arjun7n9s/AgriBot/CREDITS.md

# Credits

The SCARA base design is adapted from HowToMechatronics (https://howtomechatronics.com).

AgriBOT authored everything else here, including:
- the Arm 2 redesign
- the tomato cutter
- the side mast
- the rover integration
- the simulation assets and robot description
- all tooling and documentation

The original CAD is in `media/scara-arm/`. The meshes generated from it are in `sim/agribot_description/meshes/scara/`.
