arjun7n9s/AgriBot/notes.md

---
format: 2
description: AgriBOT tomato rover — hardware, bill of materials, and simulation.
taskPrefix: AB
---
## Tasks
### In Progress
- [ ] **AB-8** Desktop AgriBOT context folder on this machine
### For Review
- [ ] **AB-2** Install Ubuntu 22.04 on the 5060 so Isaac Sim 5.0 can run
- [ ] **AB-3** Place the OnlyScrews, Robocraze, Robokits, and Robu orders — [Hardware order list](/cursor/stores/bc-d1b8e747-87e9-4a20-9cfe-d9339460fb08/docs/hardware-order-list.docx)
- [ ] **AB-4** Redesign and print arm 2 and the gripper — [Already procured](/cursor/stores/bc-d1b8e747-87e9-4a20-9cfe-d9339460fb08/docs/already-procured.md)
- [ ] **AB-5** Name the forward and reverse header pins on the bench — [Board note](/cursor/stores/bc-d1b8e747-87e9-4a20-9cfe-d9339460fb08/docs/rover-control-board.md)
### Queued
- [ ] **AB-1** Funding bill of materials — [Bill of materials](/cursor/stores/bc-d1b8e747-87e9-4a20-9cfe-d9339460fb08/docs/bill-of-materials.docx)
- [ ] **AB-6** Field simulation on the two laptops — [Work pathway](/cursor/stores/bc-d1b8e747-87e9-4a20-9cfe-d9339460fb08/docs/work-plan.md)
### Done
- [x] **AB-7** Amazon order placed: limit switches, 6806-ZZ, 6807-ZZ, 51107, 51108, and the ESP32-S3
