arjun7n9s/AgriBot/docs/already-procured.md

# Already procured

Source copy: [already-procured-list.docx](already-procured-list.docx) (WhatsApp export `DOC-20260910-WA0005`).

The sheet title is **SCARA ARM — PURCHASED ITEMS**. It has one group, **Purchased List**, and one table. Columns in the source are No., Item, Specification, and Quantity.

**11 line items.** Price is blank on every row because the sheet has no price column. Shop is blank on every row because the sheet has no shop column. The document has no total.

## Purchased List

| No. | Item | Specification | Quantity | Price | Shop |
| --- | --- | --- | --- | --- | --- |
| 1 | Smooth rod shaft | 10 mm dia × 400 mm length | 4 pcs | blank | blank |
| 2 | Lead screw | 8 mm × 400 mm | 1 pc | blank | blank |
| 3 | Linear ball bearing (LM10LUU) | 10 mm bore × 19 mm OD × 29 mm long | 5 pcs | blank | blank |
| 4 | Deep groove ball bearing (608RS) | 8 × 22 × 7 mm, rubber sealed | 5 pcs | blank | blank |
| 5 | Thrust ball bearing | 35 mm × 52 mm × 12 mm | 2 pcs | blank | blank |
| 6 | Thrust ball bearing | 40 mm × 60 mm × 13 mm | 1 pc | blank | blank |
| 7 | NEMA17 stepper motor (economy) | 4.2 kg·cm, D-shaft, without gearbox | 2 pcs | blank | blank |
| 8 | NEMA17 stepper + DM542 driver kit | 7 kg·cm motor with DM542 digital microstepping driver (4.2 A, 18–50 V DC) | 1 set | blank | blank |
| 9 | NEMA17 stepper motor (premium) | 7 kg·cm, without gearbox | 1 pc | blank | blank |
| 10 | A4988 stepper motor driver | Carrier / breakout module | 4 pcs | blank | blank |
| 11 | MG996R digital servo motor | High-torque metal-gear servo | 2 pcs | blank | blank |

## Overlap with the still-to-buy list

Compared with `docs/hardware-order-list.docx`. That order list was not edited.

Two overlaps. Both are thrust bearings. The procured sheet gives dimensions and does not name 51107 or 51108. Those designations on the order list are the same sizes (51107 is 35 × 52 × 12 mm; 51108 is 40 × 60 × 13 mm). Quantities differ.

- Thrust ball bearing, 35 mm × 52 mm × 12 mm, **2 pcs** already bought — same size as order line **1 × 51107 thrust ball bearing**, ₹197.00, Amazon.in.
- Thrust ball bearing, 40 mm × 60 mm × 13 mm, **1 pc** already bought — same size as order line **2 × 51108 thrust ball bearing, 1 piece**, ₹440.00, Amazon.in.

No other procured line matches an order-list line. The order-list deep-groove bearings are 6806-ZZ and 6807-ZZ. The procured deep-groove bearing is 608RS (8 × 22 × 7 mm). Those are different sizes.
