arjun7n9s/AgriBot/internal/board-crosscheck.md

---
cursor:
  subagentId: "bc-b77851f0-87f7-55c2-8c64-350e7d4dbb0f"
---

# Independent photo cross-check

This is limited to what is visible in the supplied photos. It does not establish circuit functions, pinouts, copper connectivity, or radio protocol.

## Visible facts — vehicle controller

- The blue, two-sided PCB is marked `HH-8130K-RXT2` on both faces.
- The component side has two large aluminium heatsinks, a green disc component marked `2A104J`, a white multi-contact board-edge connector, several metal blade terminals, and two visible large electrolytic capacitors at one end.
- A large black housing is visibly marked `YX306H-S-112G`, `16A 250VAC`, and `16A 30VDC`. The manufacturer word above the part number appears to read `YONGSENG`.
- A metal-can component is visibly marked `16.000 MHz`.
- Two adjacent 8-pin ICs have the same visible top marking, `CSC2111FL`; their second-line marking appears to be `AVFay`.
- The controller's larger low-pin-count IC near the `16.000 MHz` can has an indistinct top code; its identity is unknown.
- The white connector's nearby individual pin labels are only partly legible in the oblique photo. They cannot be transcribed reliably.
- The reverse side visibly has routed copper traces, plated through-holes, and the through-hole solder joints for the connector, heatsinks/terminals, and other parts. A full trace map cannot be determined from these photos.

## Visible facts — handheld controller

- The green PCB is marked `HH-6611YTX-B-YB` and `JY14155`.
- It has six visibly labelled tactile buttons: `F`, `S`, `B`, `P`, `R`, and `M`.
- It has battery contacts marked `+` and `−`.
- Three LED reference designators are visible: `LED1`, `LED2`, and `LED3`.
- A metal-can component is marked `16.000 MHz`; the nearby IC has a partially legible code that appears to begin `2537`, but the complete marking is unknown.
- The remote PCB is shown only on its component side. No protocol, operating frequency, antenna connection, or pairing method is visible or established by these photos.

## Questions for Tejesh

1. Please take a level, sharply focused macro photo of the controller component side with the heatsinks and terminals not obscuring the IC markings or silkscreen. In particular, the main IC's complete top marking is unknown.
2. Please take a straight-on macro of the white controller connector, including every pin label and the connector face with its plug fitted. Which vehicle-harness wire colour goes to each position is unknown.
3. Please photograph the controller installed in the vehicle with every blade terminal connected, showing wire colours and destination (battery, each motor, switches, etc.). The terminal functions cannot be inferred from the bare board photos.
4. Please provide a sharp photo of both sides of the handheld-controller PCB, especially any antenna, wire, or component not visible on the photographed side. Its radio/protocol details are unknown.
5. Please state the battery-pack voltage and the exact vehicle/controller product markings. They are not visible in the supplied photos.
