arjun7n9s/AgriBot/internal/board-routing-crosscheck.md

---
cursor:
  subagentId: "bc-b77851f0-87f7-55c2-8c64-350e7d4dbb0f"
---

# Independent routing-photo cross-check — full re-read

This report is based only on the twelve files listed below. It records visible copper, parts, and markings; it does not establish pinouts, complete nets, component functions, or protocol.

## Files opened

- `routing-01.png`
- `routing-02.png`
- `routing-03.png`
- `routing-04.png`
- `routing-05.png`
- `routing-06.png`
- `routing-07.png`
- `routing-08.png`
- `routing-09.png`
- `routing-10.png`
- `routing-11.png`
- `routing-12.png`

## Markings transcribed from the photos

- PCB: `HH-8130K-RXT2`.
- Large black rectangular part: `YONGSENG`, `YX306H-S-112G`, `16A 250VAC`, and `16A 30VDC`.
- Blade-terminal area in routing-10: `+/−` is legible beside the leftmost of the three visible blade-terminal groups along the lower edge (white multi-contact connector at the upper left).
- Small white two-contact connector in the lower-right of routing-10: `RA`.

The other two blade-terminal-group labels are **unknown**. The images do not resolve their complete characters, so `F1B` and `F1A` are not retained as transcriptions.

## Visible copper observations

- Both PCB faces are shown. The reverse face is clearest in `routing-11.png` and `routing-12.png`.
- On that reverse face, a set of narrow, parallel trace segments is visible from the vertical row of solder joints at the right side of the image, continuing around the lower portion toward nearby through-hole-pad groups. Their complete endpoints are unknown.
- A separate long trace segment is visible close to the lower board edge. It passes between/near several lower pad groups; its complete route and net are unknown.
- Broader copper features and many vias are visible around the large through-hole pad regions on the reverse face. Their full interconnections are unknown.
- Backlighting in `routing-02.png` through `routing-07.png` reveals some narrow component-side traces near the white multi-contact connector, but parts, heatsinks, shadow, and glare hide several junctions. Complete routes are unknown.

## Unknowns and questions for Tejesh

1. The exact silkscreen at the middle and right blade-terminal groups is unknown. Please take a square-on macro of those labels under diffuse light.
2. The individual labels and pin count for the large white multi-contact connector are unknown. Please photograph its face and adjacent silkscreen sharply, preferably with the mating plug fitted.
3. The visible trace segments do not establish complete nets or connector-to-terminal connections. Please provide continuity readings from each connector contact and blade-terminal pad to the first exposed trace/pad, or clear unobstructed photos of those transitions.
4. Copper and component markings hidden by the heatsinks are unknown. If safe, please provide additional angled photos that expose the obscured pads and markings.
