arjun7n9s/AgriBot/docs/already-procured-list.docx

SCARA ARM — PURCHASED ITEMS

Purchased List

No. | Item | Specification | Quantity
1 | Smooth rod shaft | 10 mm dia × 400 mm length | 4 pcs
2 | Lead screw | 8 mm × 400 mm | 1 pc
3 | Linear ball bearing (LM10LUU) | 10 mm bore × 19 mm OD × 29 mm long | 5 pcs
4 | Deep groove ball bearing (608RS) | 8 × 22 × 7 mm, rubber sealed | 5 pcs
5 | Thrust ball bearing | 35 mm × 52 mm × 12 mm | 2 pcs
6 | Thrust ball bearing | 40 mm × 60 mm × 13 mm | 1 pc
7 | NEMA17 stepper motor (economy) | 4.2 kg·cm, D-shaft, without gearbox | 2 pcs
8 | NEMA17 stepper + DM542 driver kit | 7 kg·cm motor with DM542 digital microstepping driver (4.2 A, 18–50 V DC) | 1 set
9 | NEMA17 stepper motor (premium) | 7 kg·cm, without gearbox | 1 pc
10 | A4988 stepper motor driver | Carrier / breakout module | 4 pcs
11 | MG996R digital servo motor | High-torque metal-gear servo | 2 pcs

SCARA Arm — Purchased Items
