arjun7n9s/AgriBot/docs/images/end_effector_front.png

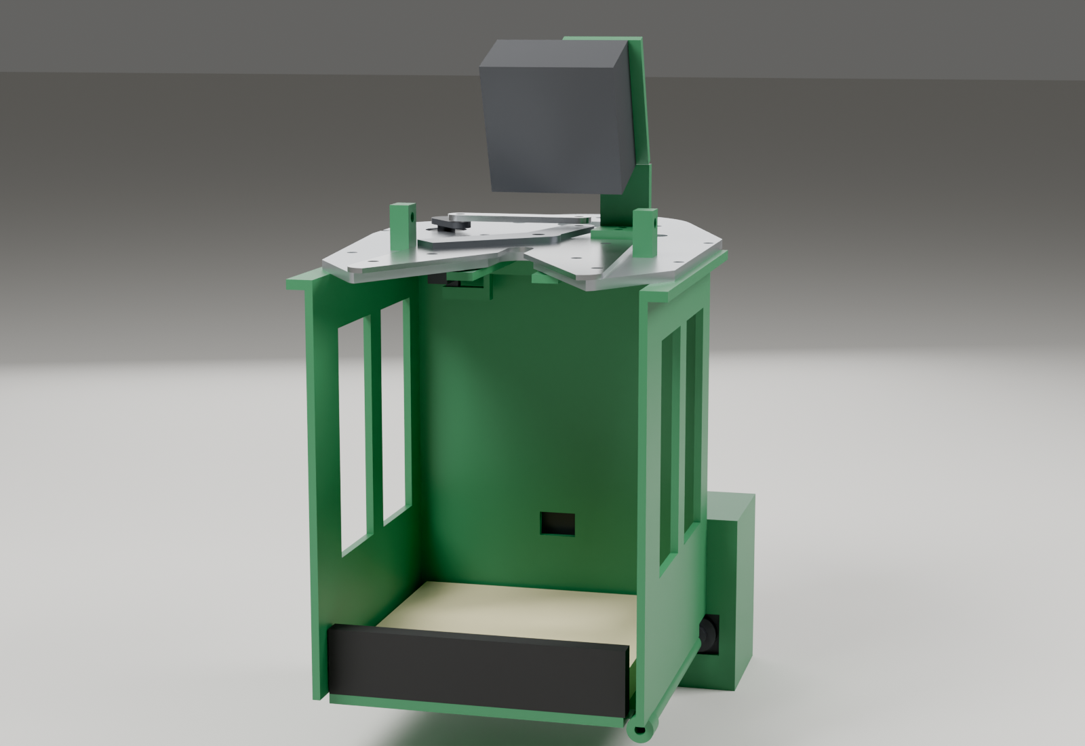
docs/images/end_effector_front.png
