arjun7n9s/AgriBot/docs/images/scara_preview.png

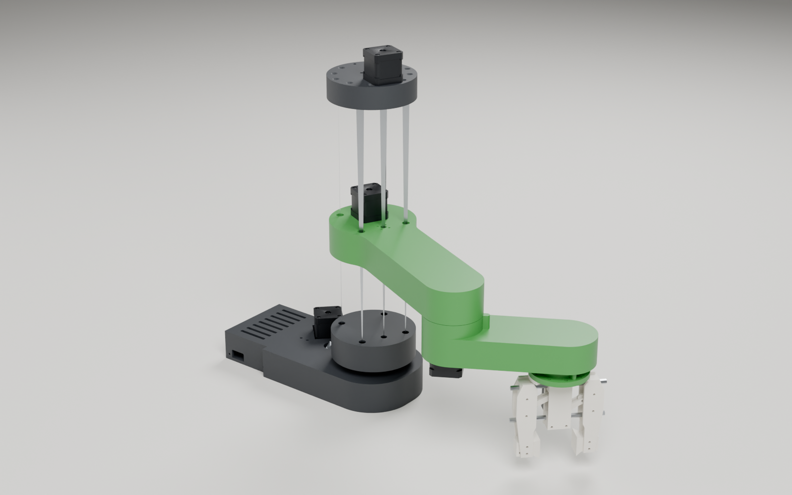
docs/images/scara_preview.png
