arjun7n9s/AgriBot/docs/images/tomato_plant.png

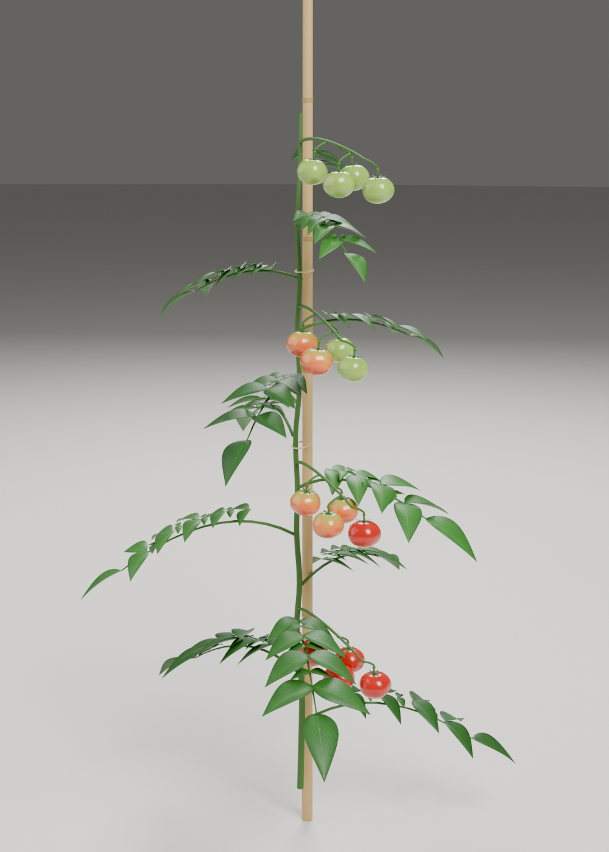
docs/images/tomato_plant.png
