arjun7n9s/AgriBot/media/motor-controller/image-1791056318386.jpg

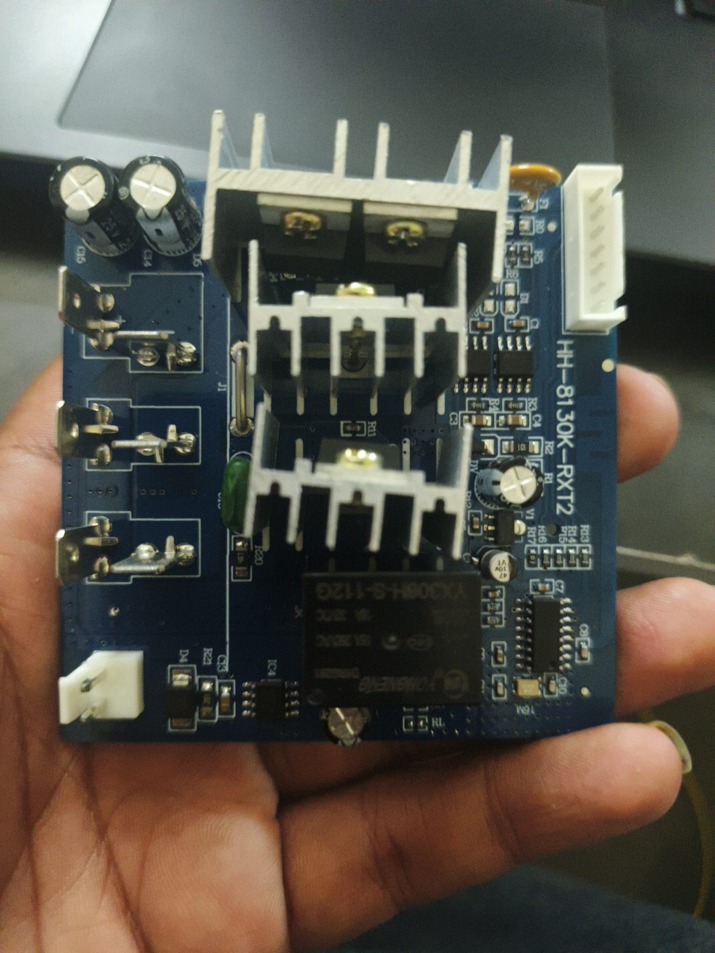
media/motor-controller/image-1791056318386.jpg
