arjun7n9s/AgriBot/media/motor-controller/IMG_20261004_010436_945.jpg

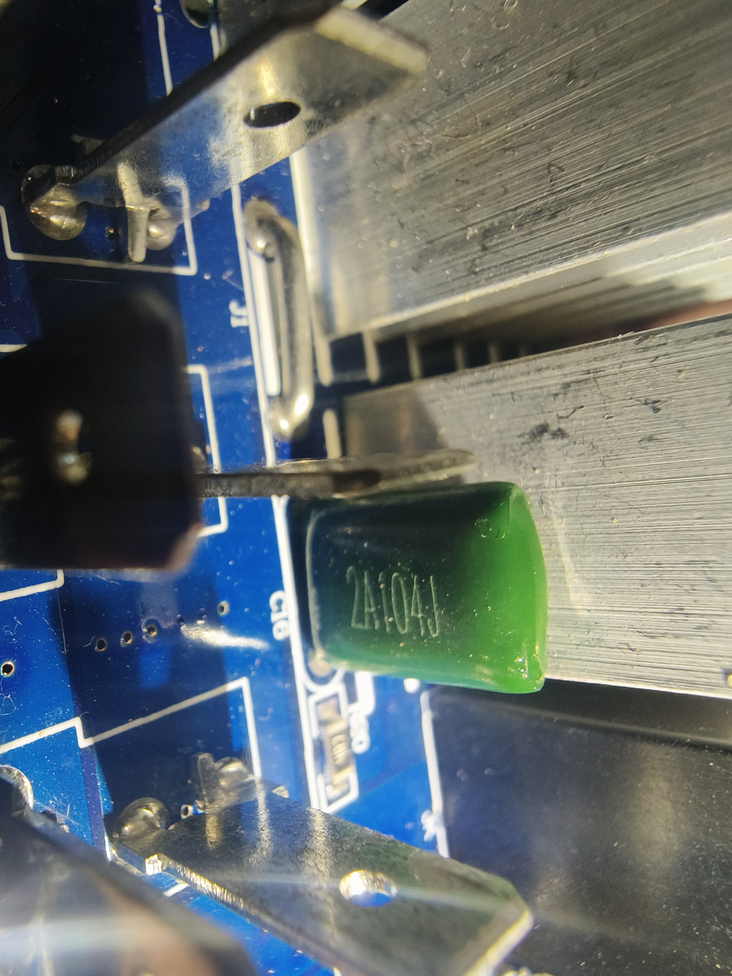
media/motor-controller/IMG_20261004_010436_945.jpg
