arjun7n9s/AgriBot/media/motor-controller/IMG_20261004_010446_893.jpg

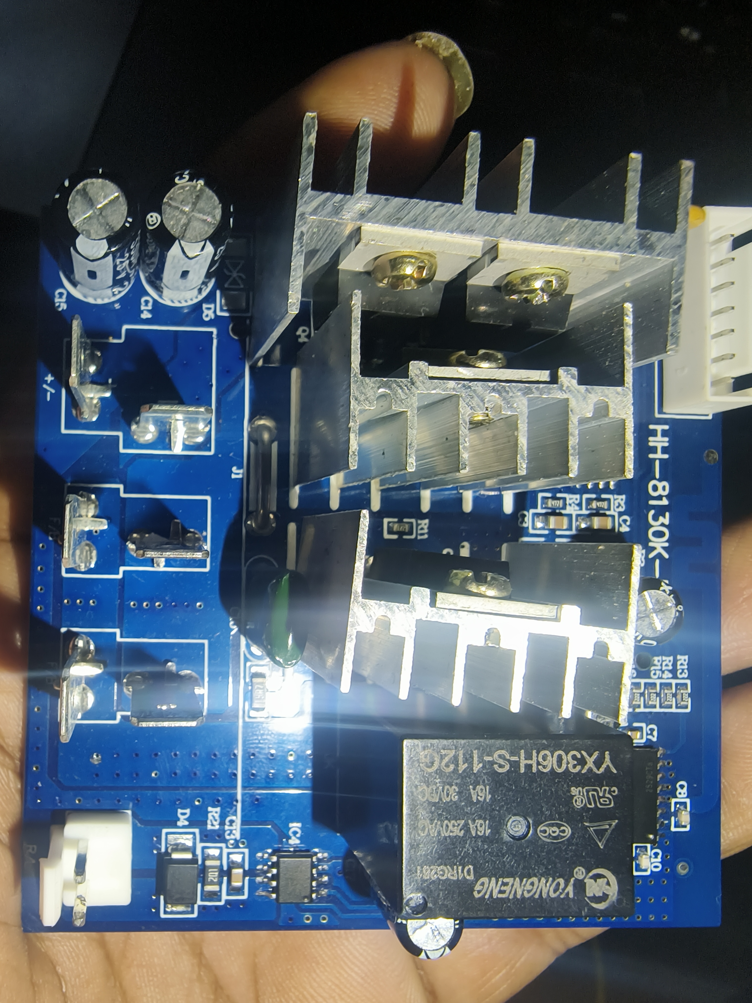
media/motor-controller/IMG_20261004_010446_893.jpg
