arjun7n9s/AgriBot/media/motor-controller/IMG_20261004_010451_744.jpg

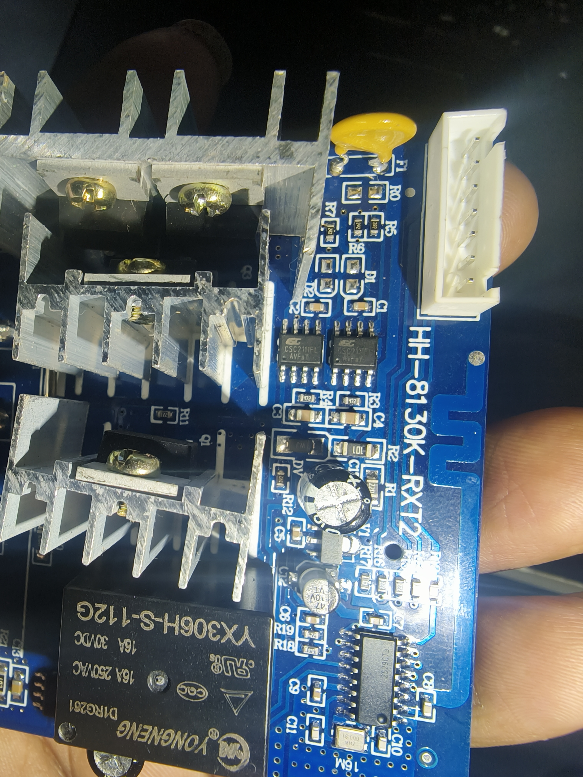
media/motor-controller/IMG_20261004_010451_744.jpg
