arjun7n9s/AgriBot/media/motor-controller/IMG_20261004_010502_342.jpg

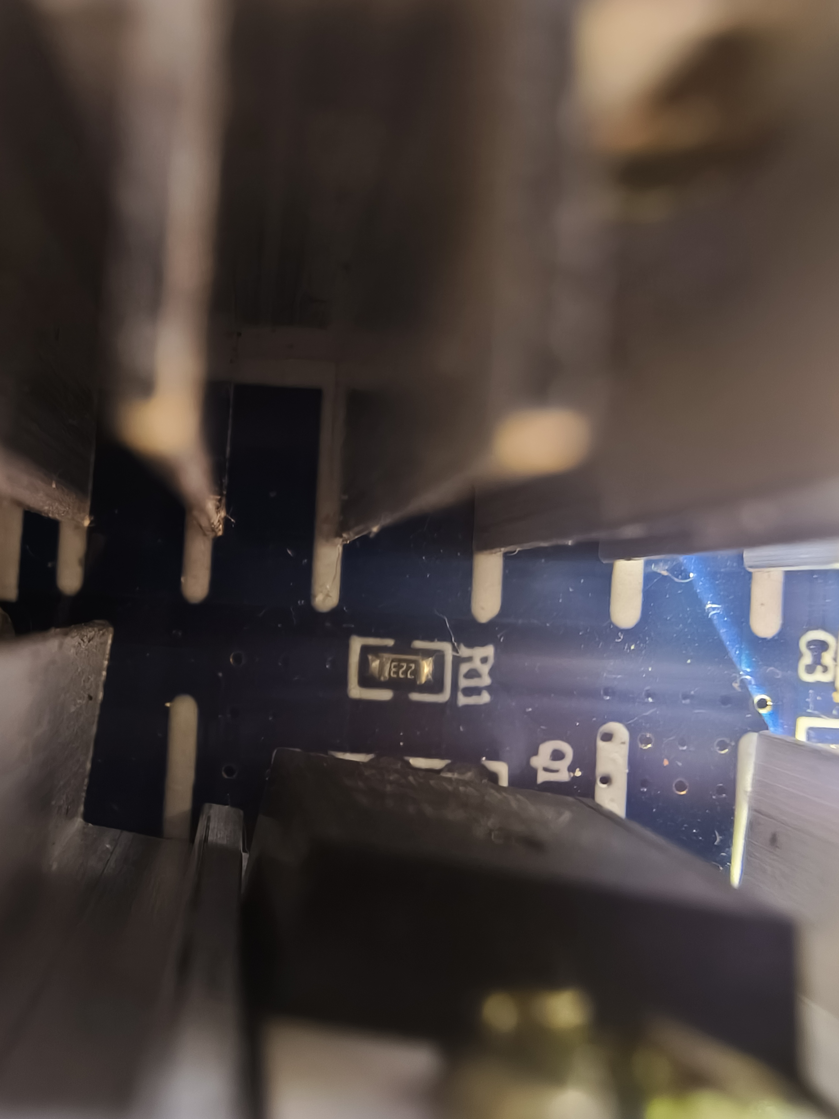
media/motor-controller/IMG_20261004_010502_342.jpg
