arjun7n9s/AgriBot/media/motor-controller/IMG_20261004_010509_731.jpg

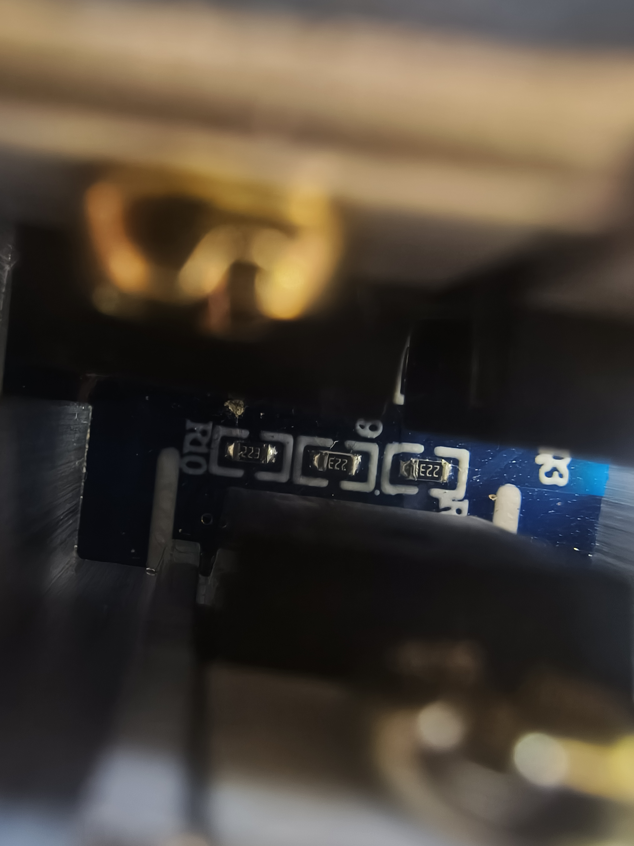
media/motor-controller/IMG_20261004_010509_731.jpg
