arjun7n9s/AgriBot/media/motor-controller/IMG_20261004_010517_841.jpg

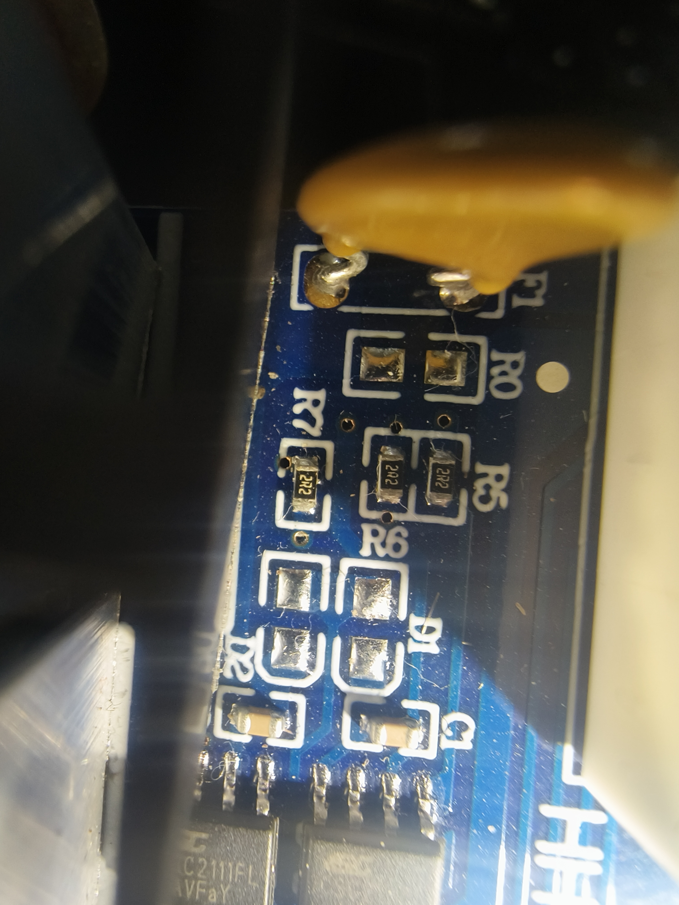
media/motor-controller/IMG_20261004_010517_841.jpg
