arjun7n9s/AgriBot/media/motor-controller/IMG_20261004_010523_438.jpg

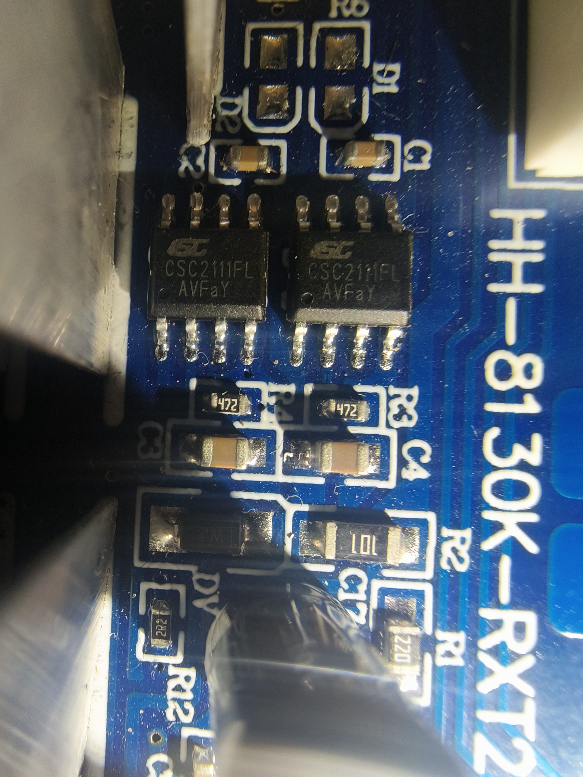
media/motor-controller/IMG_20261004_010523_438.jpg
