arjun7n9s/AgriBot/media/motor-controller/IMG_20261004_010541_978.jpg

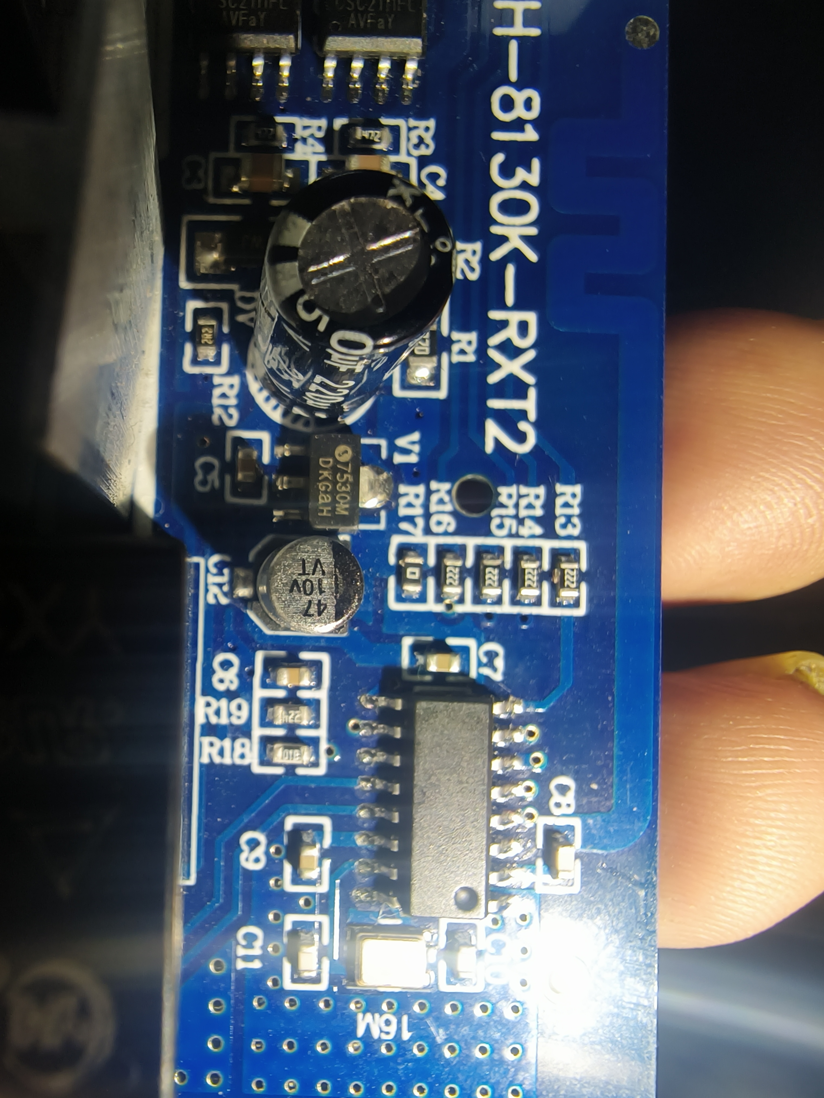
media/motor-controller/IMG_20261004_010541_978.jpg
