arjun7n9s/AgriBot/media/motor-controller/IMG_20261004_010549_902.jpg

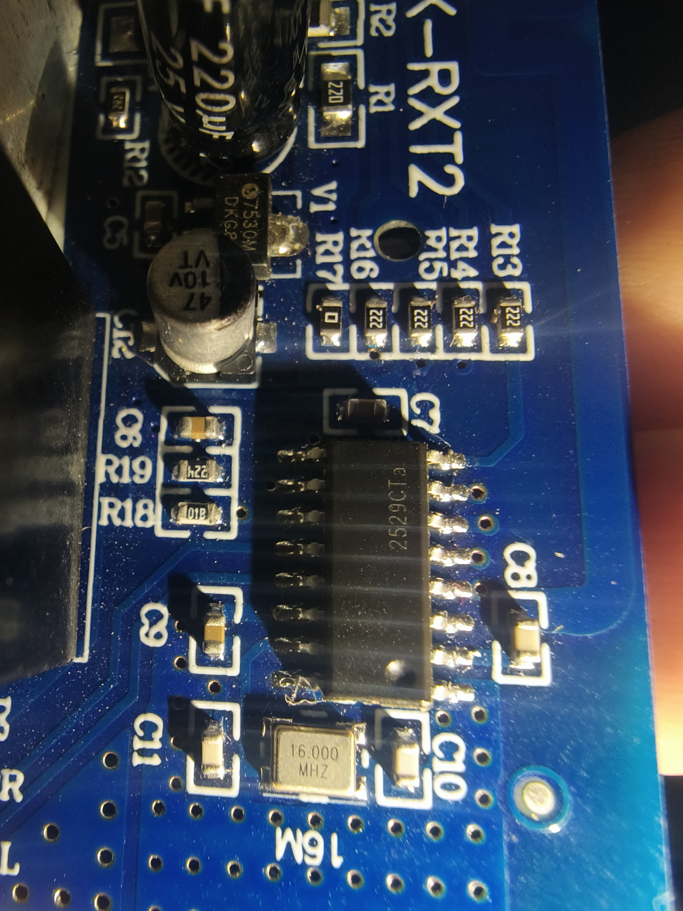
media/motor-controller/IMG_20261004_010549_902.jpg
