arjun7n9s/AgriBot/media/motor-controller/IMG_20261004_010600_459.jpg

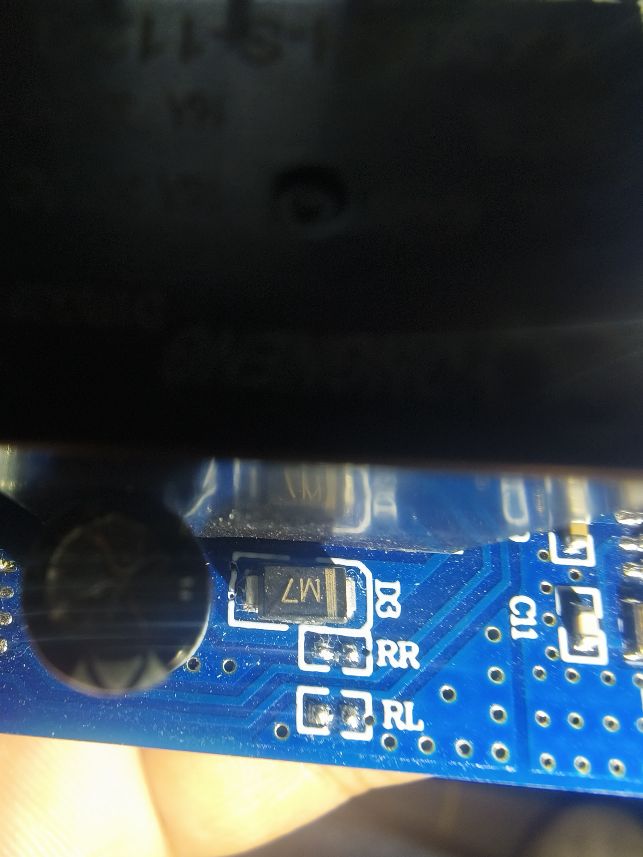
media/motor-controller/IMG_20261004_010600_459.jpg
