arjun7n9s/AgriBot/media/motor-controller/IMG_20261004_010603_548.jpg

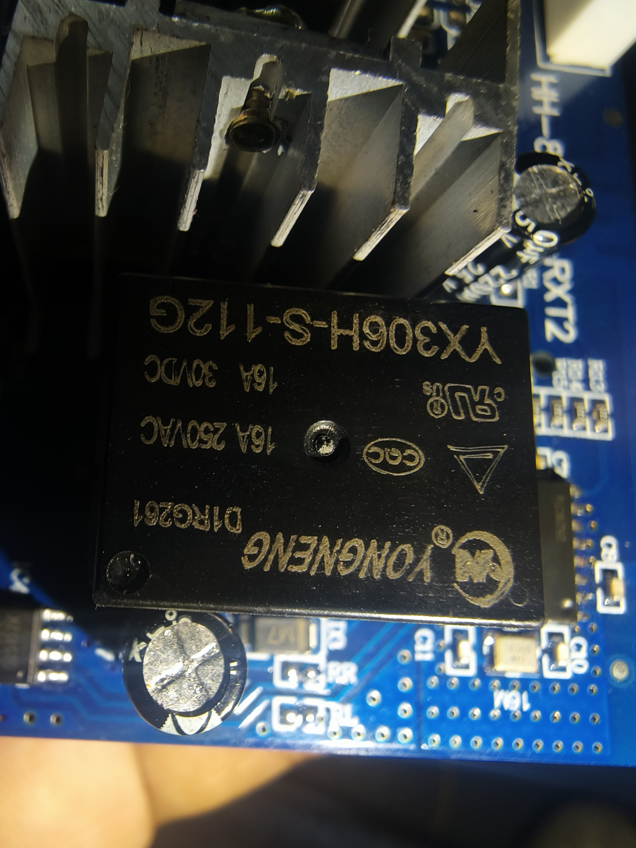
media/motor-controller/IMG_20261004_010603_548.jpg
