arjun7n9s/AgriBot/media/motor-controller/IMG_20261004_010609_928.jpg

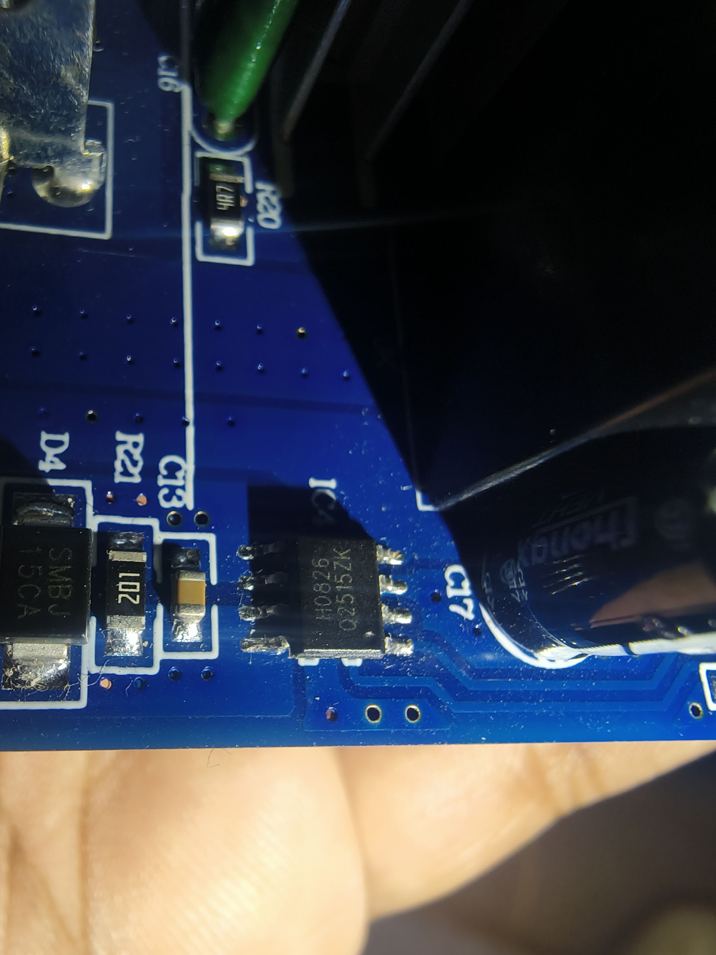
media/motor-controller/IMG_20261004_010609_928.jpg
