arjun7n9s/AgriBot/media/motor-controller/IMG_20261004_010615_297.jpg

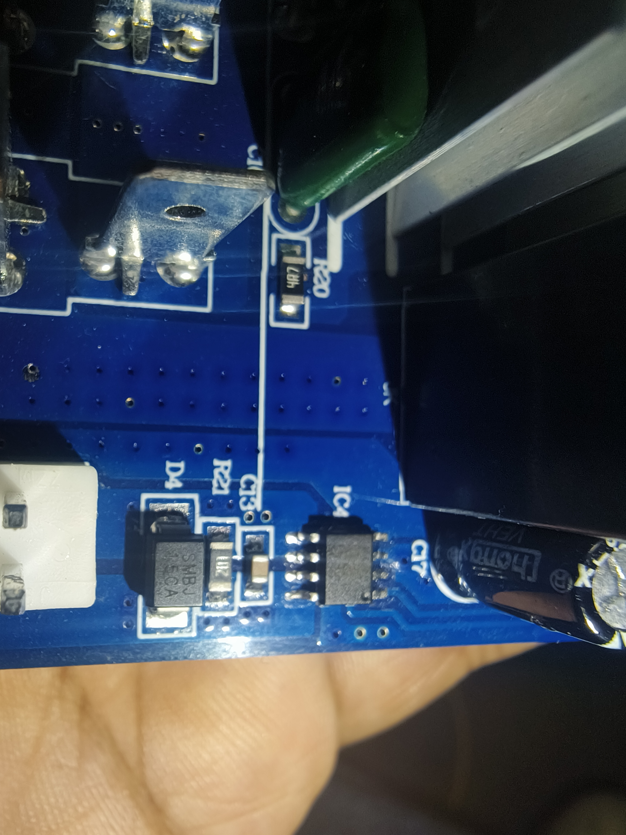
media/motor-controller/IMG_20261004_010615_297.jpg
