arjun7n9s/AgriBot/media/motor-controller/IMG_20261004_010623_569.jpg

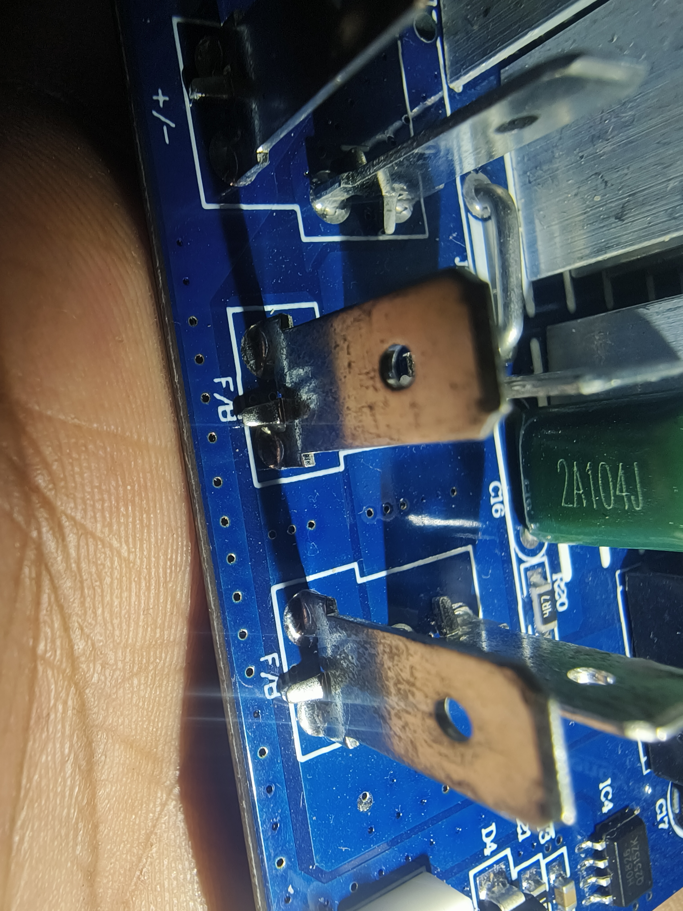
media/motor-controller/IMG_20261004_010623_569.jpg
