arjun7n9s/AgriBot/media/motor-controller/IMG_20261004_010630_412.jpg

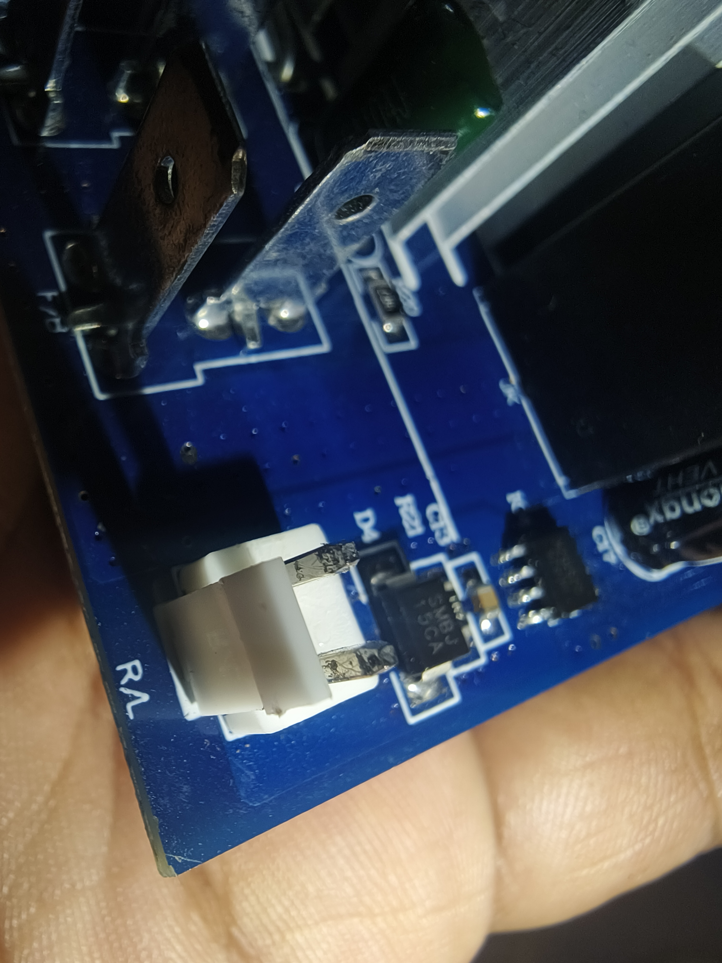
media/motor-controller/IMG_20261004_010630_412.jpg
