arjun7n9s/AgriBot/media/motor-controller/IMG_20261004_010646_813.jpg

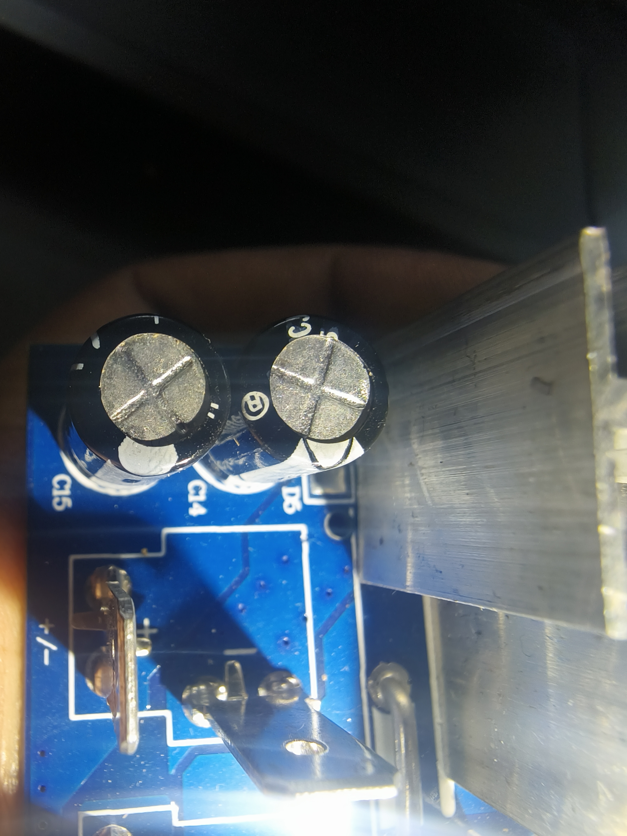
media/motor-controller/IMG_20261004_010646_813.jpg
