arjun7n9s/AgriBot/media/motor-controller/IMG_20261004_010655_627.jpg

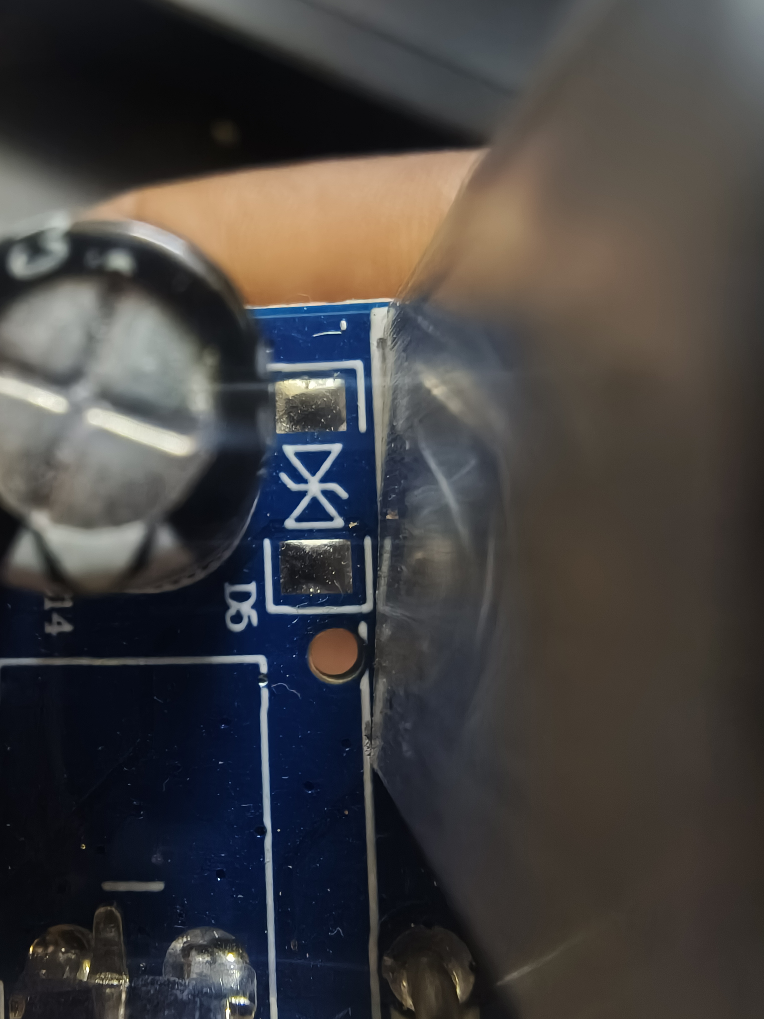
media/motor-controller/IMG_20261004_010655_627.jpg
