arjun7n9s/AgriBot/media/motor-controller/IMG_20261004_010718_033.jpg

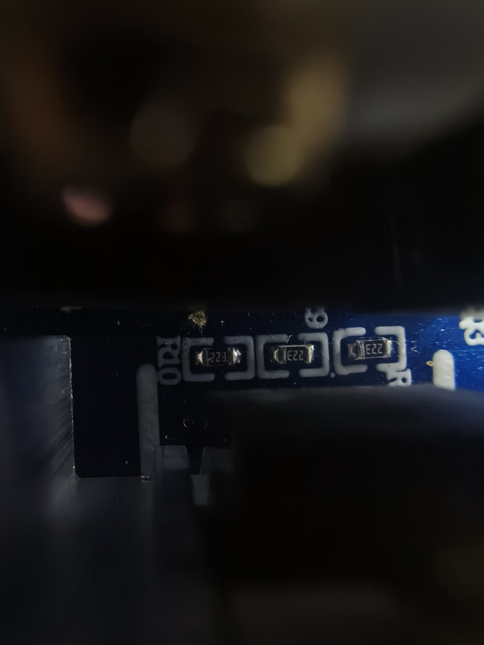
media/motor-controller/IMG_20261004_010718_033.jpg
