arjun7n9s/AgriBot/media/motor-controller/IMG_20261004_010724_122.jpg

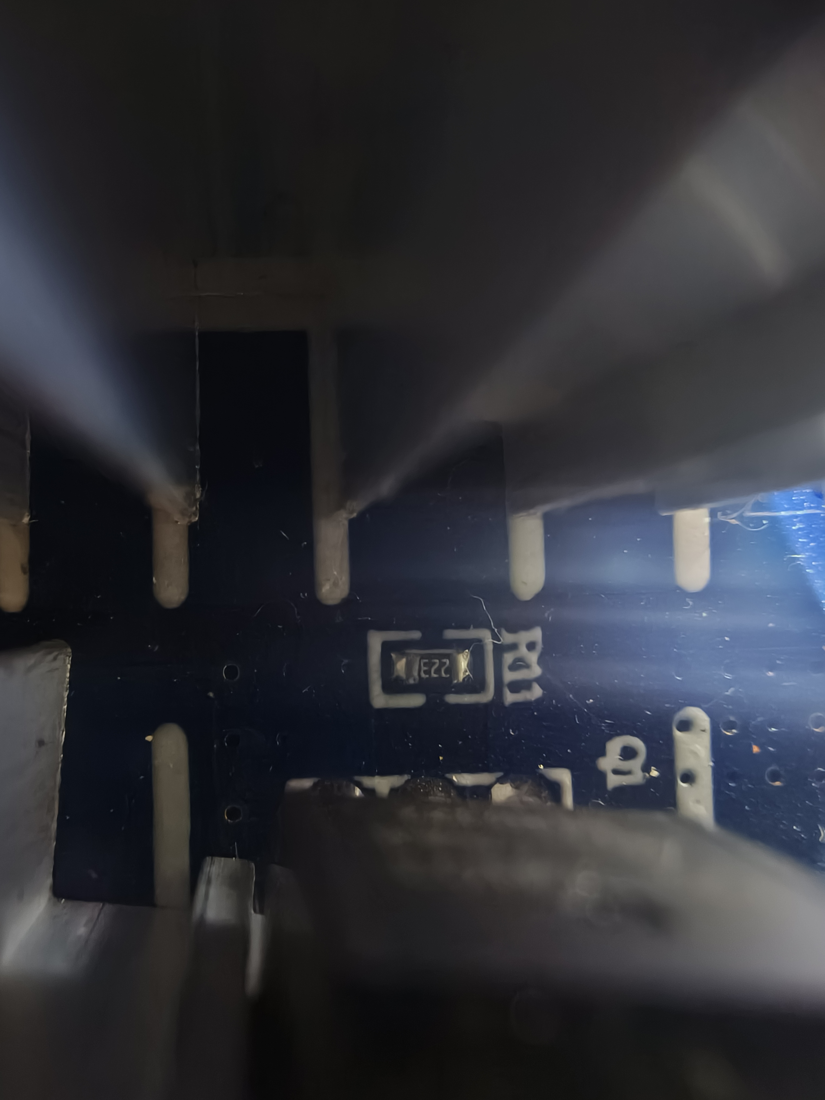
media/motor-controller/IMG_20261004_010724_122.jpg
