arjun7n9s/AgriBot/media/motor-controller/IMG_20261004_010734_288.jpg

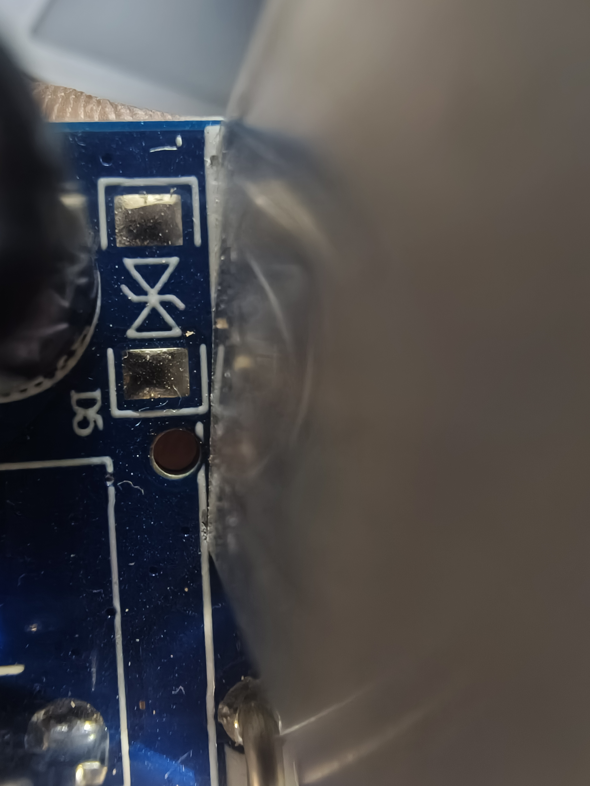
media/motor-controller/IMG_20261004_010734_288.jpg
