arjun7n9s/AgriBot/media/motor-controller/IMG_20261004_010740_824.jpg

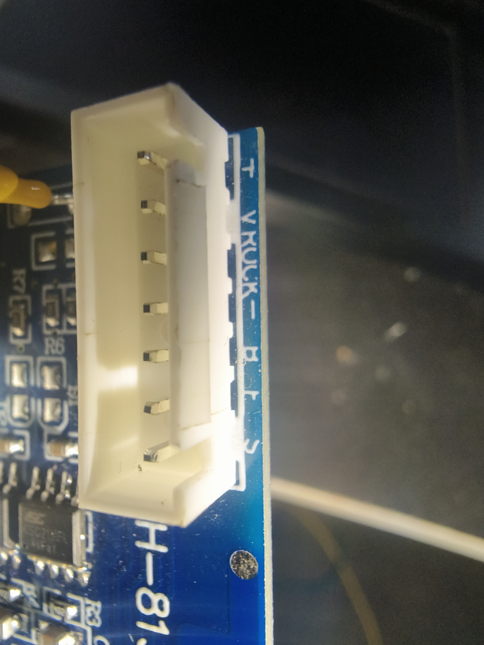
media/motor-controller/IMG_20261004_010740_824.jpg
