arjun7n9s/AgriBot/media/motor-controller/IMG_20261004_011541_157.jpg

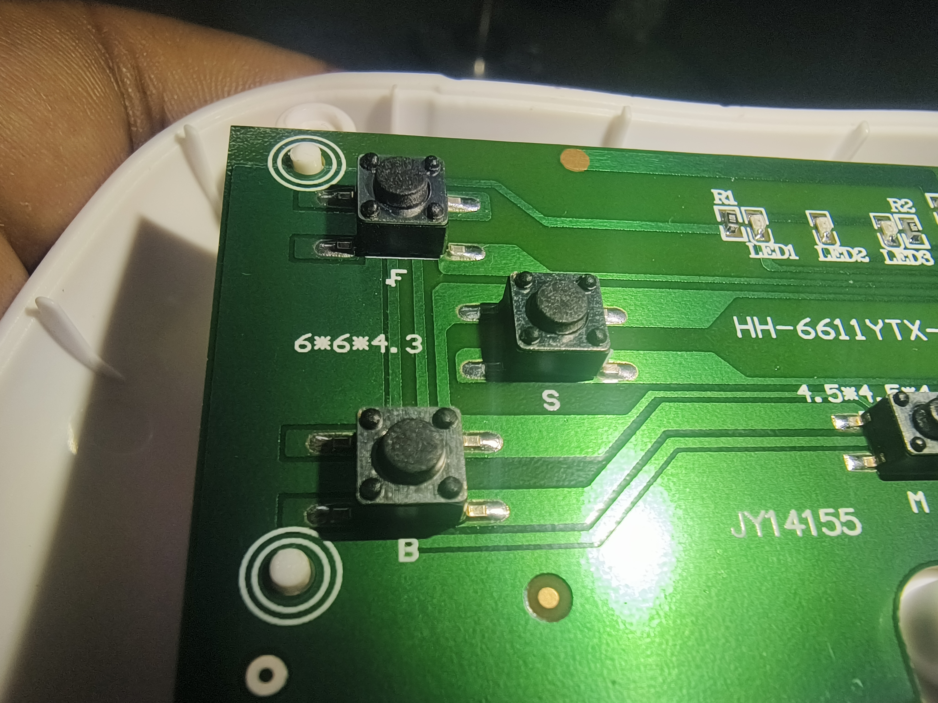
media/motor-controller/IMG_20261004_011541_157.jpg
