arjun7n9s/AgriBot/media/motor-controller/IMG_20261004_012317_026.jpg

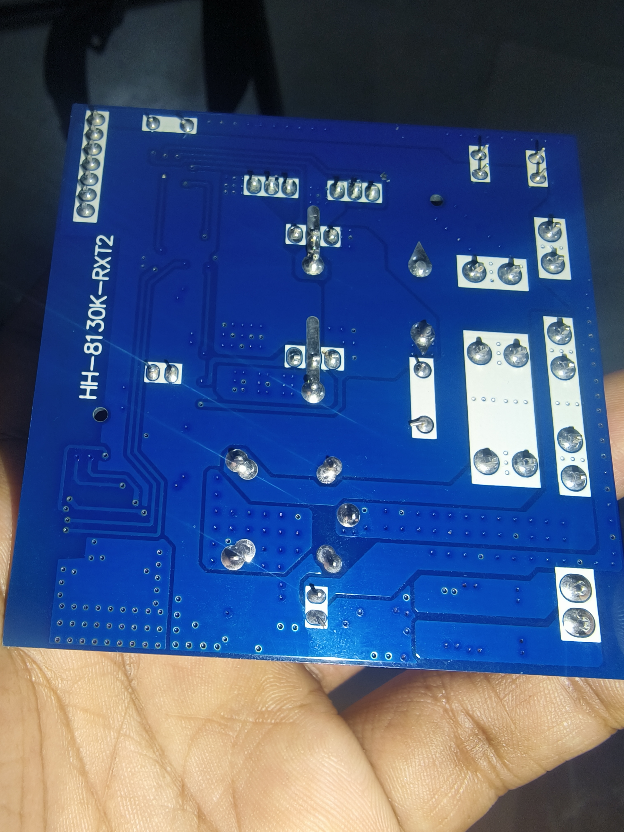
media/motor-controller/IMG_20261004_012317_026.jpg
