arjun7n9s/AgriBot/media/motor-controller/IMG_20261004_012351_393.jpg

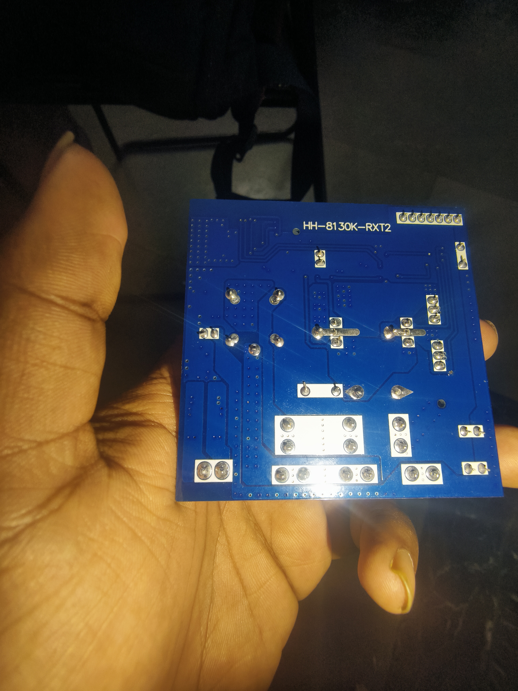
media/motor-controller/IMG_20261004_012351_393.jpg
