arjun7n9s/AgriBot/media/motor-controller/IMG_20261004_012412_682.jpg

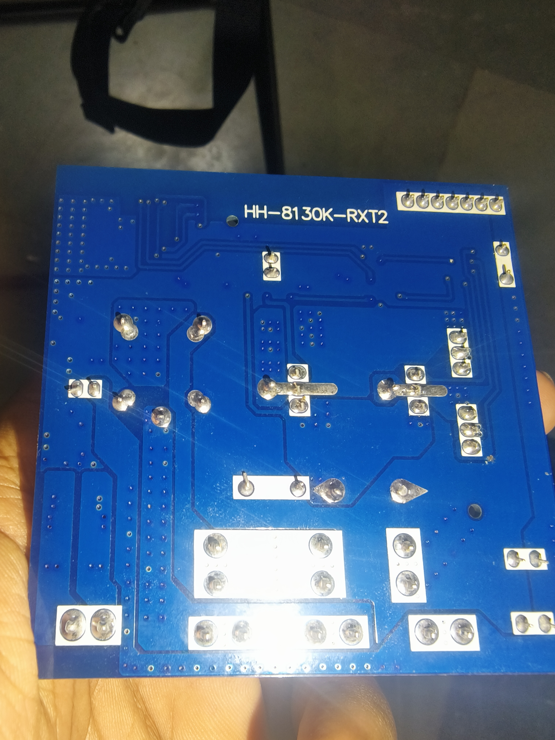
media/motor-controller/IMG_20261004_012412_682.jpg
