arjun7n9s/AgriBot/media/motor-controller/IMG_20261004_012418_883.jpg

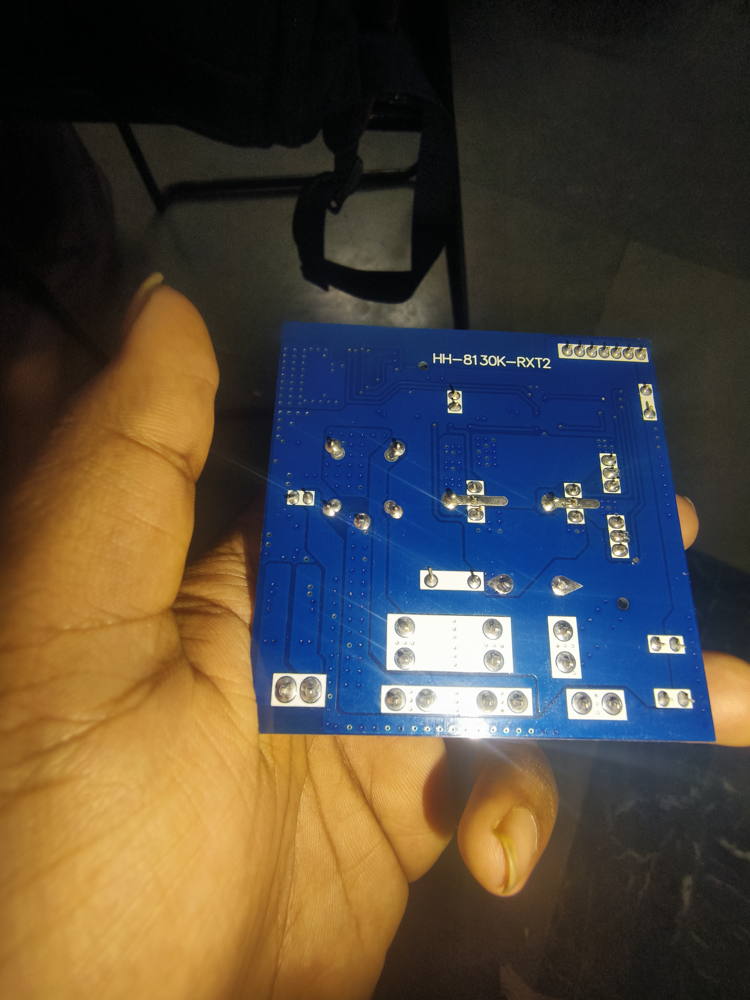
media/motor-controller/IMG_20261004_012418_883.jpg
