arjun7n9s/AgriBot/media/motor-controller/remote/IMG-20261004-WA0001.jpg

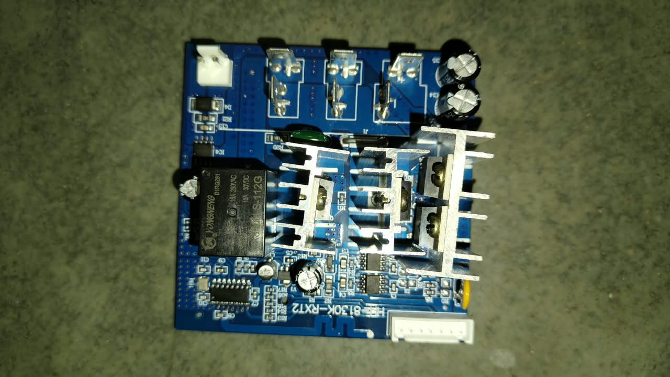
media/motor-controller/remote/IMG-20261004-WA0001.jpg
