arjun7n9s/AgriBot/media/motor-controller/remote/IMG_20261004_011520_020.jpg

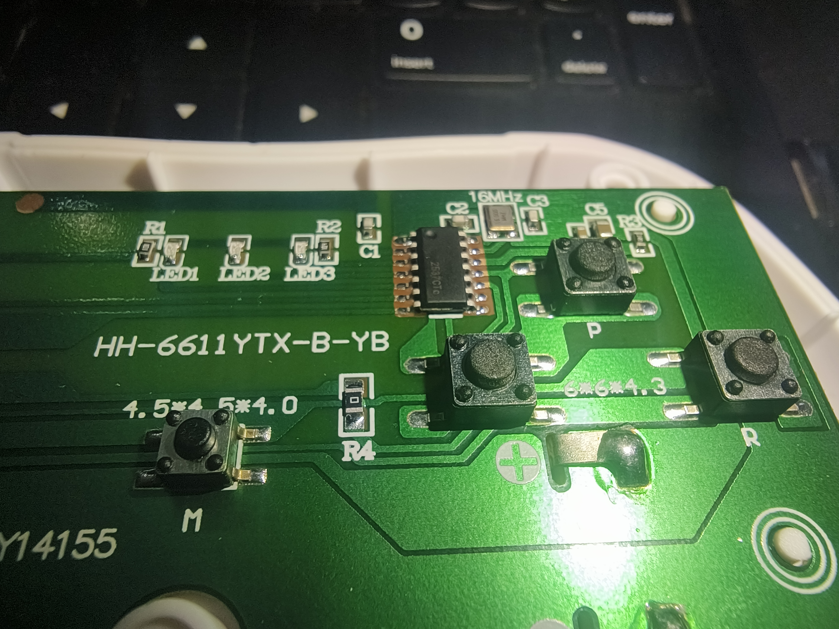
media/motor-controller/remote/IMG_20261004_011520_020.jpg
