arjun7n9s/AgriBot/media/motor-controller/remote/IMG_20261004_011618_792.jpg

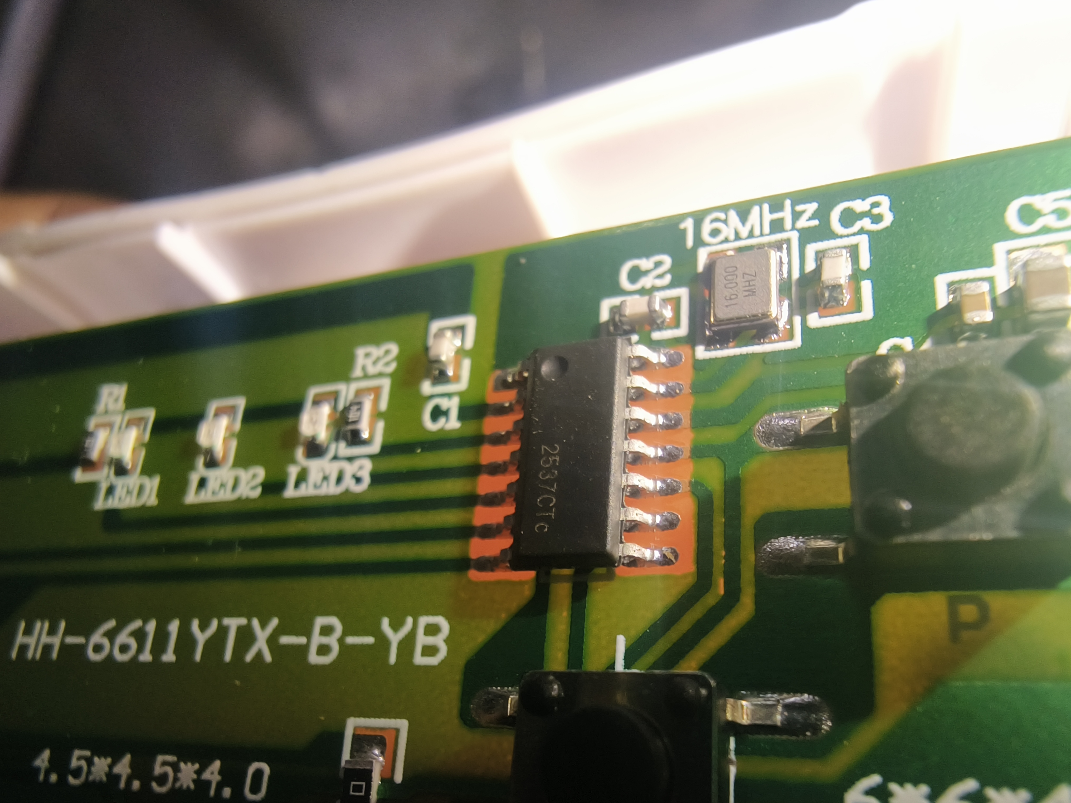
media/motor-controller/remote/IMG_20261004_011618_792.jpg
