arjun7n9s/AgriBot/media/motor-controller/routing/routing-01.png

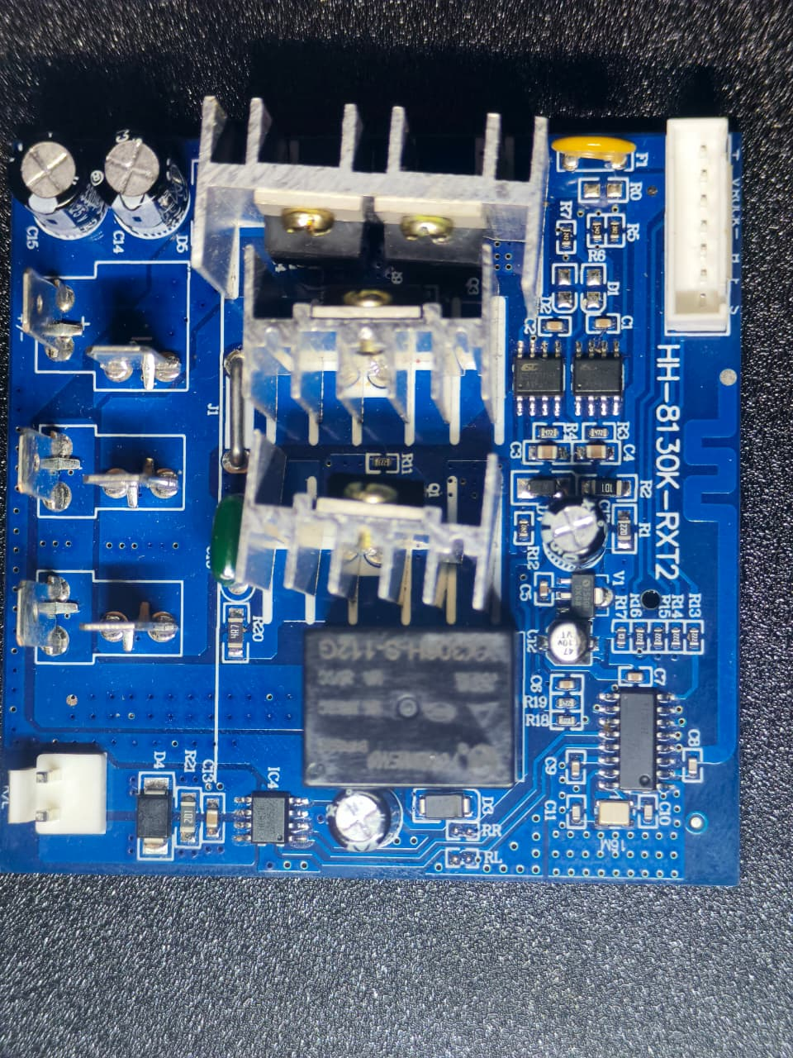
media/motor-controller/routing/routing-01.png
