arjun7n9s/AgriBot/media/motor-controller/routing/routing-02.png

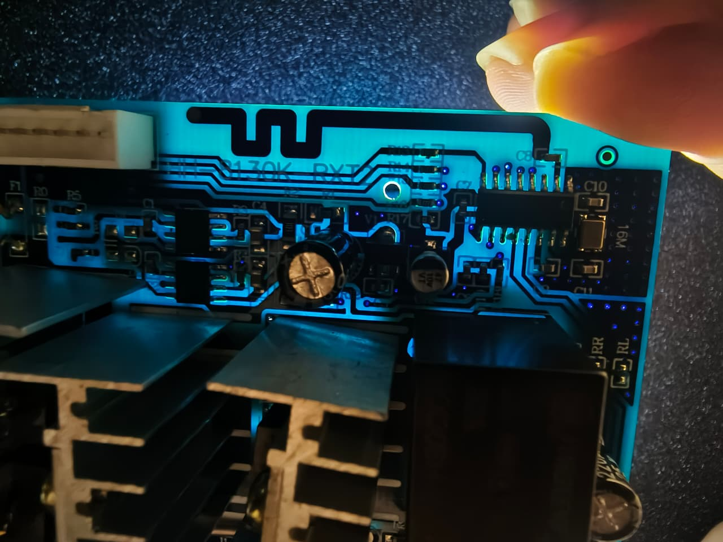
media/motor-controller/routing/routing-02.png
