arjun7n9s/AgriBot/media/motor-controller/routing/routing-03.png

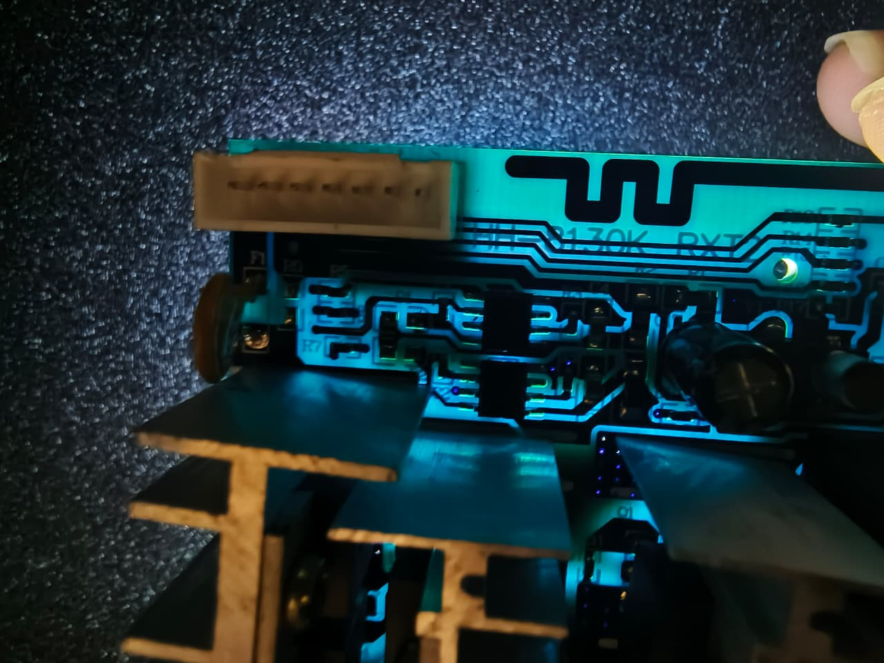
media/motor-controller/routing/routing-03.png
