arjun7n9s/AgriBot/media/motor-controller/routing/routing-04.png

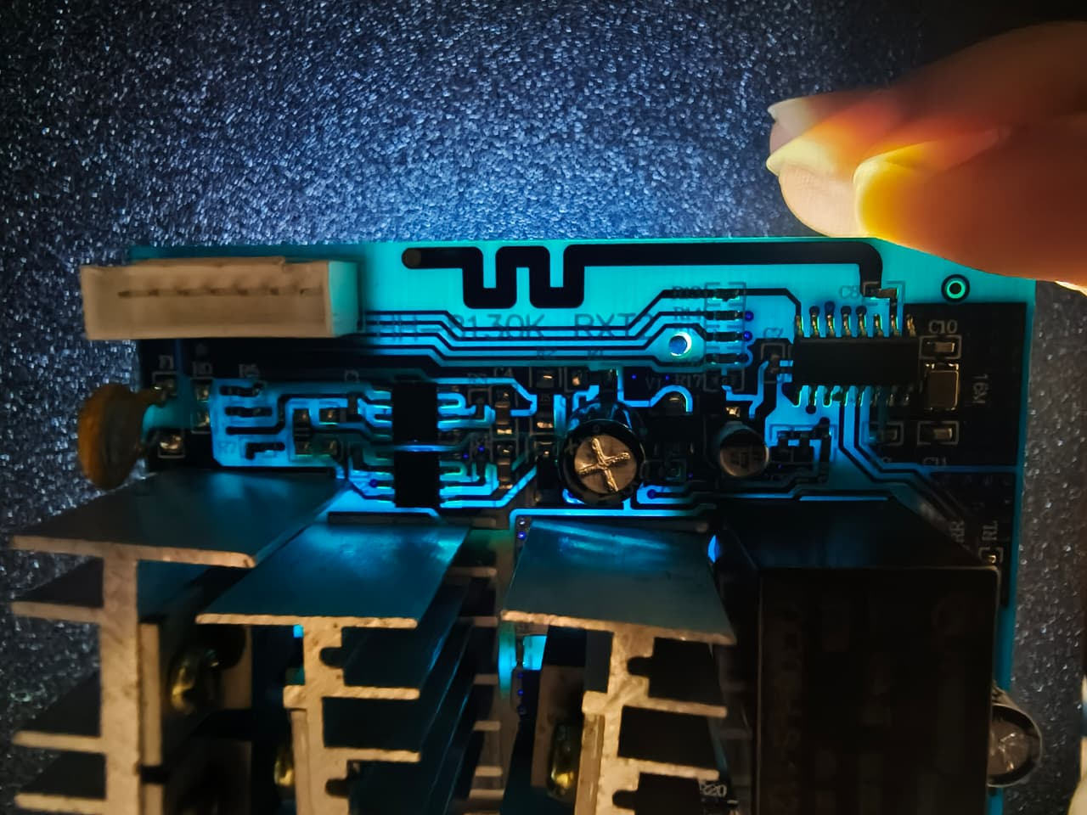
media/motor-controller/routing/routing-04.png
