arjun7n9s/AgriBot/media/motor-controller/routing/routing-05.png

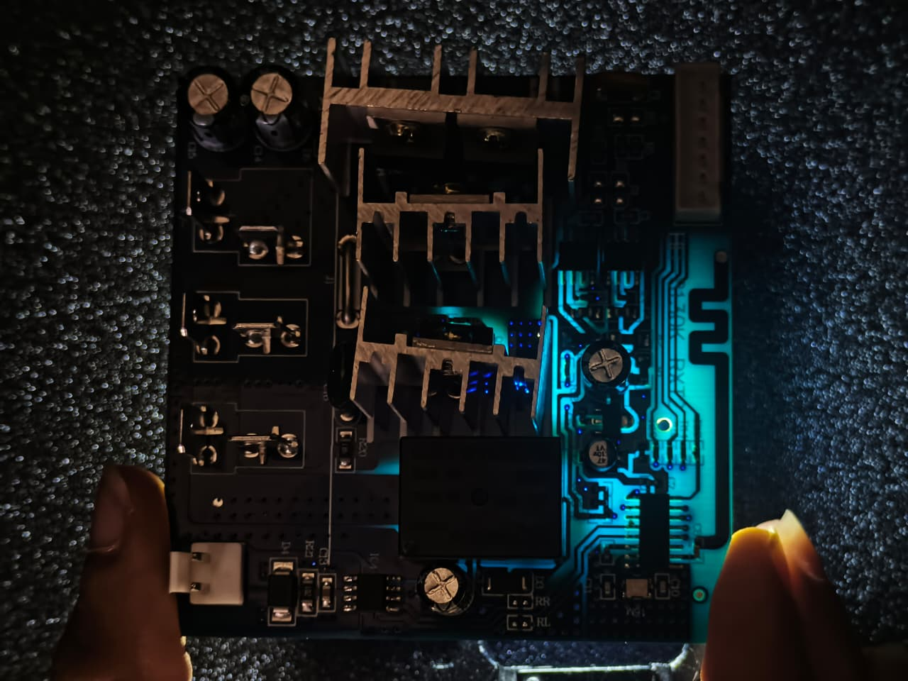
media/motor-controller/routing/routing-05.png
