arjun7n9s/AgriBot/media/motor-controller/routing/routing-06.png

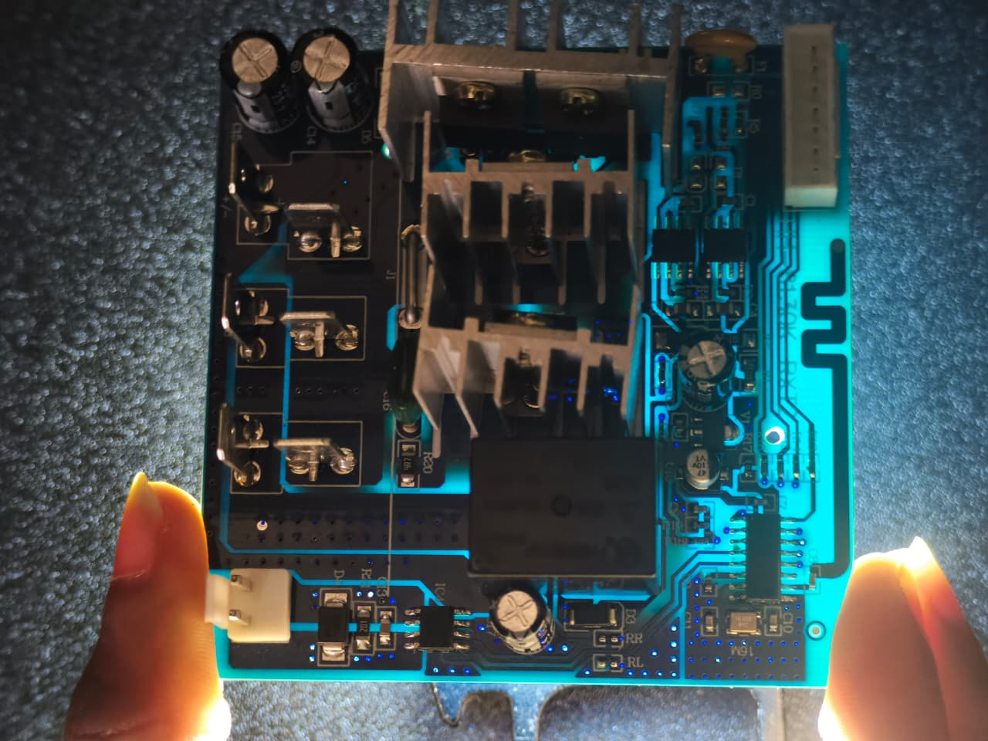
media/motor-controller/routing/routing-06.png
