arjun7n9s/AgriBot/media/motor-controller/routing/routing-07.png

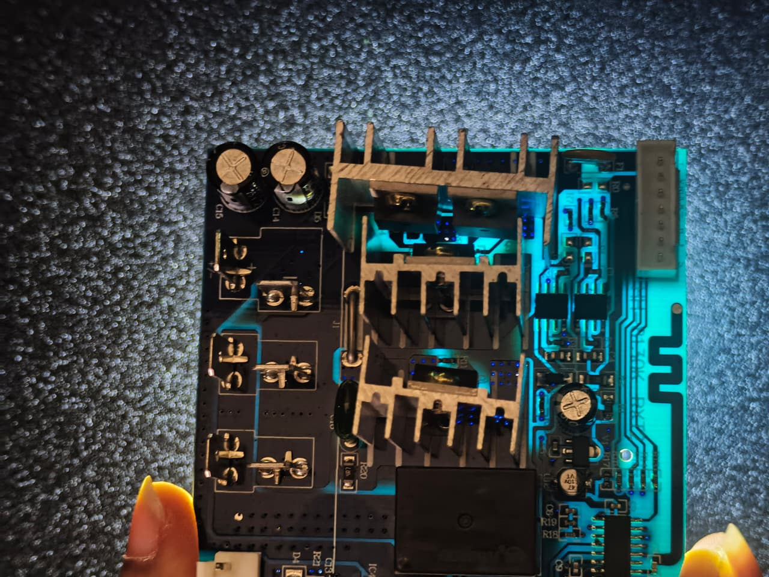
media/motor-controller/routing/routing-07.png
