arjun7n9s/AgriBot/media/motor-controller/routing/routing-08.png

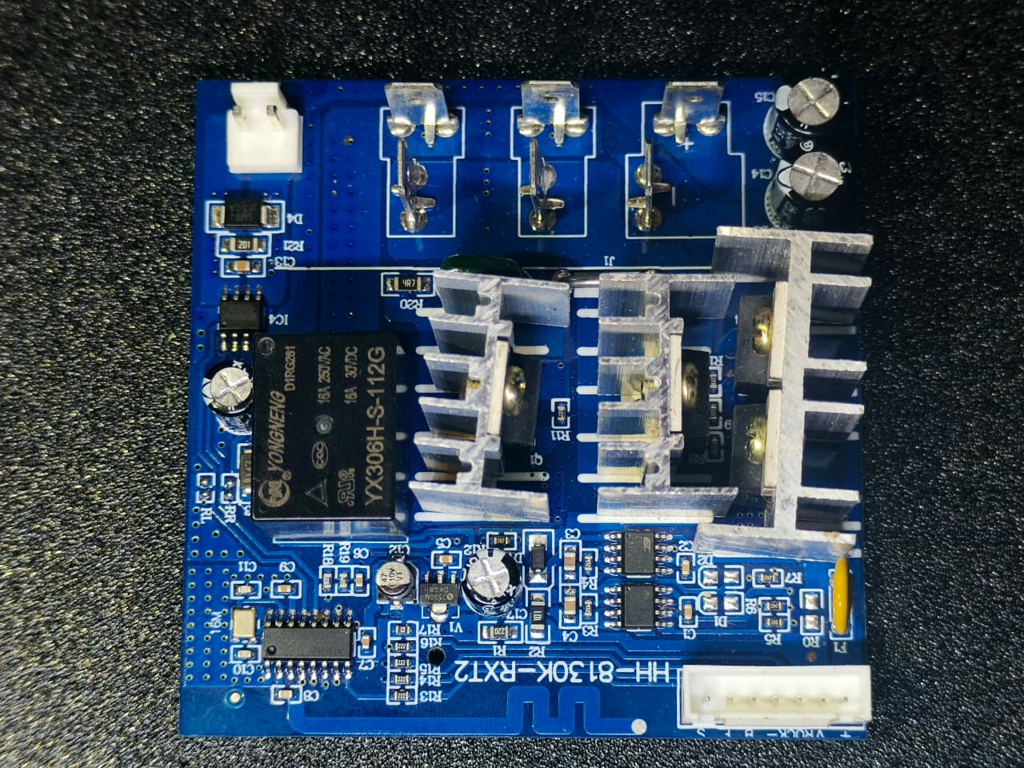
media/motor-controller/routing/routing-08.png
