arjun7n9s/AgriBot/media/motor-controller/routing/routing-10.png

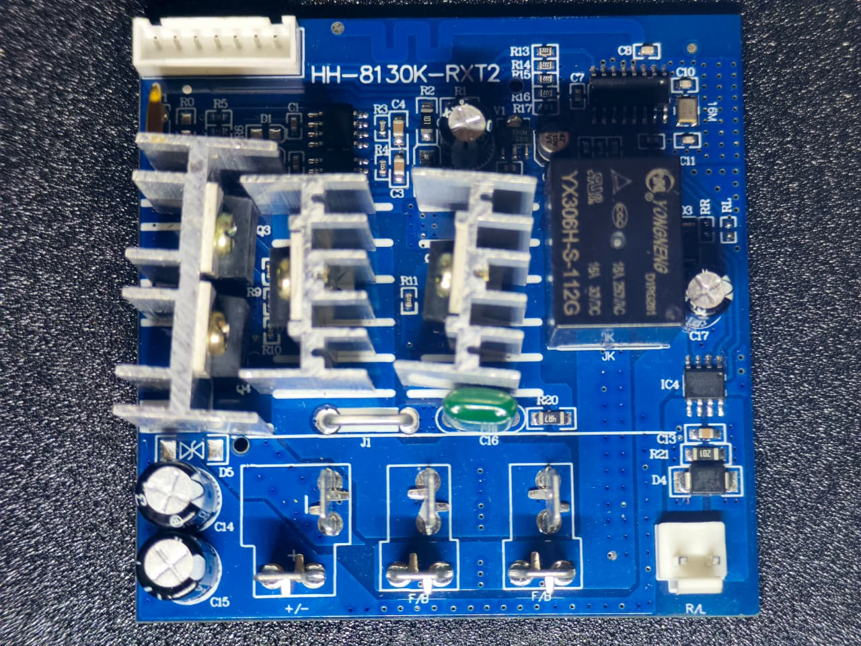
media/motor-controller/routing/routing-10.png
