arjun7n9s/AgriBot/media/motor-controller/routing/routing-11.png

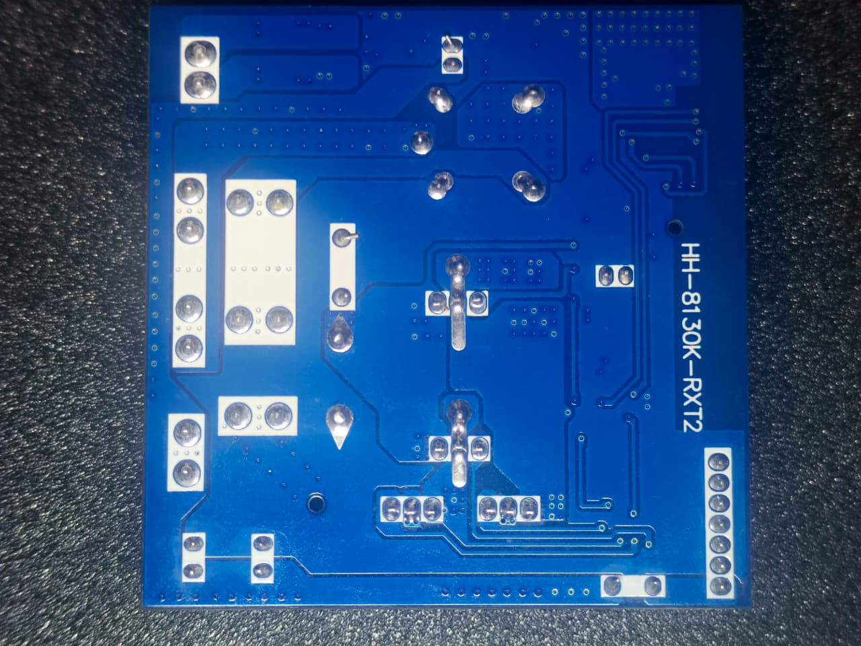
media/motor-controller/routing/routing-11.png
