arjun7n9s/AgriBot/media/motor-controller/routing/routing-12.png

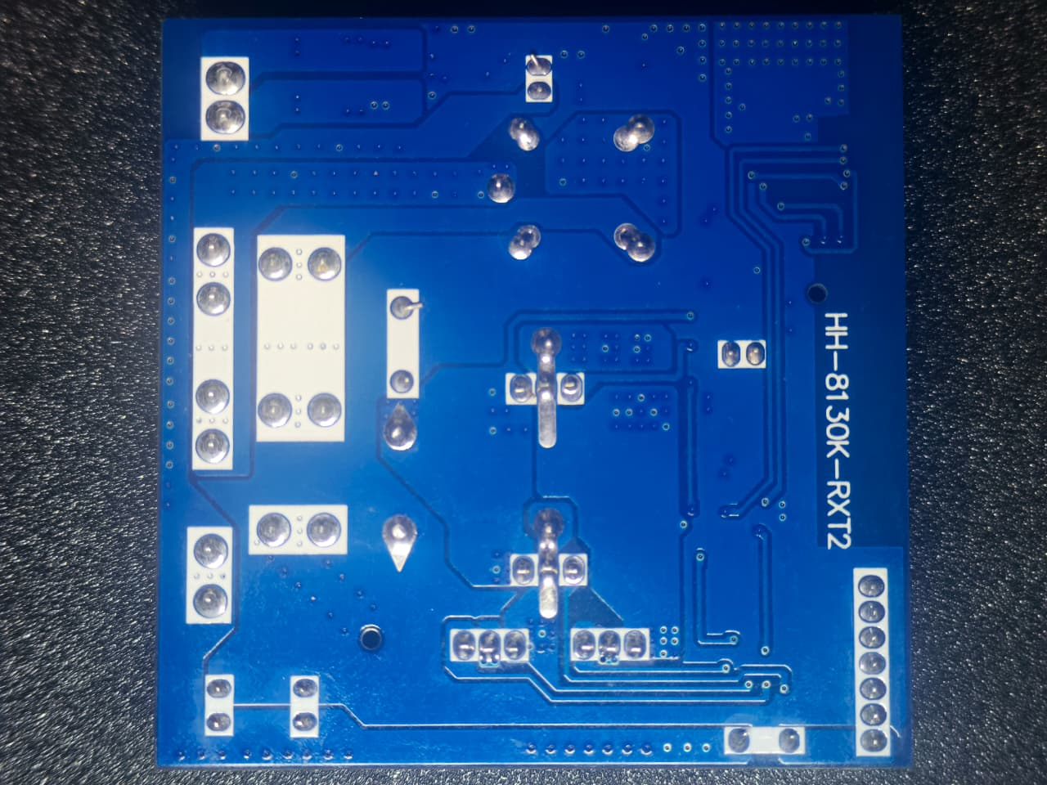
media/motor-controller/routing/routing-12.png
