arjun7n9s/AgriBot/media/rover-board-3d-preview.png

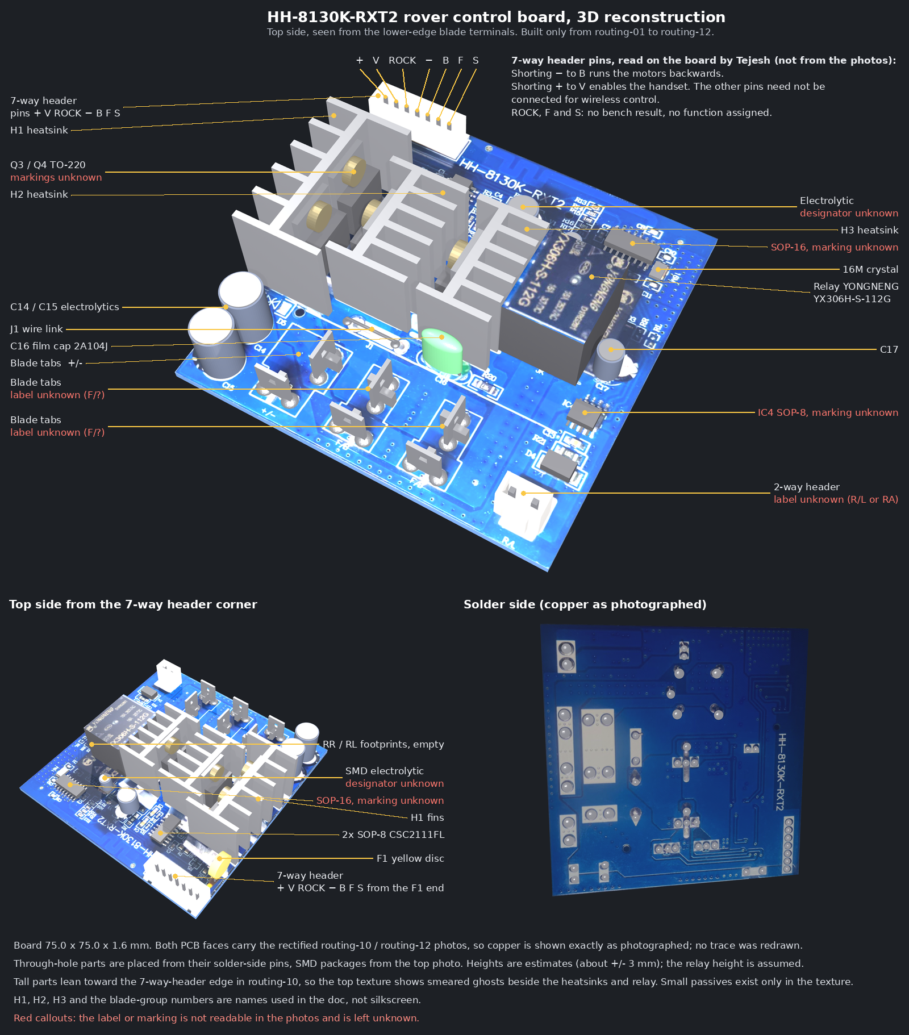
media/rover-board-3d-preview.png
