arjun7n9s/AgriBot/sim/agribot_field/models/raised_bed/meshes/soil.png

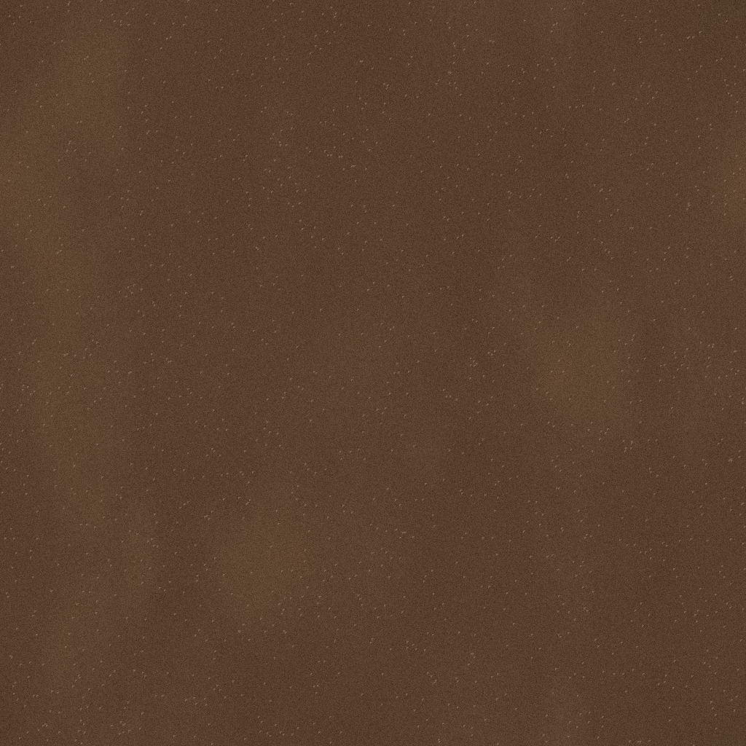
sim/agribot_field/models/raised_bed/meshes/soil.png
