arjun7n9s/AgriBot/sim/agribot_field/models/soil_tile/meshes/soil.png

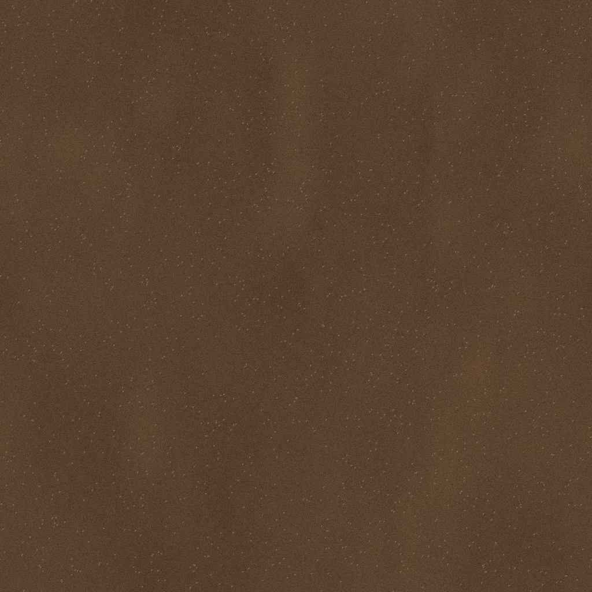
sim/agribot_field/models/soil_tile/meshes/soil.png
