arjun7n9s/AgriBot/sim/agribot_field/models/tomato_green/meshes/tomato_green.png

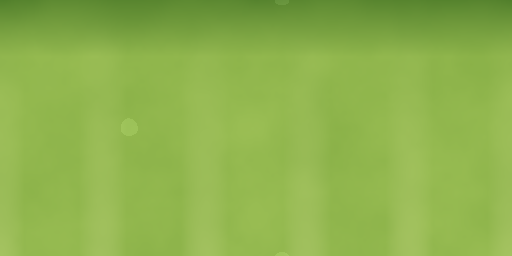
sim/agribot_field/models/tomato_green/meshes/tomato_green.png
