arjun7n9s/AgriBot/sim/agribot_field/models/tomato_half/meshes/tomato_half.png

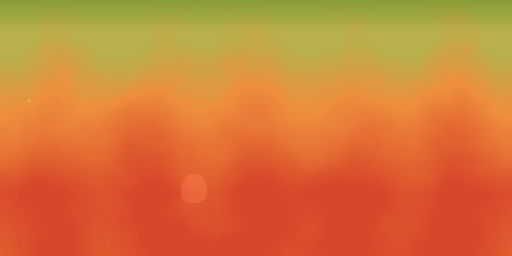
sim/agribot_field/models/tomato_half/meshes/tomato_half.png
