arjun7n9s/AgriBot/sim/agribot_field/models/tomato_plant_a/meshes/tomato_leaf_light.png

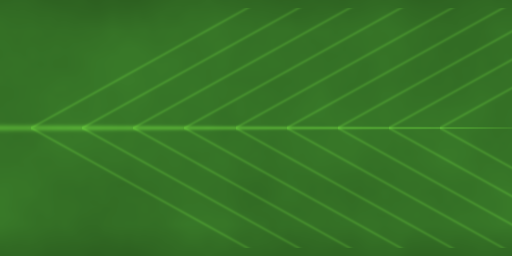
sim/agribot_field/models/tomato_plant_a/meshes/tomato_leaf_light.png
