arjun7n9s/AgriBot/sim/agribot_field/models/tomato_ripe/meshes/tomato_ripe.png

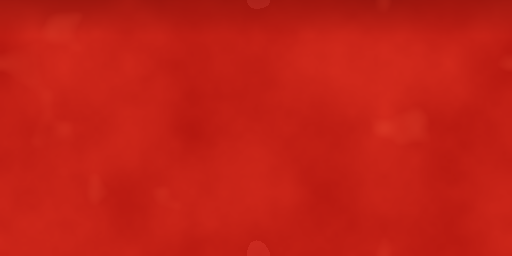
sim/agribot_field/models/tomato_ripe/meshes/tomato_ripe.png
