arjun7n9s/AgriBot/internal/scara-arm-file-inventory.md

---
cursor:
  subagentId: "bc-dfb435b3-d524-52d0-8cb7-bc1e0d8eefca"
---

# SCARA arm file inventory

Drive file `1Ix2lp_9UheI-O5mz6m4FaI6yEdq0rfvx`, title `scara-robot-arm20240812-1-wyhchy.zip`, 28,627,142 bytes. The first `uc?export=download` response was the Google virus-scan warning (HTML, 2,483 bytes), not the zip. The confirm link on that page (`drive.usercontent.google.com/download` with `confirm=t`) returned the zip. Unpacked size matches the Drive metadata.

Landed at `media/scara-arm/`. Outer zip kept as `media/scara-arm/scara-robot-arm20240812-1-wyhchy.zip`. Contents are a HowToMechatronics SCARA export. Three nested zips were unpacked beside themselves:

- `scara-robot-arm/solidworks/`
- `scara-robot-arm/stl/`
- `scara-robot-arm/laser/`

115 mesh/CAD files, plus one PDF and four zips. Sizes are unpacked file sizes.

## Unprinted parts

Both were identifiable from filenames.

- Second arm link that connects to the end effector: `Arm 2` (`Arm 2.SLDPRT` 301.4 KB, `Arm 2.STL` 307.7 KB). `Arm 2 Cover` is a separate cover. `Gripper link 2` is a small gripper linkage, not the arm.
- End effector: no file is named "end effector". The gripper filenames are the end effector. Printed meshes: Gripper Cover, Gripper End, Gripper Hand Left, Gripper Hand Right, Gripper link 1, Gripper link 2, Gripper Mechanism Slider, Gripper Servo Holder, Gripper to J3 connector, Gripper Wide end, Wide gripper end - Left side. SolidWorks also has `Gripper Mechanism.SLDASM`, `Gripper rail 6mm.SLDPRT`, `Wide gripper end.SLDPRT`, and `Servo Holder.SLDPRT`.

## Assembly and drawing

| File | Format | Size |
| --- | --- | --- |
| SCARA Robot 3D Model.STEP | STEP | 21.74 MB |
| solidworks/SCARA Robot.SLDASM | SLDASM | 6.34 MB |
| Base drawing - for base holes.pdf | PDF | 15.6 KB |

## SolidWorks parts

| File | Format | Size |
| --- | --- | --- |
| Arduino UNO case p1 | SLDPRT | 173.3 KB |
| Arduino UNO case p2 | SLDPRT | 142.4 KB |
| Arm 1 Cover | SLDPRT | 116.2 KB |
| Arm 1 | SLDPRT | 248.1 KB |
| Arm 2 Cover | SLDPRT | 185.1 KB |
| Arm 2 | SLDPRT | 301.4 KB |
| Ball Bearing 30x42x7mm | SLDPRT | 118.9 KB |
| Ball Bearing 35x47x7mm | SLDPRT | 115.2 KB |
| Ball Bearing 608 - 8x22x7mm | SLDPRT | 110.3 KB |
| Base cover | SLDPRT | 80.8 KB |
| Base | SLDPRT | 501.0 KB |
| Gripper Cover | SLDPRT | 109.8 KB |
| Gripper End | SLDPRT | 78.6 KB |
| Gripper Hand Left | SLDPRT | 69.4 KB |
| Gripper Hand Right | SLDPRT | 72.8 KB |
| Gripper link 1 | SLDPRT | 57.6 KB |
| Gripper link 2 | SLDPRT | 72.0 KB |
| Gripper Mechanism Slider | SLDPRT | 103.7 KB |
| Gripper rail 6mm | SLDPRT | 34.0 KB |
| Gripper to J3 connector | SLDPRT | 118.2 KB |
| GT2 Belt 200mm | SLDPRT | 63.6 KB |
| GT2 Belt 300mm 2 | SLDPRT | 61.1 KB |
| GT2 Belt 300mm | SLDPRT | 60.0 KB |
| GT2 Belt 400mm 2 | SLDPRT | 60.7 KB |
| GT2 Belt 400mm | SLDPRT | 57.3 KB |
| GT2 Pulley - 110 teeth - J1 | SLDPRT | 1.23 MB |
| GT2 Pulley - 22 - 80 teeth | SLDPRT | 1.14 MB |
| GT2 Pulley - 23 - 80 teeth | SLDPRT | 1.15 MB |
| GT2 Pulley - 90 teeth - J3 | SLDPRT | 1.04 MB |
| GT2 Pulley - 92 teeth - J2 | SLDPRT | 1.03 MB |
| GT2 Pulley - Parametric | SLDPRT | 305.3 KB |
| J1 coupler | SLDPRT | 192.4 KB |
| J2 Coupler | SLDPRT | 186.0 KB |
| J3 Coupler | SLDPRT | 168.0 KB |
| Lead Screw D8mm L380mm | SLDPRT | 41.3 KB |
| Lead Screw Nut 8mm | SLDPRT | 85.1 KB |
| Linear Bearing 10x19x29mm | SLDPRT | 144.3 KB |
| M4 50mm - Bolts | SLDPRT | 79.6 KB |
| M4 50mm - Bolts | STEP | 47.3 KB |
| M4 60mm - Bolts | SLDPRT | 75.8 KB |
| M4 60mm - Bolts | STEP | 47.3 KB |
| M4 Lock nut | SLDPRT | 147.2 KB |
| M4 Lock nut | STEP | 46.3 KB |
| M8 45mm - Bolts | SLDPRT | 67.9 KB |
| M8 45mm - Bolts | STEP | 25.9 KB |
| M8 Lock nut | SLDPRT | 146.2 KB |
| M8 Lock nut | STEP | 46.3 KB |
| M8 Washer | SLDPRT | 60.3 KB |
| Micro switch | SLDPRT | 114.8 KB |
| Micro switch | STEP | 78.3 KB |
| NEMA 17 Stepper L24mm - 20mm shaft | SLDPRT | 208.1 KB |
| NEMA 17 Stepper L24mm - 20mm shaft | STEP | 206.6 KB |
| Servo Holder | SLDPRT | 151.7 KB |
| Servo MG996R Horn | SLDPRT | 59.8 KB |
| Servo MG996R Horn | STEP | 20.3 KB |
| Servo Motor MG996R 3D Model | SLDPRT | 205.4 KB |
| Servo Motor MG996R 3D Model | STEP | 175.7 KB |
| Smooth Rod Clamp | SLDPRT | 93.6 KB |
| Smooth Rod D10mm L400mm | SLDPRT | 34.6 KB |
| Stepper NEMA 17 - 20mm shaft | SLDPRT | 233.7 KB |
| Stepper NEMA 17 - 20mm shaft | STEP | 266.0 KB |
| Thrust Bearing - 40x60x13 | SLDPRT | 1.25 MB |
| Thrust Bearing 35x52x12mm | SLDPRT | 1.08 MB |
| Top cover | SLDPRT | 148.8 KB |
| Wide gripper end - Left side | SLDPRT | 88.3 KB |
| Wide gripper end | SLDPRT | 97.4 KB |
| Z-axis Bottom Plate | SLDPRT | 116.1 KB |
| Z-axis Mount Platform | SLDPRT | 247.7 KB |
| Z-axis Top Plate | SLDPRT | 161.2 KB |
| Gripper Mechanism | SLDASM | 298.9 KB |

## STL meshes

| File | Format | Size |
| --- | --- | --- |
| Arduino Mega case p2 | STL | 111.6 KB |
| Arduino Mega case | STL | 121.2 KB |
| Arduino UNO case p1 | STL | 117.1 KB |
| Arduino UNO case p2 | STL | 85.6 KB |
| Arm 1 Cover | STL | 18.6 KB |
| Arm 1 | STL | 185.3 KB |
| Arm 2 Cover | STL | 290.5 KB |
| Arm 2 | STL | 307.7 KB |
| Base cover | STL | 61.4 KB |
| Base | STL | 512.3 KB |
| Endstop trigger for scara laser | STL | 6.1 KB |
| Gripper Cover | STL | 53.5 KB |
| Gripper End | STL | 31.1 KB |
| Gripper Hand Left | STL | 31.3 KB |
| Gripper Hand Right | STL | 31.3 KB |
| Gripper link 1 | STL | 22.9 KB |
| Gripper link 2 | STL | 23.6 KB |
| Gripper Mechanism Slider | STL | 40.5 KB |
| Gripper Servo Holder | STL | 93.1 KB |
| Gripper to J3 connector | STL | 87.8 KB |
| Gripper Wide end | STL | 34.6 KB |
| GT2 Pulley - 110 teeth - J1 | STL | 896.0 KB |
| GT2 Pulley - 22 - 80 teeth | STL | 840.8 KB |
| GT2 Pulley - 23 - 80 teeth | STL | 848.2 KB |
| GT2 Pulley - 90 teeth - J3 | STL | 787.3 KB |
| GT2 Pulley - 92 teeth - J2 | STL | 801.9 KB |
| GT2 Pulley - Parametric | STL | 193.6 KB |
| J1 coupler | STL | 252.7 KB |
| J2 Coupler | STL | 175.9 KB |
| J3 Coupler | STL | 207.0 KB |
| Laser module holder | STL | 124.7 KB |
| Smooth Rod Clamp | STL | 55.1 KB |
| Top cover | STL | 126.7 KB |
| Wide gripper end - Left side | STL | 34.9 KB |
| Wires holder | STL | 48.5 KB |
| Z-axis Bottom Plate | STL | 170.4 KB |
| Z-axis Mount Platform | STL | 254.3 KB |
| Z-axis Top Plate | STL | 225.1 KB |

## Laser add-on

| File | Format | Size |
| --- | --- | --- |
| Laser Module 5.5W | SLDPRT | 586.2 KB |
| Laser Module 5.5W | STEP | 764.7 KB |
| Laser module holder | SLDPRT | 164.3 KB |
| Laser module holder | STEP | 86.8 KB |
| Laser module holder | STL | 124.7 KB |

## Archives left in place

| File | Size |
| --- | --- |
| scara-robot-arm20240812-1-wyhchy.zip | 27.30 MB |
| SCARA Robot 3D Model - Solidworks Files.zip | 20.53 MB |
| SCARA Robot Arm - STL Files - updated.zip | 1.76 MB |
| Laser Engraving Mode - STL and editable files.zip | 902.8 KB |
