arjun7n9s/AgriBot/docs/bill-of-materials-priced.md

# Bill of materials — approximate cost

## 1. Mobile base

| S. No. | Component | Specification | Qty | Approx. unit (₹) | Approx. amount (₹) |
| --- | --- | --- | --- | --- | --- |
| 1.1 | Chassis frame | Metal rod frame, about 1.2 m long | 1 | 5,000 | 5,000 |
| 1.2 | Body and seat | Moulded plastic body, covers, and seat | 1 | 6,000 | 6,000 |
| 1.3 | Wheel and tyre | Tyre diameter 0.38 m, width 0.15 m | 4 | 800 | 3,200 |
| 1.4 | Steering linkage | Linkage from the steering motor to the front wheels | 1 | 1,000 | 1,000 |
| 1.5 | Arm mounting plate | Metal plate from the arm base to the rod frame | 1 | 1,500 | 1,500 |
| 1.6 | Chassis reinforcement | Reinforcement of the rod frame at the arm mount | 1 | 2,000 | 2,000 |
|  | Section total |  |  |  | 18,700 |

## 2. Arm structure

| S. No. | Component | Specification | Qty | Approx. unit (₹) | Approx. amount (₹) |
| --- | --- | --- | --- | --- | --- |
| 2.1 | 3 kg PLA | Filament for printing the SCARA links and the gripper | 1 | 2,800 | 2,800 |
| 2.2 | Guide rod | Smooth rod, 10 mm × 400 mm | 4 | 300 | 1,200 |
| 2.3 | Lead screw | 8 mm × 400 mm | 1 | 500 | 500 |
| 2.4 | Bearing set | Linear, radial, and thrust bearings for the slide and the base | 1 | 2,500 | 2,500 |
| 2.5 | Transmission set | Timing belts, toothed pulleys, idlers, and a shaft coupling | 1 | 1,800 | 1,800 |
| 2.6 | Stem-cutting blade assembly | Blade assembly for cutting the fruit stem | 1 | 800 | 800 |
| 2.7 | Cutter actuator and linkage | Actuator and linkage for the blade | 1 | 1,500 | 1,500 |
| 2.8 | Soft fruit-catching cradle | Soft cradle under the fruit | 1 | 600 | 600 |
| 2.9 | TPU/silicone protective lining | Soft lining for fruit-contact surfaces | 1 | 1,000 | 1,000 |
| 2.10 | Cutter guard and mounting bracket | Guard and bracket for the cutter | 1 | 700 | 700 |
| 2.11 | Cutter home/position sensor | Sensor for cutter home and position | 1 | 200 | 200 |
|  | Section total |  |  |  | 13,600 |

## 3. Electronics

| S. No. | Component | Specification | Qty | Approx. unit (₹) | Approx. amount (₹) |
| --- | --- | --- | --- | --- | --- |
| 3.1 | Wheel motor | Geared DC motor, about 25,000 rpm, reduced for low speed and high torque | 4 | 1,000 | 4,000 |
| 3.2 | Steering motor | Same class, higher gear ratio | 1 | 2,500 | 2,500 |
| 3.3 | Wheel motor driver | High-current driver for four motors, with a built-in wireless receiver | 1 | 2,000 | 2,000 |
| 3.4 | RF transmitter | Handheld transmitter matched to the wheel-motor driver | 1 | 1,000 | 1,000 |
| 3.5 | Steering motor driver | High-current DC motor driver | 1 | 350 | 350 |
| 3.6 | Stepper motor | NEMA 17, 4.2 kg·cm | 2 | 1,000 | 2,000 |
| 3.7 | Stepper motor | NEMA 17, 7 kg·cm | 2 | 1,600 | 3,200 |
| 3.8 | Stepper driver | 3 A class | 4 | 350 | 1,400 |
| 3.9 | Stepper driver | 1 A class | 4 | 150 | 600 |
| 3.10 | Stepper driver | Higher-current microstepping driver | 1 | 2,200 | 2,200 |
| 3.11 | Gripper servo | Hobby servo | 2 | 400 | 800 |
| 3.12 | Battery | 12 V, 7.6 Ah | 1 | 1,400 | 1,400 |
| 3.13 | Battery | 24 V, 10 Ah | 1 | 6,000 | 6,000 |
| 3.14 | Charger | Matched to the 24 V battery | 1 | 1,200 | 1,200 |
| 3.15 | DC-DC converter — logic | 24 V to 5 V | 1 | 300 | 300 |
| 3.16 | DC-DC converter — compute | 24 V to the onboard-computer input | 1 | 800 | 800 |
| 3.17 | DC-DC converter — servos | 24 V to 5–6 V | 1 | 350 | 350 |
| 3.18 | Fuses and fuse holders | Fuses and holders on each battery feed | 1 | 400 | 400 |
| 3.19 | Limit switches | Roller lever | 4 | 100 | 400 |
| 3.20 | Emergency stop | Latching switch on both battery feeds | 1 | 350 | 350 |
| 3.21 | Control switches | Power disconnect and other panel switches | 1 | 400 | 400 |
| 3.22 | Battery monitoring | Voltage and current sensing; battery-management interface where supported | 1 | 1,500 | 1,500 |
| 3.23 | Cooling hardware | Heatsinks, fans and ventilation | 1 | 1,000 | 1,000 |
|  | Section total |  |  |  | 34,150 |

## 4. Control and wiring

| S. No. | Component | Specification | Qty | Approx. unit (₹) | Approx. amount (₹) |
| --- | --- | --- | --- | --- | --- |
| 4.1 | Low-level microcontrollers | ESP32-S3 or equivalent | 2 | 1,000 | 2,000 |
| 4.2 | Relay modules | 4-channel, opto-isolated | 1 | 200 | 200 |
| 4.3 | Wiring harness | Signal and power harness for the rover and the arm | 1 | 3,000 | 3,000 |
| 4.4 | Connectors and terminals | Matched to the harness | 1 | 1,000 | 1,000 |
| 4.5 | Cable sleeves and drag-chain wiring | Sleeves and drag chain along the moving arm | 1 | 1,500 | 1,500 |
|  | Section total |  |  |  | 7,700 |

## 5. Sensing and onboard compute

| S. No. | Component | Specification | Qty | Approx. unit (₹) | Approx. amount (₹) |
| --- | --- | --- | --- | --- | --- |
| 5.1 | Front navigation camera | USB RGB, global shutter, for outdoor crop-row detection | 1 | 6,500 | 6,500 |
| 5.2 | Rear camera | USB RGB, for reversing and rear obstacles | 1 | 2,500 | 2,500 |
| 5.3 | Primary arm camera | Short-range RGB-D, for detection, depth, and pick alignment | 1 | 35,000 | 35,000 |
| 5.4 | Rotating scouting camera | RGB camera for scanning neighbouring plants | 1 | 3,000 | 3,000 |
| 5.5 | Onboard computer | NVIDIA Jetson development kit | 1 | 45,000 | 45,000 |
| 5.6 | Storage | NVMe SSD, or other supported storage | 1 | 4,000 | 4,000 |
| 5.7 | Powered USB hub | Ports, bandwidth, and power for the cameras | 1 | 2,000 | 2,000 |
| 5.8 | Camera mounting brackets | Rigid adjustable mounts for the front, rear, and arm cameras | 1 | 1,500 | 1,500 |
| 5.9 | Pan mechanism | Geared motor, driver, platform, and position feedback | 1 | 3,500 | 3,500 |
| 5.10 | IMU | Accelerometer and gyroscope | 1 | 1,500 | 1,500 |
| 5.11 | Wheel encoders | Wheel or axle speed, matched to the drivetrain | 1 | 1,200 | 1,200 |
| 5.12 | Steering-angle sensor | Measures actual steering position | 1 | 600 | 600 |
| 5.13 | Lighting | Diffuse LED illumination for close-range inspection | 1 | 800 | 800 |
| 5.14 | Protective camera housings | Dust and splash protection, optics left clear | 1 | 2,500 | 2,500 |
|  | Section total |  |  |  | 1,09,600 |

## 6. Miscellaneous

| S. No. | Component | Specification | Qty | Approx. unit (₹) | Approx. amount (₹) |
| --- | --- | --- | --- | --- | --- |
| 6.1 | Mechanical fastener kit | Spare metric bolts, nuts, washers, locking nuts, and screws | 1 | 1,600 | 1,600 |
| 6.2 | Threadlocker | Medium-strength, for vibration-prone joints | 1 | 300 | 300 |
| 6.3 | Cable ties and mounting bases | UV-resistant ties and cable mounts | 1 | 250 | 250 |
| 6.4 | Heat-shrink tubing | Assorted diameters | 1 | 200 | 200 |
| 6.5 | Electrical insulation materials | Sleeves, tape, and terminal covers | 1 | 300 | 300 |
| 6.6 | Lubricants and grease | For bearings, lead screws, and moving joints | 1 | 250 | 250 |
| 6.7 | Cleaning supplies | Brushes, lint-free cloths, and lens cleaning | 1 | 400 | 400 |
| 6.8 | Weatherproofing materials | Gaskets, seals, and enclosure sealant | 1 | 800 | 800 |
| 6.9 | Fabrication consumables | Welding, cutting, and drilling consumables | 1 | 1,500 | 1,500 |
| 6.10 | Spare electrical components | Spare fuses, terminals, and connectors | 1 | 800 | 800 |
| 6.11 | Spare sensors and switches | Spare limit switch and other small sensors | 1 | 500 | 500 |
| 6.12 | Hand tools | Spanners, hex keys, screwdrivers, and pliers | 1 | 1,500 | 1,500 |
| 6.13 | Crimping and wiring tools | Crimpers, wire stripper, and ferrule tools | 1 | 1,800 | 1,800 |
|  | Section total |  |  |  | 10,200 |

## 7. Optional upgrades and future enhancements

Not included in the total above.

| S. No. | Component | Specification | Qty | Approx. unit (₹) | Approx. amount (₹) |
| --- | --- | --- | --- | --- | --- |
| 7.1 | RTK-GNSS receiver and antenna | Future. Centimetre-level positioning for repeatable row navigation | 1 | 25,000 | 25,000 |
| 7.2 | 2D LiDAR | Future. Priced as a 2D unit. A 3D unit costs more | 1 | 15,000 | 15,000 |
| 7.3 | Ultrasonic or ToF sensors | Optional. Close-range proximity sensing | 1 | 1,200 | 1,200 |
| 7.4 | Rear or side obstacle sensors | Optional. Extra cover while reversing | 1 | 2,000 | 2,000 |
| 7.5 | Environmental sensors | Optional. Temperature, humidity, and field conditions | 1 | 800 | 800 |
| 7.6 | Soil moisture sensor | Optional. Field-condition logging | 1 | 500 | 500 |
| 7.7 | Cellular connectivity module | Optional. Telemetry where Wi-Fi is unavailable | 1 | 3,500 | 3,500 |
| 7.8 | Telemetry dashboard | Future. Allowance for a monitoring setup, not a single boxed part | 1 | 8,000 | 8,000 |
| 7.9 | Additional work lighting | Optional. Shaded rows and low light | 1 | 1,500 | 1,500 |
|  | Section total |  |  |  | 57,500 |

Approximate total, sections 1–6: ₹1,93,950

Approximate total, section 7, not included above: ₹57,500

Figures are approximate Indian retail prices, rounded, for planning. They are not quotations.
