arjun7n9s/AgriBot/docs/hardware-order-list.docx

OnlyScrews
Title | Link | Price
4 × M4 × 55 mm socket head, grade 12.9, black oxide | https://onlyscrews.in/products/m4-x-55mm-hex-allen-socket-head-high-tensile12-9-black-oxide-screw-dia-4mm-length-55mm | ₹26.40
1 × M8 × 45 mm socket head, SS 304 | https://onlyscrews.in/products/m8-x-45mm-hex-allen-socket-head-ss-304-screw-dia-8mm-length-45mm | ₹21.00
50 × M3 × 20 mm Phillips pan head, SS 304 | https://onlyscrews.in/products/phillips-pan-head-m3-x-20mm-pack-of-20 | ₹130.00
20 × M4 × 40 mm Phillips pan head, SS 304 | https://onlyscrews.in/products/m4-x-40mm-phillips-pan-head-ss-304-screwdia-4mm-length-40mm | ₹100.00
20 × M4 × 30 mm Phillips pan head, SS 304 | https://onlyscrews.in/products/m4-x-30mm-phillips-pan-head-ss-304-screwdia-4mm-length-30mm | ₹84.00
10 × M5 × 35 mm Phillips pan head, SS 304 | https://onlyscrews.in/products/m5-x-35mm-phillips-pan-head-ss-304-screw-dia-5mm-length-35mm | ₹62.00
15 × M5 × 25 mm Phillips pan head, SS 304 | https://onlyscrews.in/products/m5-x-25mm-phillips-pan-head-ss-304-screw | ₹72.00
15 × M4 × 20 mm Phillips pan head, SS 304 | https://onlyscrews.in/products/phillips-pan-head-m4-x-20mm-pack-of-20 | ₹45.00
10 × M4 × 50 mm Phillips pan head, mild steel, zinc blue | https://onlyscrews.in/products/m4-x-50mm-phillips-pan-head-mild-steel-with-zinc-blue-plating-screw-dia-4mm-length-50mm | ₹34.00
5 × M5 × 20 mm Phillips countersunk, SS 304 | https://onlyscrews.in/products/phillips-csk-m5-x-20mm-pack-of-20 | ₹15.00
20 × White nylon cable tie, 3.6 mm × 200 mm | https://onlyscrews.in/products/3-6mm-x-2000mm-8-inch-white-color-multi-purpose-self-locking-nylon-industrial-grade-cable-zip-tie-copy | ₹20.00
1 × Two-in-one screwdriver, Phillips and flat, 6 mm × 250 mm | https://onlyscrews.in/products/two-in-one-plus-and-minus-screw-driver?variant=50937497878841 | ₹118.00
1 × Allen key, 3 mm | https://onlyscrews.in/products/allen-key?variant=50929769644345 | ₹7.20
1 × Allen key, 6 mm | https://onlyscrews.in/products/allen-key?variant=50929769742649 | ₹21.40
1 × Combination spanner, 7 mm | https://onlyscrews.in/products/combination-spanner-ring-open-end-chrome-finish?variant=50931655934265 | ₹38.00
1 × Combination spanner, 8 mm | https://onlyscrews.in/products/combination-spanner-ring-open-end-chrome-finish?variant=50931655967033 | ₹40.00
1 × Combination spanner, 13 mm | https://onlyscrews.in/products/combination-spanner-ring-open-end-chrome-finish?variant=50931656098105 | ₹57.00
1 × Double open-end spanner, 14 × 15 mm | https://onlyscrews.in/products/double-open-end-spanner-chrome-vanadium-steel?variant=50929953079609 | ₹52.00
120 × M3 hex nut, SS 304 | https://onlyscrews.in/products/m3-nut-ss-304 | ₹120.00
30 × M3 nyloc nut, SS 304 | https://onlyscrews.in/products/m3-nyloc-nuts-ss304 | ₹96.00
50 × M3 plain washer, SS 304 | https://onlyscrews.in/products/m3-washer-ss304 | ₹40.00
80 × M4 hex nut, SS 304 | https://onlyscrews.in/products/m4-nut-ss-304 | ₹96.00
20 × M4 nyloc nut, SS 304 | https://onlyscrews.in/products/m4-nyloc-nuts-ss304 | ₹68.00
34 × M4 plain washer, SS 304 | https://onlyscrews.in/products/m4-washer-ss304 | ₹34.00
40 × M5 hex nut, SS 304 | https://onlyscrews.in/products/m5-nut-ss-304 | ₹56.00
10 × M5 nyloc nut, SS 304 | https://onlyscrews.in/products/m5-nyloc-nuts-ss304 | ₹40.00
17 × M5 plain washer, SS 304 | https://onlyscrews.in/products/m5-washer-ss304 | ₹20.40
2 × M8 hex nut, SS 304 | https://onlyscrews.in/products/m8-hex-nut-ss304 | ₹7.20
4 × M8 nyloc nut, SS 304 | https://onlyscrews.in/products/m8-nyloc-nuts-ss304 | ₹31.20
2 × M8 plain washer, SS 304 | https://onlyscrews.in/products/m8-washer-ss304 | ₹3.60
Subtotal | | ₹1,555.40

Robocraze
Title | Link | Price
1 × GT2 closed-loop timing belt, 6 mm × 200 mm | https://robocraze.com/products/gt2-rubber-timing-belt-closed-loop-6mm-width-for-3d-printer-cnc-6mm-width-and-200mm-long | ₹67.00
2 × GT2 closed-loop timing belt, 6 mm × 300 mm, 150 teeth | https://robocraze.com/products/b300mxl-240mxl-timing-belt-300-teeth-6mm-width-for-3d-printer | ₹198.00
2 × GT2 closed-loop timing belt, 6 mm × 400 mm | https://robocraze.com/products/copy-of-gt2-rubber-timing-belt-closed-loop-6mm-width-for-3d-printer-cnc-6mm-width-and-280mm-long | ₹164.00
6 × GT2 timing pulley, 20 teeth, 6 mm belt, 5 mm bore | https://robocraze.com/products/gt2-6mm-belt-width-20-teeth-5mm-bore-timing-pulley | ₹270.00
6 × GT2 Perlin driven pulley, toothless, 6 mm belt, 5 mm bore | https://robocraze.com/products/gt2-perlin-driven-aluminium-pulley-5mm-bore | ₹534.00
1 × 4-channel 5V relay board | https://robocraze.com/products/4-channel-5v-relay-board | ₹168.00
Subtotal | | ₹1,401.00

Amazon.in
Title | Link | Price
1 × Electronic Spices roller-lever micro limit switch, 10 pieces | https://amzn.in/d/04SFn2z6 | ₹259.00
1 × 6807-ZZ deep-groove ball bearing, pack of 2 | https://amzn.in/d/053gf3Vj | ₹400.00
2 × 51108 thrust ball bearing, 1 piece | https://amzn.in/d/09yhthTl | ₹440.00
1 × 6806-ZZ deep-groove ball bearing, pack of 2 | https://amzn.in/d/08rLr2Yr | ₹300.00
1 × 51107 thrust ball bearing | https://amzn.in/d/0aSMPuZh | ₹197.00
1 × xcluma flexible shaft coupling, 5 mm to 8 mm | https://amzn.in/d/0etJcgod | ₹126.00
1 × ESP32-S3 DevKit, WROOM-1-N16R8, USB-C | https://amzn.in/d/0b9VRb7j | ₹999.00
Subtotal | | ₹2,721.00

Robu
Title | Link | Price
8 × 22 AWG silicone wire, red | https://robu.in/product/high-quality-ultra-flexible-22awg-silicone-wire-1000m-red/ | ₹144.00
8 × 22 AWG silicone wire, blue | https://robu.in/product/high-quality-ultra-flexible-22awg-silicone-wire-1000m-blue/ | ₹144.00
8 × 22 AWG silicone wire, green | https://robu.in/product/high-quality-ultra-flexible-22awg-silicone-wire-1000m-green/ | ₹144.00
8 × 22 AWG silicone wire, yellow | https://robu.in/product/high-quality-ultra-flexible-22awg-silicone-wire-1000m-yellow/ | ₹144.00
8 × 22 AWG silicone wire, white | https://robu.in/product/high-quality-ultra-flexible-22awg-silicone-wire-1000m-white/ | ₹144.00
3 × 18 AWG silicone wire, black | https://robu.in/product/high-quality-ultra-flexible-18awg-silicone-wire-black/ | ₹234.00
3 × 18 AWG silicone wire, red | https://robu.in/product/high-quality-ultra-flexible-18awg-silicone-wire-red/ | ₹234.00
2 × Heat shrink sleeve, 4 mm, black, WOER | https://robu.in/product/heat-shrink-sleeve-4mm-black-industrial-grade-woer-hst/ | ₹16.00
2 × Heat shrink sleeve, 3 mm, red, WOER | https://robu.in/product/heat-shrink-sleeve-3mm-red-industrial-grade-woer-hst/ | ₹16.00
2 × Heat shrink sleeve, 5 mm, red, WOER | https://robu.in/product/heat-shrink-sleeve-5mm-red-industrial-grade-woer-hst/ | ₹48.00
2 × Heat shrink sleeve, 8 mm, red, WOER | https://robu.in/product/heat-shrink-sleeve-8mm-red-industrial-grade-woer-hst/ | ₹60.00
2 × Female-to-female Dupont jumpers, 20 cm, 40 pcs | https://robu.in/product/20cm-dupont-wire-color-jumper-cable-2-54mm-1p-1p-female-female-40pcs/ | ₹76.00
1 × Male-to-male Dupont jumpers, 20 cm, 40 pcs | https://robu.in/product/male-to-male-jumper-wires-40pcs-20cm/ | ₹46.00
1 × Male-to-female Dupont jumpers, 20 cm, 40 pcs | https://robu.in/product/male-to-female-jumper-wires-40pcs-20cm/ | ₹41.00
Subtotal | | ₹1,491.00

Robokits
Title | Link | Price
4 × TB6560/TB6600 upgrade stepper driver, 3A, 9–36 V | https://robokits.co.in/motor-drives-drivers/stepper-motor-driver/tb6560-tb6600-upgrade-version-stepper-motor-driver-board-3a-9v-36v-dc | ₹1,396.00
1 × BTS7960 high-power motor driver module, 43A | https://robokits.co.in/motor-drives-drivers/dc-motor-driver/bts7960-high-power-driver-module-43a | ₹307.00
Subtotal | | ₹1,703.00

Grand total ₹8,871.40

Line price
