arjun7n9s/AgriBot/docs/robokits-purchase-list.docx

Item | Qty | Price
TB6560 TB6600 upgrade version stepper motor driver board 3A 9V-36V DC | 4 | ₹1,396.00
BTS7960 high power driver module 43A | 1 | ₹307.00
Total | | ₹1,703.00
Incl. GST | | ₹2,009.54
