arjun7n9s/AgriBot/cad/arm-v2/parts.csv

id | name | material | process | qty | mass_g_total_est | note
A1-01 | Arm 1 top plate | 6061 | laser/waterjet 4 mm, drill | 1 | 170
A1-02 | Arm 1 bottom plate | 6061 | laser/waterjet 4 mm, drill | 1 | 147
A1-03 | Arm 1 root flange (U-block) | 6061 | mill, tap 6 x M4 | 1 | 59
A1-04 | J2 hub | 6061 | turn, drill and tap 6 x M4 | 1 | 112
A1-05 | Idler cup (2 x 608) | 6061 | turn | 1 | 25
A1-06 | Arm 1 spacer tube 36 mm | 6061 | 8/4.4 tube cut to 36.0 (or print PETG) | 7 | 24
J2-01 | J2 spindle | 6061 | turn, drill and tap | 1 | 153
J2-02 | J2 pulley 92T | PETG | print, 100% infill near the spigot | 1 | 22
STK-1 | Stock 80T/23T compound pulley (reused) | PETG | stock part, already printed | 1 | 16
BUY-01 | 51107 thrust bearing x2 (J2) | bought | on hand | 2
BUY-02 | 6806-ZZ (J2) | bought | on hand | 1
BUY-03 | 608 x2 (idler axle) | bought | on hand | 2
BUY-04 | Toothless idler x2 (belt tensioners) | bought | on hand | 2
BELT-1 | GT2 400 belt (J2 stage 1) | belt | on hand | 1
BELT-2 | GT2 300 belt (J2 stage 2) | belt | on hand | 1
A2-01 | Arm 2 top plate | 6061 | laser/waterjet 4 mm, drill | 1 | 208
A2-02 | Arm 2 bottom plate | 6061 | laser/waterjet 3 mm, drill | 1 | 136
A2-03 | Arm 2 spacer tube 25 mm | 6061 | 8/4.4 tube cut to 25.0 (or print PETG) | 5 | 12
A2-04 | J3 hub | 6061 | turn, drill and tap 6 x M4 | 1 | 72
J3-01 | J3 spindle and tool flange | 6061 | turn, drill and tap | 1 | 96
J3-02 | J3 pulley 90T | PETG | print | 1 | 19
BUY-05 | 6806-ZZ + 6807-ZZ (J3) | bought | on hand | 1
BUY-06 | NEMA17 4.2 kg.cm (J3) | bought | on hand | 1
BUY-07 | GT2 20T pulley (J3 motor) | bought | on hand | 1
BELT-3 | GT2 400 belt (J3) | belt | on hand | 1
T-01 | Cutter deck | 6061 | laser/waterjet 3 mm, drill | 1 | 121
T-02 | V-plate (shear edge) | SS | laser 1.5 mm SS410 (or SS304), deburr slot edges square | 1 | 51
T-03 | Blade-lever | steel | laser 2 mm EN42/SS420, harden, grind 25 deg bevel | 1 | 13
T-04 | Link 40 mm | SS | laser 2 mm SS304 or 3 mm 6061 | 1 | 6
BUY-08 | Servo horn (stock single arm) | bought | comes with the servo | 1
BUY-09 | Cutter servo MG996R / DS3225MG | bought | MG996R on hand; DS3225MG recommended | 1
T-05 | Cutter servo bracket | PETG | print | 1 | 4
T-06 | Basket | PETG | print, 3 walls | 1 | 53
T-07 | Door | PETG | print | 1 | 19
T-08 | Door pad 10 mm | foam | cut from 10 mm EVA or PU foam | 1 | 4
T-09 | Door lip | TPU | print TPU 95A | 1 | 7
T-10 | Door servo bracket | PETG | print | 1 | 14
BUY-10 | Door servo MG996R | bought | on hand | 1
T-11 | Feeler fork | PETG | print | 1 | 3
T-12 | Fork hinge blocks | PETG | print | 2 | 0
BUY-11 | Roller micro switch (feeler) | bought | on hand | 1
T-13 | IR posts | PETG | print | 2 | 1
T-14 | Camera bracket | PETG | print | 1 | 4
BUY-12 | RGB-D camera (D405 class) | bought | bill item 5.3 | 1
BUY-13 | Fruit sensor TCRT5000 | bought | buy | 1
