arjun7n9s/AgriBot/media/scara-arm/scara-robot-arm/solidworks/SCARA Robot.SLDASM

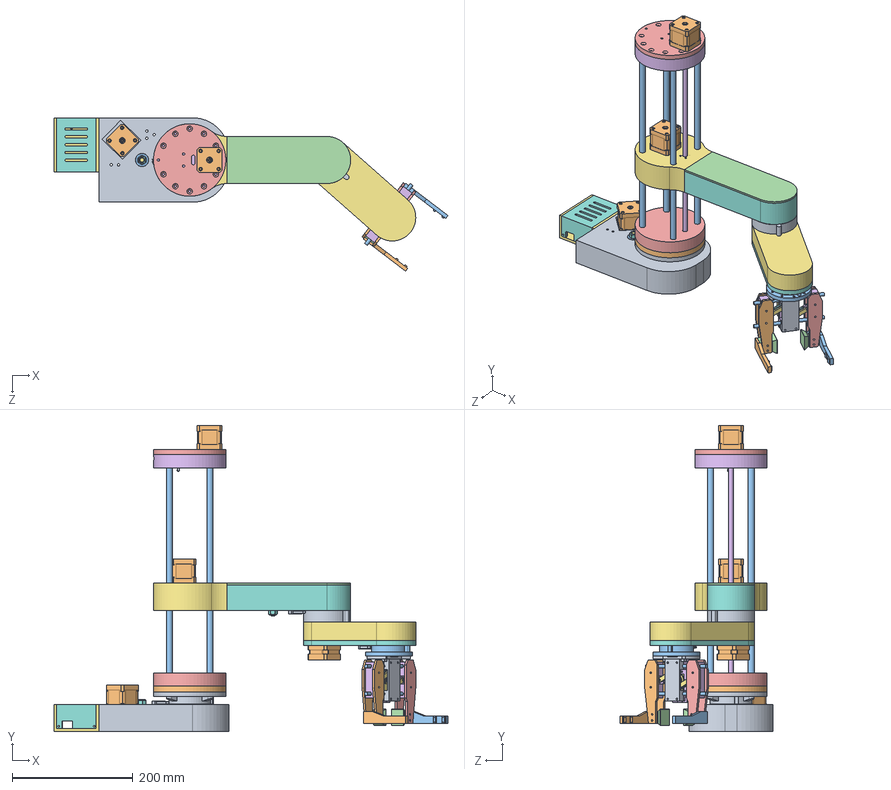
[picture p82: CAD file, 2026-10-31]
media/scara-arm/scara-robot-arm/solidworks/SCARA Robot.SLDASM
653.4 x 508.0 x 254.4 mm
Base
Stepper NEMA 17 - 20mm shaft x 3
Ball Bearing 608 - 8x22x7mm x 5
Thrust Bearing - 40x60x13 x 2
GT2 Pulley - 110 teeth - J1
GT2 Pulley - 22 - 80 teeth
GT2 Pulley - Parametric x 3
M8 Washer x 2
J1 coupler
Z-axis Bottom Plate
Smooth Rod D10mm L400mm x 4
Smooth Rod Clamp x 8
Z-axis Top Plate
Lead Screw D8mm L380mm
Z-axis Mount Platform
Arm 1
J2 Coupler
Thrust Bearing 35x52x12mm x 4
Ball Bearing 30x42x7mm x 2
GT2 Pulley - 92 teeth - J2
GT2 Pulley - 23 - 80 teeth
Linear Bearing 10x19x29mm x 4
Arm 2
Arm 2 Cover
Micro switch x 4
NEMA 17 Stepper L24mm - 20mm shaft
J3 Coupler
GT2 Pulley - 90 teeth - J3
Lead Screw Nut 8mm
Servo Holder
Servo Motor MG996R 3D Model
Servo MG996R Horn
Gripper Cover
Gripper Hand Left x 2
Gripper rail 6mm x 2
Gripper End x 2
Gripper Hand Right x 2
Gripper Mechanism Slider x 2
Gripper link 1 x 2
Gripper link 2 x 2
Gripper to J3 connector
Arm 1 Cover
Base cover
Top cover
Arduino UNO case p1
Arduino UNO case p2
GT2 Belt 200mm
GT2 Belt 300mm 2
GT2 Belt 400mm
GT2 Belt 300mm
GT2 Belt 400mm 2
Ball Bearing 35x47x7mm
M8 45mm - Bolts x 2
M8 Lock nut x 2
M4 Lock nut x 8
M4 60mm - Bolts x 4
M4 50mm - Bolts x 4
