arjun7n9s/AgriBot/media/scara-arm/scara-robot-arm/solidworks/Gripper Mechanism.SLDASM

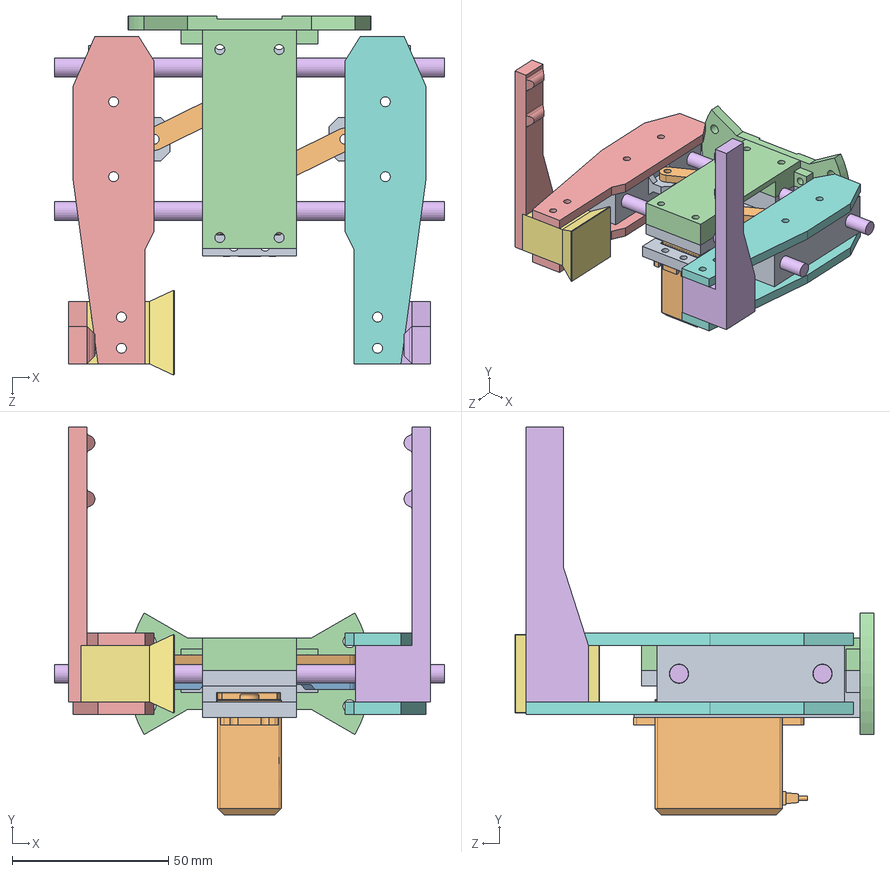
[picture p83: CAD file, 2026-10-31]
media/scara-arm/scara-robot-arm/solidworks/Gripper Mechanism.SLDASM
125.0 x 124.2 x 115.1 mm
Servo Holder
Servo Motor MG996R 3D Model
Servo MG996R Horn
Gripper Cover
Gripper Hand Left x 2
Gripper rail 6mm x 2
Gripper Hand Right x 2
Gripper Mechanism Slider x 2
Gripper link 1 x 2
Gripper link 2 x 2
Gripper to J3 connector
Wide gripper end
Wide gripper end - Left side
