arjun7n9s/AgriBot/cad/arm-v2/agribot_arm_v2.step

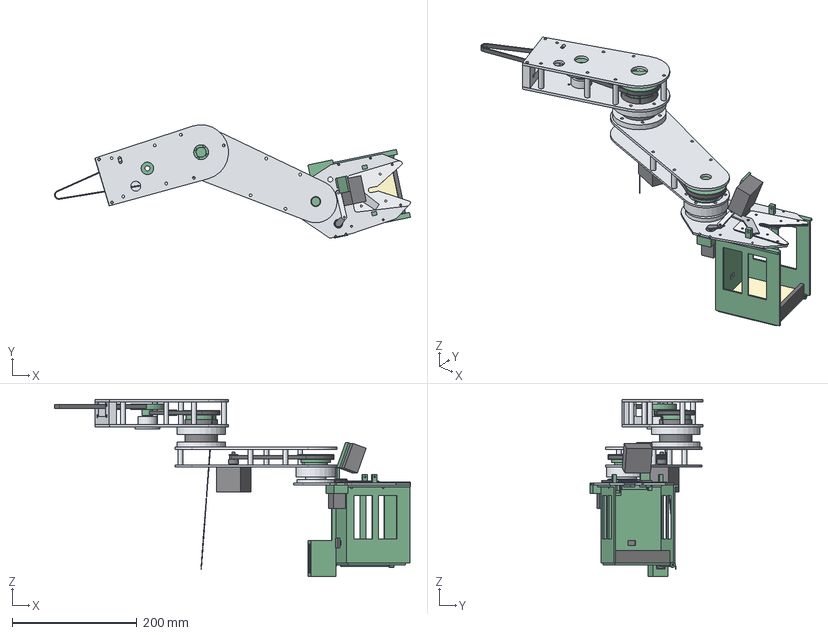
[picture p84: CAD file, 2026-11-03]
cad/arm-v2/agribot_arm_v2.step
570.5 x 181.6 x 283.9 mm
A1-01 Arm 1 top plate
A1-02 Arm 1 bottom plate
A1-03 Arm 1 root flange (U-block)
A1-04 J2 hub
A1-05 Idler cup (2 x 608)
A1-06 Arm 1 spacer tube 36 mm
J2-01 J2 spindle
J2-02 J2 pulley 92T
STK-1 Stock 80T/23T compound pulley (reused)
BUY-01 51107 thrust bearing x2 (J2)
BUY-02 6806-ZZ (J2)
BUY-03 608 x2 (idler axle)
BUY-04 Toothless idler x2 (belt tensioners)
BELT-1 GT2 400 belt (J2 stage 1)
BELT-2 GT2 300 belt (J2 stage 2)
A2-01 Arm 2 top plate
A2-02 Arm 2 bottom plate
A2-03 Arm 2 spacer tube 25 mm
A2-04 J3 hub
J3-01 J3 spindle and tool flange
J3-02 J3 pulley 90T
BUY-05 6806-ZZ + 6807-ZZ (J3)
BUY-06 NEMA17 4.2 kg.cm (J3)
BUY-07 GT2 20T pulley (J3 motor)
BELT-3 GT2 400 belt (J3)
T-01 Cutter deck
T-02 V-plate (shear edge)
T-03 Blade-lever
T-04 Link 40 mm
BUY-08 Servo horn (stock single arm)
BUY-09 Cutter servo MG996R / DS3225MG
T-05 Cutter servo bracket
T-06 Basket
T-07 Door
T-08 Door pad 10 mm
T-09 Door lip
T-10 Door servo bracket
BUY-10 Door servo MG996R
T-11 Feeler fork
T-12 Fork hinge blocks
BUY-11 Roller micro switch (feeler)
T-13 IR posts
T-14 Camera bracket
BUY-12 RGB-D camera (D405 class)
BUY-13 Fruit sensor TCRT5000
