arjun7n9s/AgriBot/cad/arm-v2/step/a1-03.step

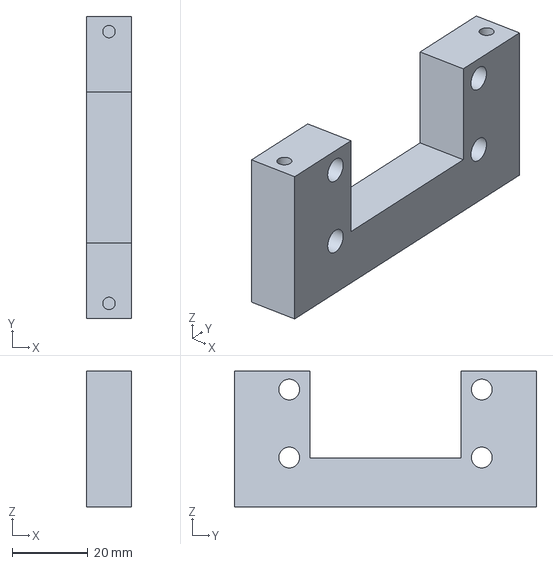
[picture p85: CAD file, 2026-11-03]
cad/arm-v2/step/a1-03.step
12.0 x 80.0 x 36.0 mm
