arjun7n9s/AgriBot/media/scara-arm/scara-robot-arm/laser/Laser Module 5.5W.step

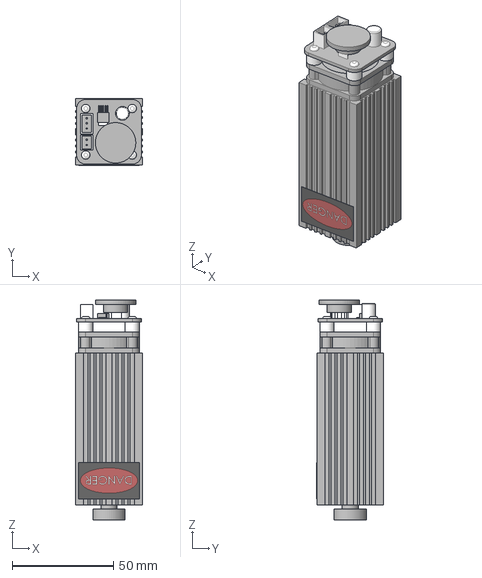
[picture p86: CAD file, 2026-10-31]
media/scara-arm/scara-robot-arm/laser/Laser Module 5.5W.step
33.0 x 33.2 x 108.8 mm
