arjun7n9s/AgriBot/media/scara-arm/scara-robot-arm/SCARA Robot 3D Model.STEP

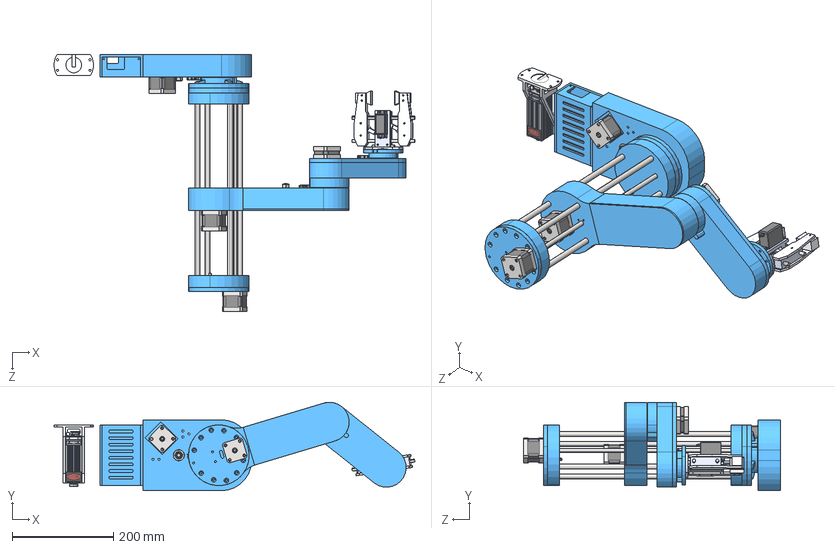
[picture p87: CAD file, 2026-10-31]
media/scara-arm/scara-robot-arm/SCARA Robot 3D Model.STEP
712.9 x 174.6 x 508.0 mm
Base_Base
Stepper NEMA 17 - 20mm shaft_Stepper NEMA 17 - 20mm shaft x 3
Ball Bearing 608 - 8x22x7mm_Ball Bearing 608 - 8x22x7mm x 5
Thrust Bearing - 40x60x13_Thrust Bearing - 40x60x13 x 2
GT2 Pulley - 110 teeth - J1_GT2 Pulley - Parametric
GT2 Pulley - 22 - 80 teeth_GT2 Pulley - Parametric
GT2 Pulley - Parametric_GT2 Pulley - Parametric x 3
M8 Washer_M8 Washer x 2
J1 coupler_J1 coupler
Z-axis Bottom Plate_Z-axis Bottom Plate
Smooth Rod D10mm L400mm_Smooth Rod D10mm L400mm x 4
Smooth Rod Clamp_Smooth Rod Clamp x 8
Z-axis Top Plate_Z-axis Top Plate
Lead Screw D8mm L380mm_Lead Screw D8mm L380mm
Z-axis Mount Platform_Z-axis Mount Platform
Arm 1_Arm 1
J2 Coupler_J2 Coupler
Thrust Bearing 35x52x12mm_Thrust Bearing 35x52x12mm x 4
Ball Bearing 30x42x7mm_Ball Bearing 30x42x7mm x 2
GT2 Pulley - 92 teeth - J2_GT2 Pulley - Parametric
GT2 Pulley - 23 - 80 teeth_GT2 Pulley - Parametric
Linear Bearing 10x19x29mm_Linear Bearing 10x19x29mm x 4
Arm 2_Arm 2
Arm 2 Cover_Arm 2 Cover
Micro switch_Micro switch x 4
NEMA 17 Stepper L24mm - 20mm shaft_NEMA 17 Stepper L24mm - 20mm shaft
J3 Coupler_J3 Coupler
GT2 Pulley - 90 teeth - J3_GT2 Pulley - Parametric
Lead Screw Nut 8mm_Lead Screw Nut 8mm
Servo Holder_Servo Holder
Servo Motor MG996R 3D Model_Servo Motor MG996R 3D Model
Servo MG996R Horn_Servo MG996R Horn
Gripper Cover_Gripper Cover
Gripper Hand Left_Gripper Hand Left x 2
Gripper rail 6mm_Gripper rail 6mm x 2
Gripper End_Gripper End x 2
Gripper Hand Right_Gripper Hand Left x 2
Gripper Mechanism Slider_Gripper Mechanism Slider x 2
Gripper link 1_Gripper link 1 x 2
Gripper link 2_Gripper link 2 x 2
Gripper to J3 connector_Gripper to J3 connector
Arm 1 Cover_Arm 1 Cover
Base cover_Base cover
Top cover_Top cover
Arduino Mega case_Arduino UNO case p1
Arduino Mega case p2_Arduino UNO case p2
GT2 Belt 200mm_GT2 Belt 400mm
GT2 Belt 300mm 2_GT2 Belt 400mm
GT2 Belt 400mm_GT2 Belt 400mm
GT2 Belt 300mm_GT2 Belt 400mm
GT2 Belt 400mm 2_GT2 Belt 400mm
Ball Bearing 35x47x7mm_Ball Bearing 30x42x7mm
M8 45mm - Bolts_M8 45mm - Bolts x 2
M8 Lock nut_M8 Lock nut x 2
M4 Lock nut_M4 Lock nut x 8
M4 60mm - Bolts_M4 60mm - Bolts x 4
M4 50mm - Bolts_M4 50mm - Bolts x 4
Laser module holder_Gripper to J3 connector
Laser Module 5.5W
