arjun7n9s/AgriBot/media/scara-arm/scara-robot-arm/solidworks/Top cover.SLDPRT

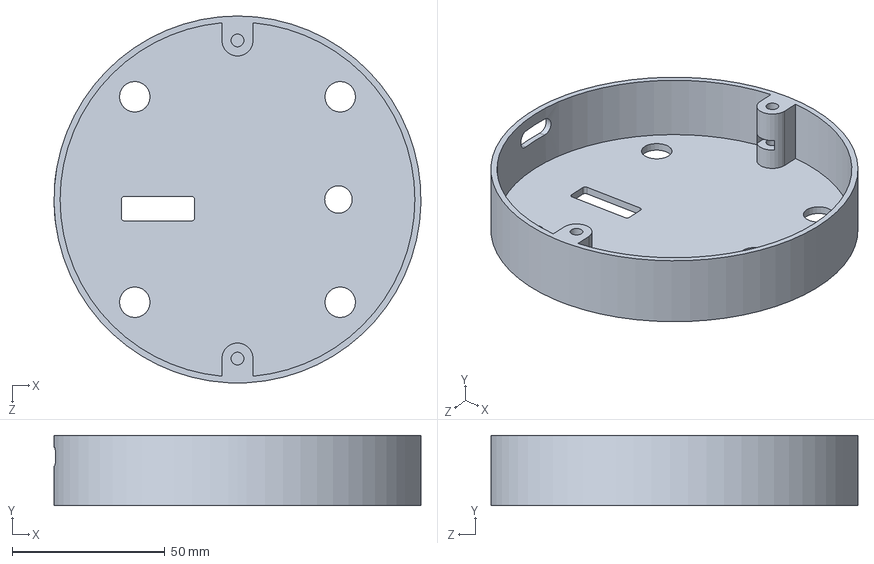
[picture p88: CAD file, 2026-10-31]
media/scara-arm/scara-robot-arm/solidworks/Top cover.SLDPRT
120.0 x 23.0 x 120.0 mm
