arjun7n9s/AgriBot/media/scara-arm/scara-robot-arm/stl/Gripper Servo Holder.STL

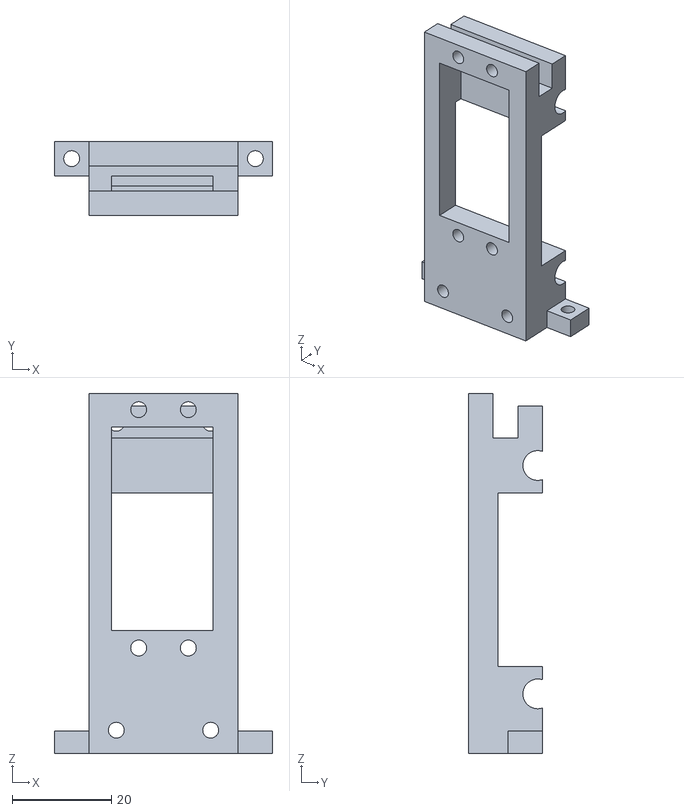
[picture p89: CAD file, 2026-10-31]
media/scara-arm/scara-robot-arm/stl/Gripper Servo Holder.STL
44.0 x 15.0 x 72.5
