arjun7n9s/AgriBot/sim/agribot_description/meshes/cutter/visual/cutter_body.obj

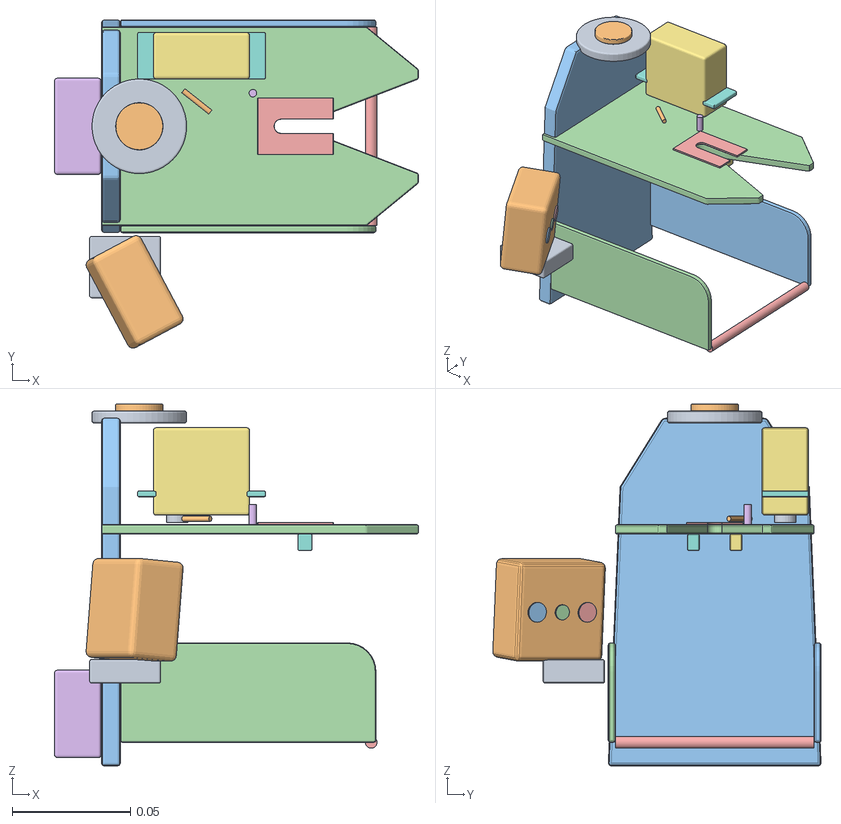
[picture p90: CAD file, 2026-10-31]
sim/agribot_description/meshes/cutter/visual/cutter_body.obj
0.154 x 0.139 x 0.153
flange
spigot
spine
top_plate
fixed_edge
pivot_pin
servo1
servo1_tabs
servo1_horn
link_rod
wall_right
wall_left
hinge_barrel
servo2
ir_tx
ir_rx
camera_bracket
arm_camera
lens_0
lens_1
lens_2
