arjun7n9s/AgriBot/sim/agribot_description/meshes/rover/visual/rover_body.obj

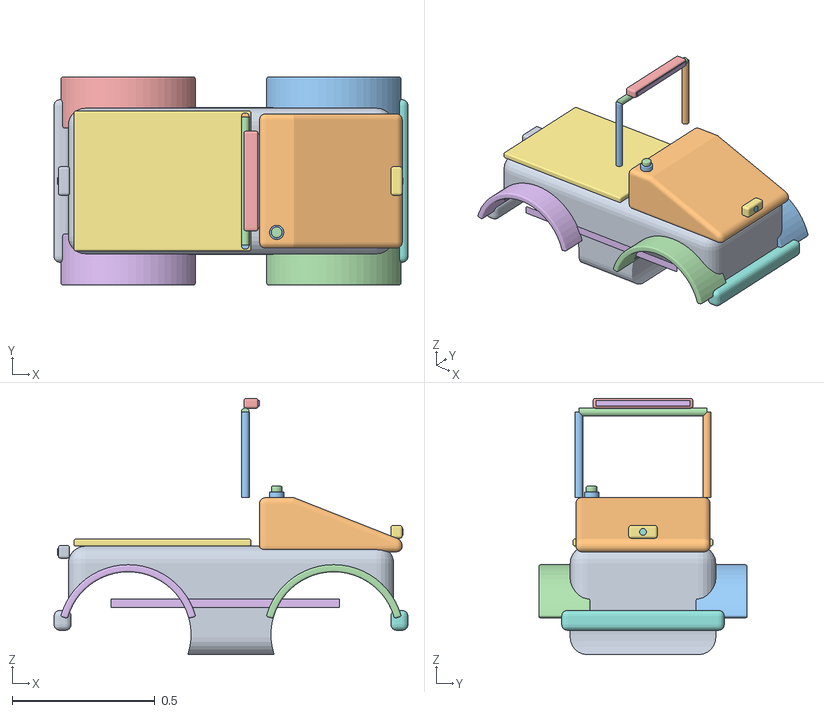
[picture p91: CAD file, 2026-10-31]
sim/agribot_description/meshes/rover/visual/rover_body.obj
1.24 x 0.73 x 0.897
tub
hood
fender
fender.001
fender.002
fender.003
deck
bumper_front
bumper_rear
hoop_post
hoop_post.001
hoop_bar
light_bar
light_lens
front_cam
front_cam_lens
rear_cam
rear_cam_lens
estop_base
estop_button
stripe
stripe.001
