arjun7n9s/AgriBot/sim/agribot_description/meshes/scara/collision/wrist_link.stl

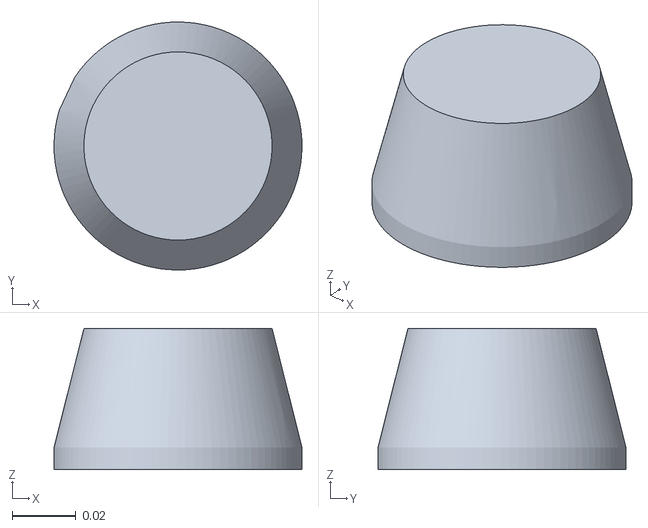
[picture p92: CAD file, 2026-10-31]
sim/agribot_description/meshes/scara/collision/wrist_link.stl
0.078 x 0.078 x 0.0444
