arjun7n9s/AgriBot/sim/agribot_description/meshes/scara/visual/wrist_link.obj

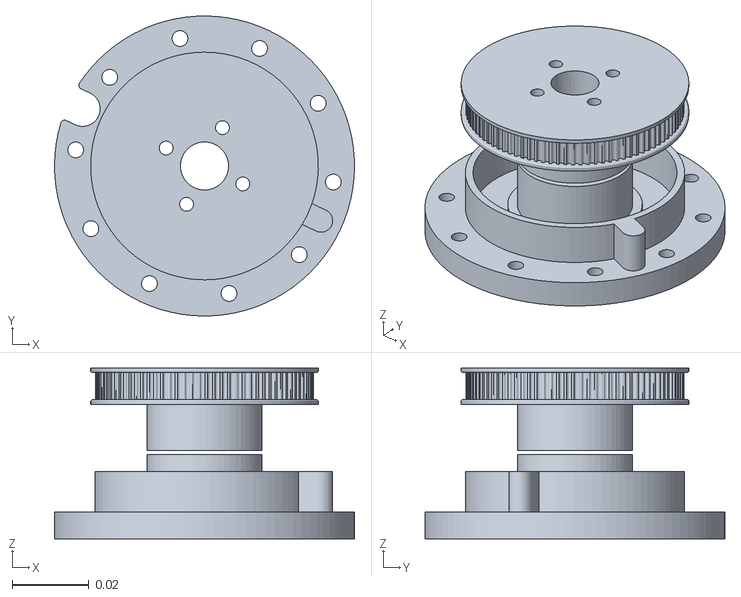
[picture p93: CAD file, 2026-10-31]
sim/agribot_description/meshes/scara/visual/wrist_link.obj
0.078 x 0.078 x 0.0444
