arjun7n9s/AgriBot/sim/agribot_field/models/raised_bed/meshes/raised_bed.obj

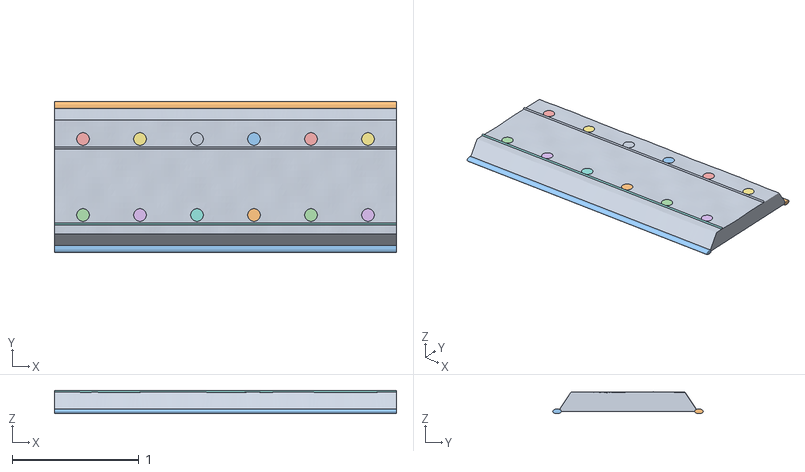
[picture p94: CAD file, 2026-10-31]
sim/agribot_field/models/raised_bed/meshes/raised_bed.obj
2.70 x 1.19 x 0.184
raised_bed
berm
berm.001
planting_hole
planting_hole.001
planting_hole.002
planting_hole.003
planting_hole.004
planting_hole.005
planting_hole.006
planting_hole.007
planting_hole.008
planting_hole.009
planting_hole.010
planting_hole.011
drip
drip.001
