arjun7n9s/AgriBot/sim/agribot_field/models/soil_tile/meshes/soil_tile.obj

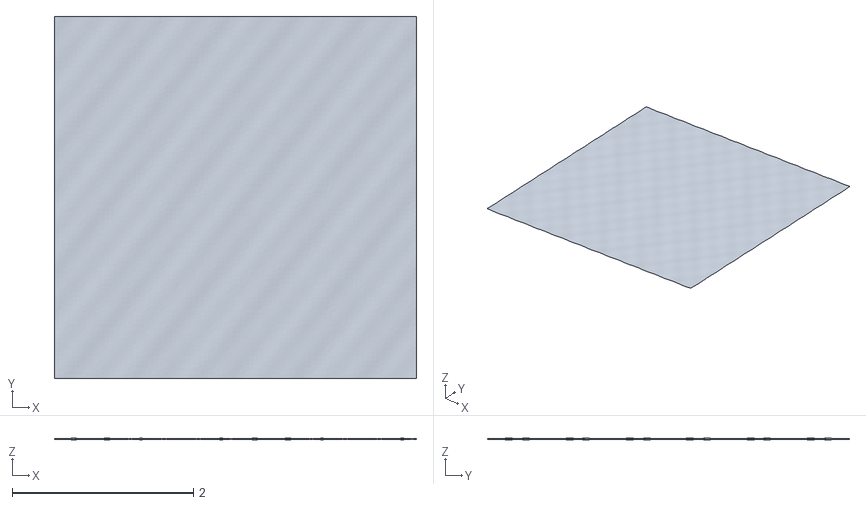
[picture p95: CAD file, 2026-10-31]
sim/agribot_field/models/soil_tile/meshes/soil_tile.obj
4.00 x 4.00 x 0.0183
