arjun7n9s/AgriBot/sim/agribot_field/models/tomato_green/meshes/tomato_green.obj

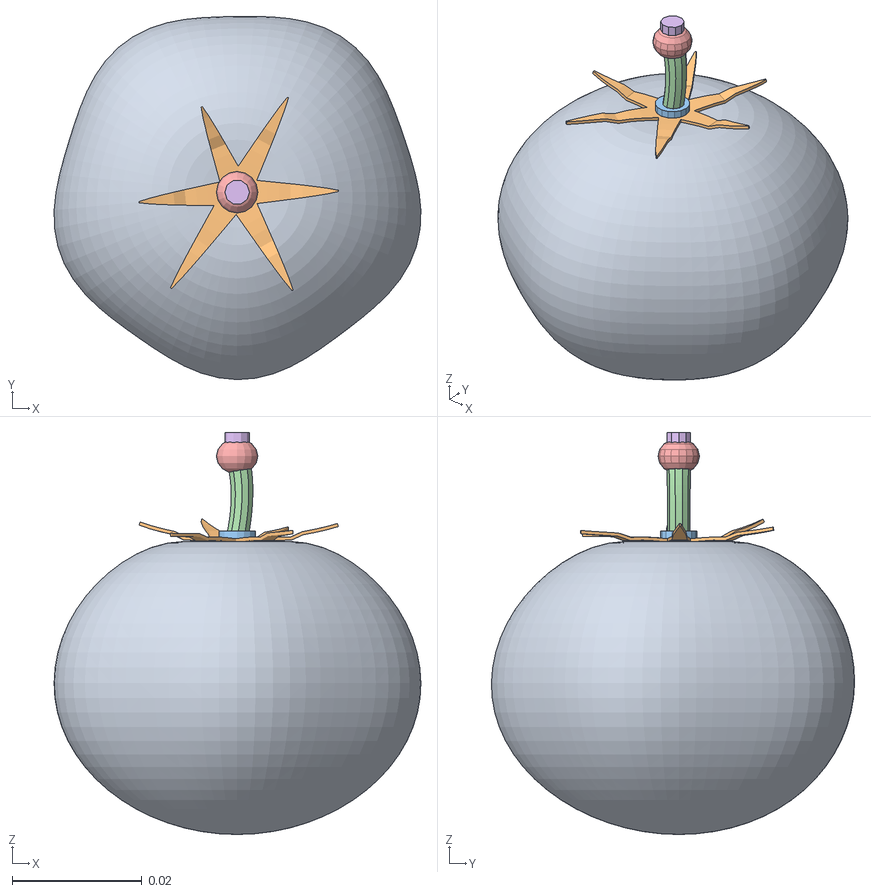
[picture p96: CAD file, 2026-10-31]
sim/agribot_field/models/tomato_green/meshes/tomato_green.obj
0.0566 x 0.056 x 0.062
tomato_green
calyx
calyx_hub
pedicel
knuckle
proximal_stub
