arjun7n9s/AgriBot/sim/agribot_field/models/tomato_half/meshes/tomato_half.obj

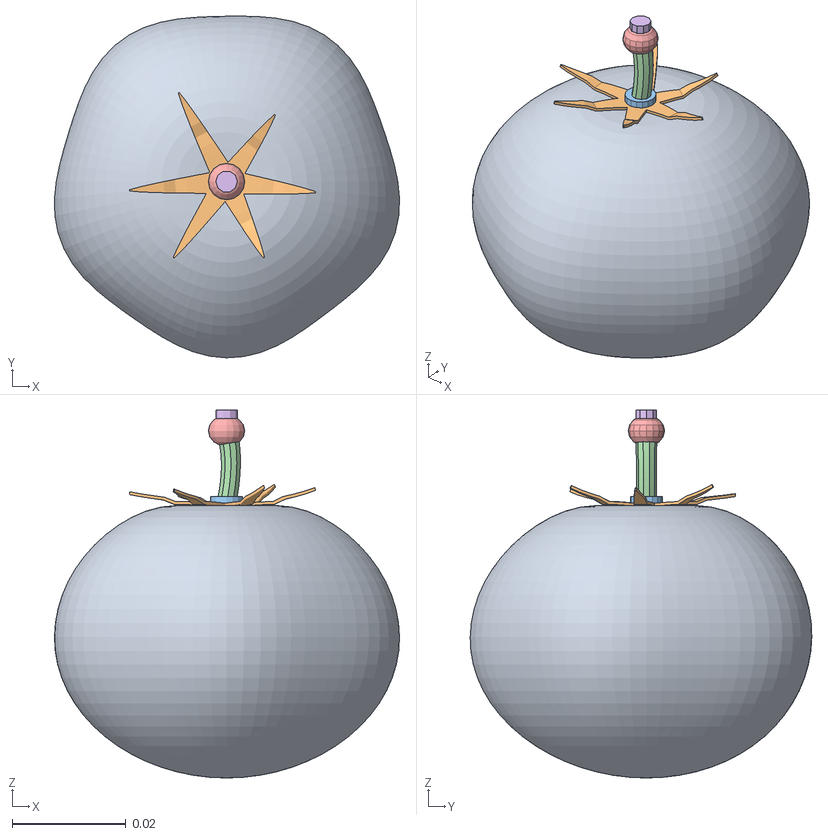
[picture p97: CAD file, 2026-10-31]
sim/agribot_field/models/tomato_half/meshes/tomato_half.obj
0.0606 x 0.06 x 0.0646
tomato_half
calyx
calyx_hub
pedicel
knuckle
proximal_stub
