arjun7n9s/AgriBot/sim/agribot_field/models/tomato_plant_c/meshes/tomato_plant_c.obj

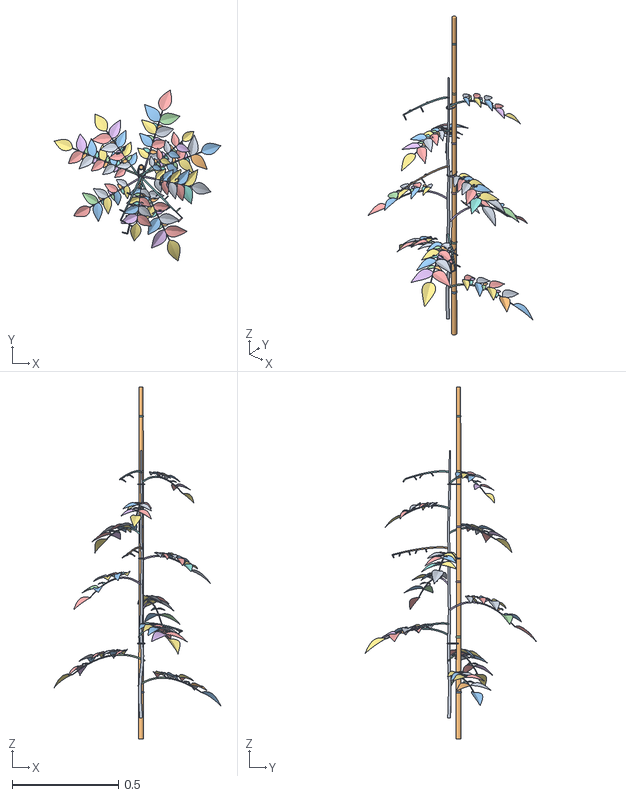
[picture p100: CAD file, 2026-10-31]
sim/agribot_field/models/tomato_plant_c/meshes/tomato_plant_c.obj
0.785 x 0.806 x 1.66
stem
stake
stake_node
stake_node.001
stake_node.002
stake_node.003
stake_node.004
stake_node.005
petiole
leaflet
leaflet_small
leaflet.001
leaflet_small.001
leaflet.002
leaflet_small.002
leaflet.003
leaflet_small.003
leaflet.004
leaflet_small.004
leaflet.005
leaflet_small.005
leaflet.006
leaflet.007
leaflet.008
petiole.001
leaflet.009
leaflet_small.006
leaflet.010
leaflet_small.007
leaflet.011
leaflet_small.008
leaflet.012
leaflet_small.009
leaflet.013
leaflet_small.010
leaflet.014
leaflet_small.011
leaflet.015
leaflet_small.012
leaflet.016
leaflet_small.013
leaflet.017
leaflet.018
leaflet.019
petiole.002
leaflet.020
leaflet_small.014
leaflet.021
leaflet_small.015
leaflet.022
leaflet_small.016
leaflet.023
leaflet_small.017
leaflet.024
leaflet_small.018
leaflet.025
leaflet_small.019
leaflet.026
leaflet.027
leaflet.028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
