arjun7n9s/AgriBot/sim/agribot_field/models/tomato_ripe/meshes/tomato_ripe.obj

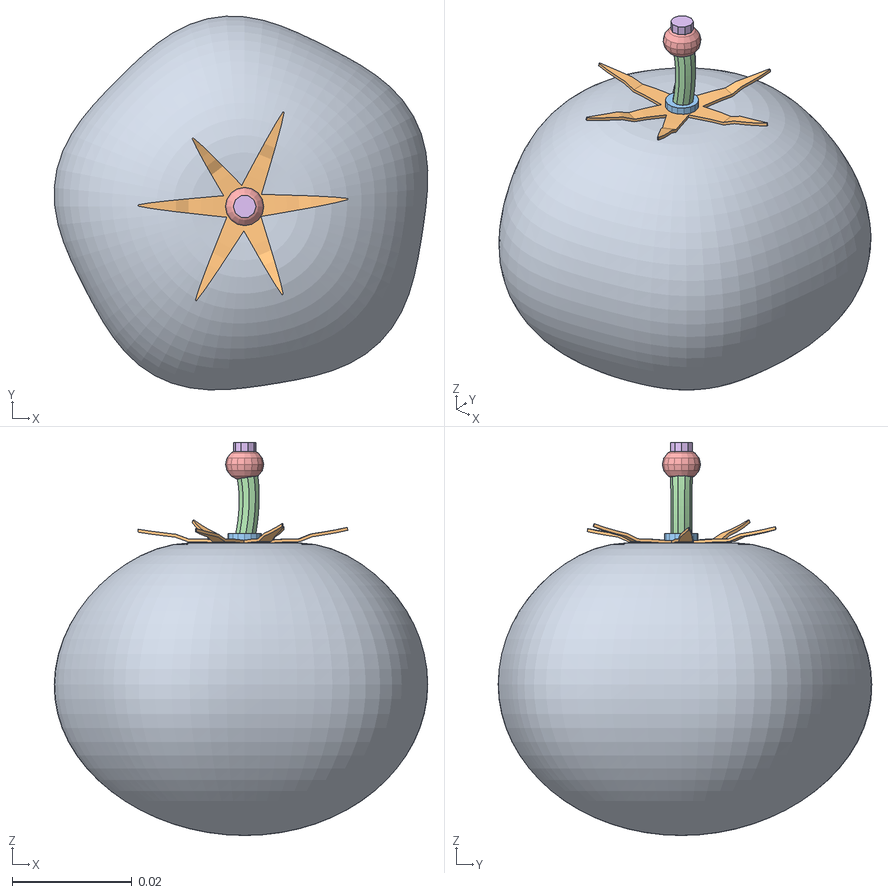
[picture p101: CAD file, 2026-10-31]
sim/agribot_field/models/tomato_ripe/meshes/tomato_ripe.obj
0.0624 x 0.0624 x 0.0656
tomato_ripe
calyx
calyx_hub
pedicel
knuckle
proximal_stub
