arjun7n9s/AgriBot/cad/arm-v2/end_effector.step

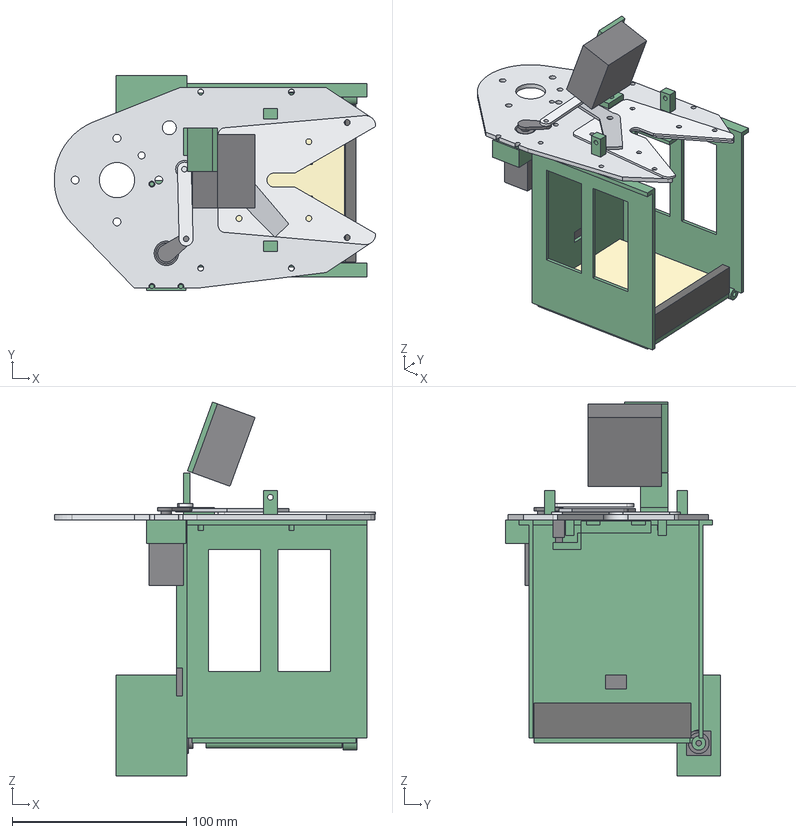
[picture p102: CAD file, 2026-11-03]
cad/arm-v2/end_effector.step
184.4 x 123.3 x 214.5 mm
T-01 Cutter deck
T-02 V-plate (shear edge)
T-03 Blade-lever
T-04 Link 40 mm
BUY-08 Servo horn (stock single arm)
BUY-09 Cutter servo MG996R / DS3225MG
T-05 Cutter servo bracket
T-06 Basket
T-07 Door
T-08 Door pad 10 mm
T-09 Door lip
T-10 Door servo bracket
BUY-10 Door servo MG996R
T-11 Feeler fork
T-12 Fork hinge blocks
BUY-11 Roller micro switch (feeler)
T-13 IR posts
T-14 Camera bracket
BUY-12 RGB-D camera (D405 class)
BUY-13 Fruit sensor TCRT5000
