arjun7n9s/AgriBot/cad/arm-v2/step/t-06.step

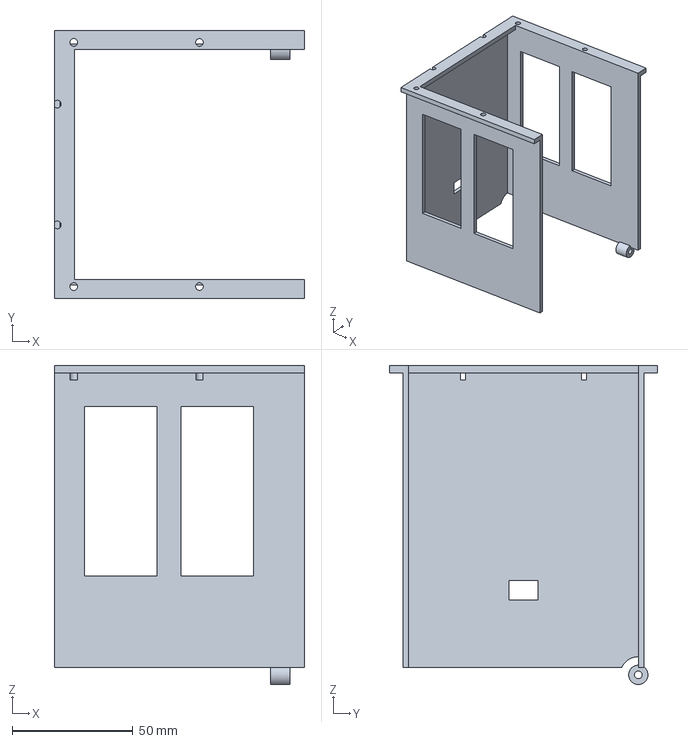
[picture p103: CAD file, 2026-11-03]
cad/arm-v2/step/t-06.step
103.5 x 111.0 x 132.0 mm
