arjun7n9s/AgriBot/media/scara-arm/scara-robot-arm/laser/Laser module holder.step

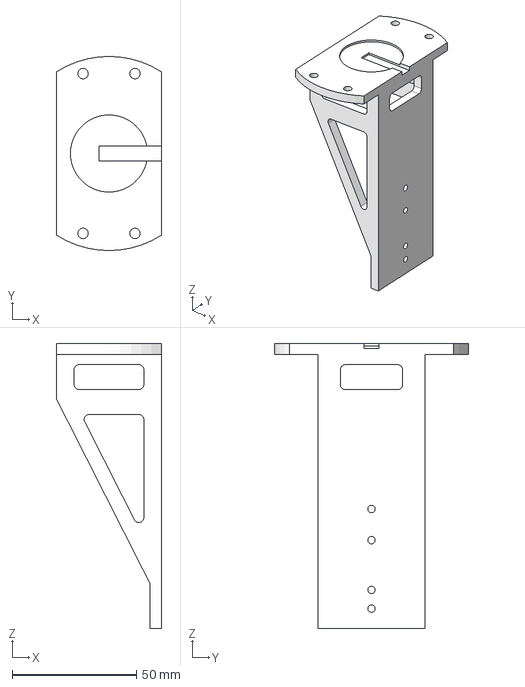
[picture p104: CAD file, 2026-10-31]
media/scara-arm/scara-robot-arm/laser/Laser module holder.step
42.0 x 78.0 x 114.5 mm
