arjun7n9s/AgriBot/media/scara-arm/scara-robot-arm/solidworks/Wide gripper end.SLDPRT

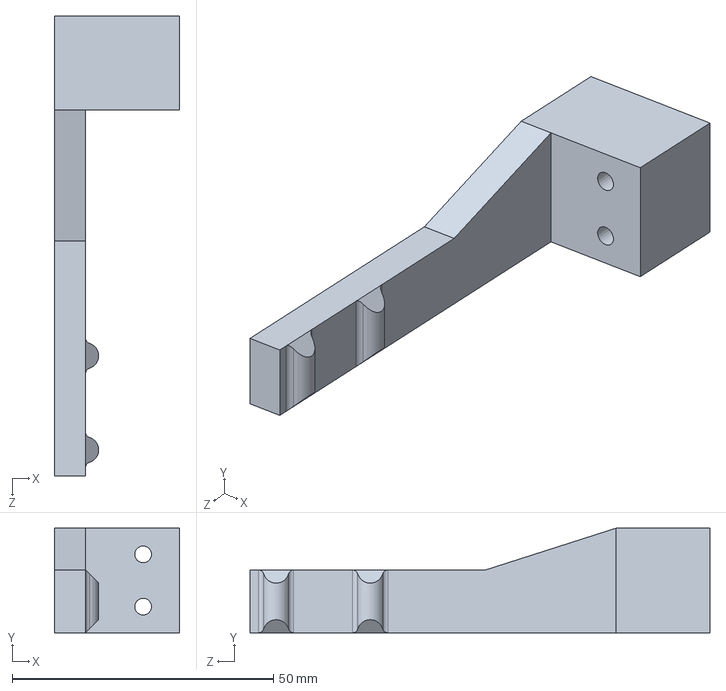
[picture p105: CAD file, 2026-10-31]
media/scara-arm/scara-robot-arm/solidworks/Wide gripper end.SLDPRT
24.0 x 20.0 x 88.0 mm
