arjun7n9s/AgriBot/media/scara-arm/scara-robot-arm/stl/Endstop trigger for scara laser.STL

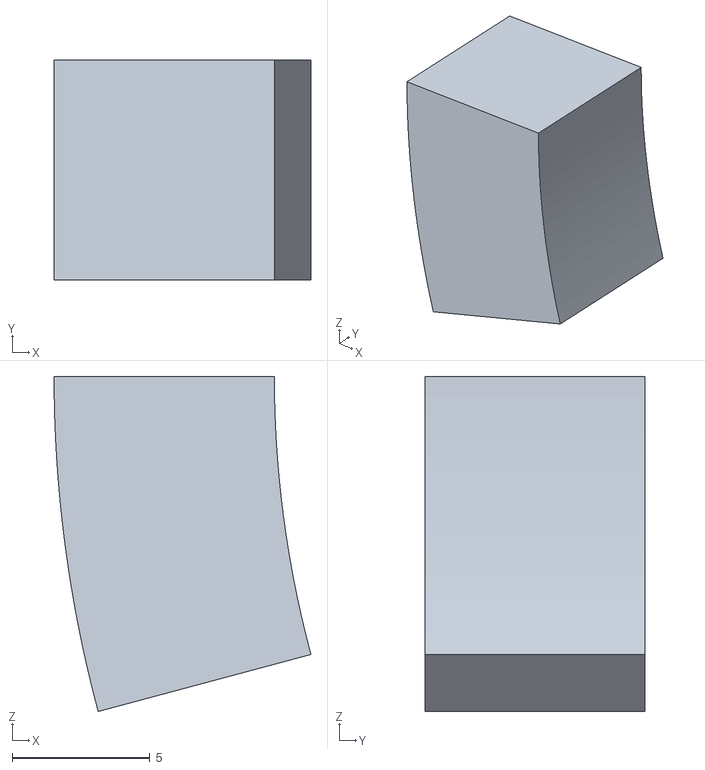
[picture p106: CAD file, 2026-10-31]
media/scara-arm/scara-robot-arm/stl/Endstop trigger for scara laser.STL
9.33 x 8.00 x 12.2
