arjun7n9s/AgriBot/sim/agribot_description/meshes/cutter/visual/cutter_blade.obj

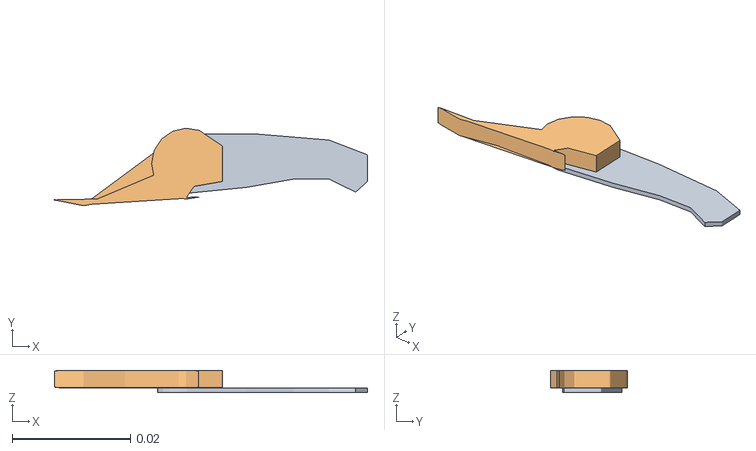
[picture p107: CAD file, 2026-10-31]
sim/agribot_description/meshes/cutter/visual/cutter_blade.obj
0.0529 x 0.0131 x 0.0038
blade
blade_carrier
