arjun7n9s/AgriBot/sim/agribot_description/meshes/rover/visual/wheel.obj

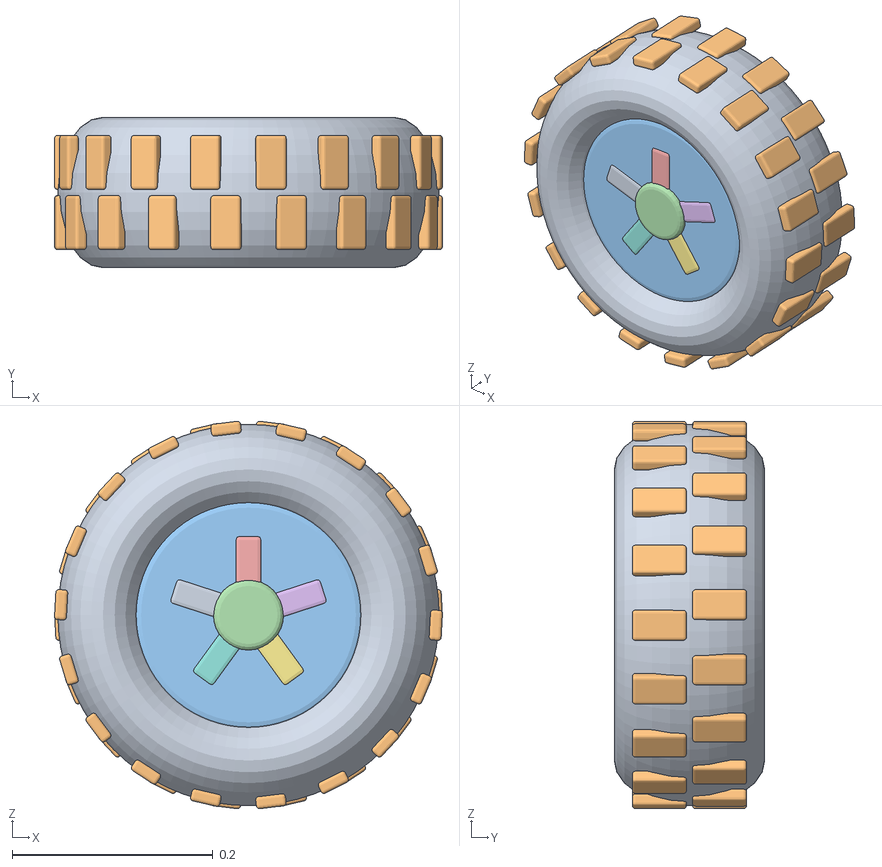
[picture p108: CAD file, 2026-10-31]
sim/agribot_description/meshes/rover/visual/wheel.obj
0.387 x 0.15 x 0.386
tyre
tread
rim
hub
spoke
spoke.001
spoke.002
spoke.003
spoke.004
