arjun7n9s/AgriBot/sim/agribot_description/meshes/scara/collision/carriage_link.stl

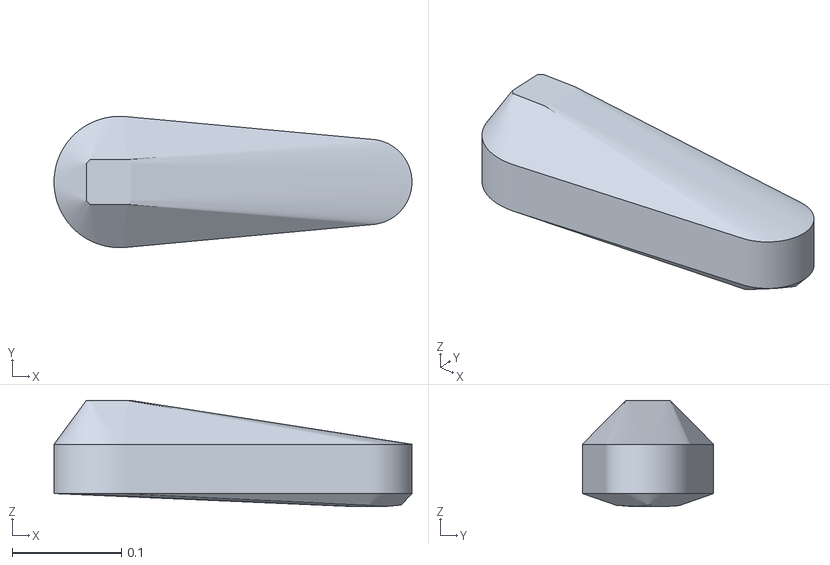
[picture p109: CAD file, 2026-10-31]
sim/agribot_description/meshes/scara/collision/carriage_link.stl
0.327 x 0.12 x 0.0968
