arjun7n9s/AgriBot/sim/agribot_description/meshes/scara/visual/base_link.obj

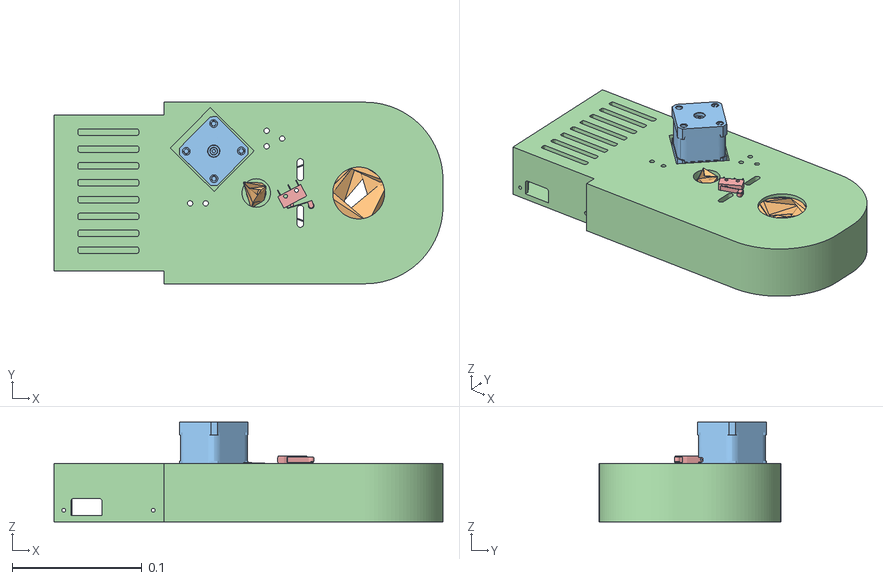
[picture p110: CAD file, 2026-10-31]
sim/agribot_description/meshes/scara/visual/base_link.obj
0.3 x 0.14 x 0.077
base_link_belt
base_link_metal
base_link_motor
base_link_printed
base_link_switch
