arjun7n9s/AgriBot/cad/arm-v2/step/a2-01.step

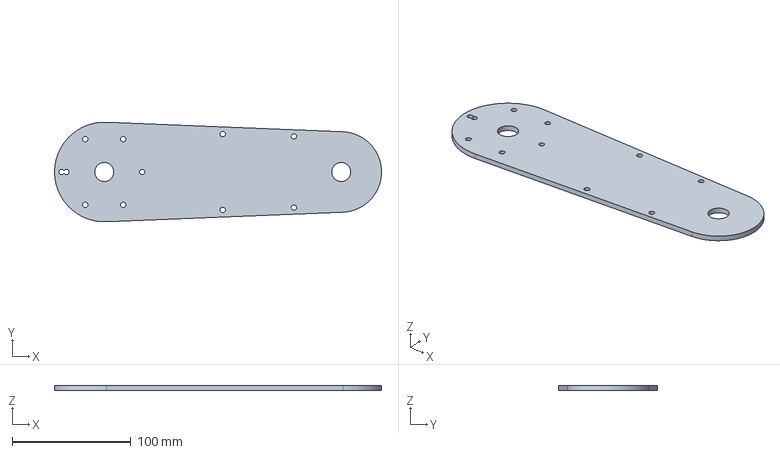
[picture p111: CAD file, 2026-11-03]
cad/arm-v2/step/a2-01.step
275.9 x 83.9 x 4.00 mm
