arjun7n9s/AgriBot/media/scara-arm/scara-robot-arm/solidworks/Base cover.SLDPRT

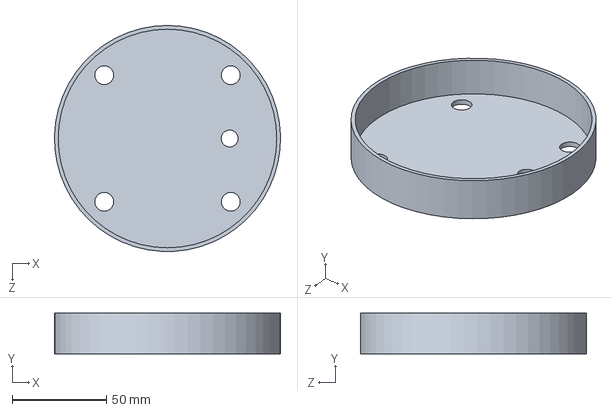
[picture p112: CAD file, 2026-10-31]
media/scara-arm/scara-robot-arm/solidworks/Base cover.SLDPRT
119.9 x 21.5 x 120.0 mm
