arjun7n9s/AgriBot/media/scara-arm/scara-robot-arm/stl/Arduino Mega case.STL

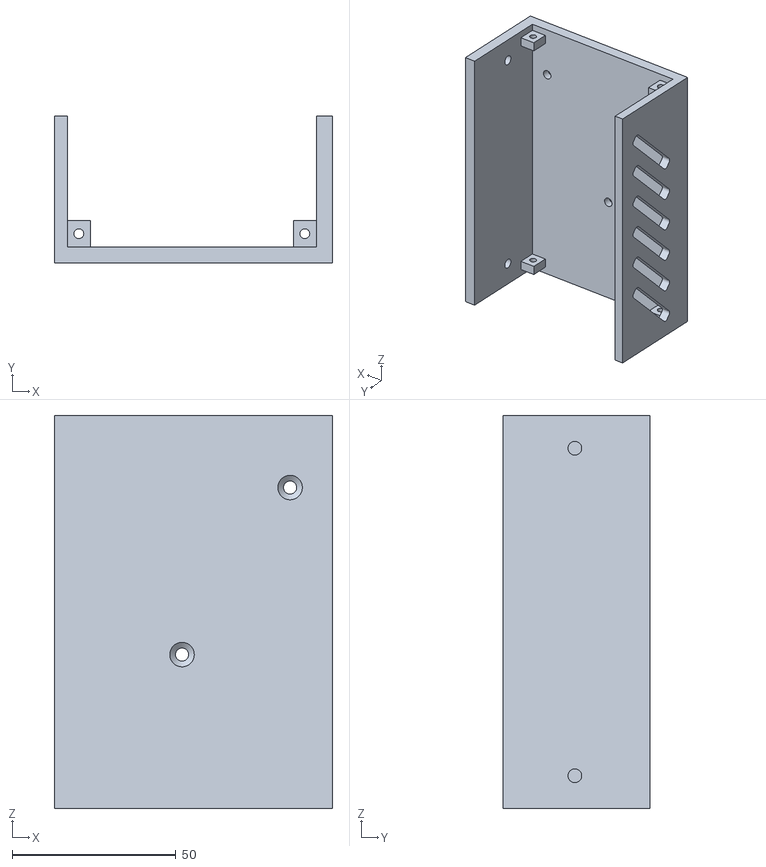
[picture p113: CAD file, 2026-10-31]
media/scara-arm/scara-robot-arm/stl/Arduino Mega case.STL
85.0 x 45.0 x 120.0
