arjun7n9s/AgriBot/sim/agribot_description/meshes/cutter/visual/cutter_door.obj

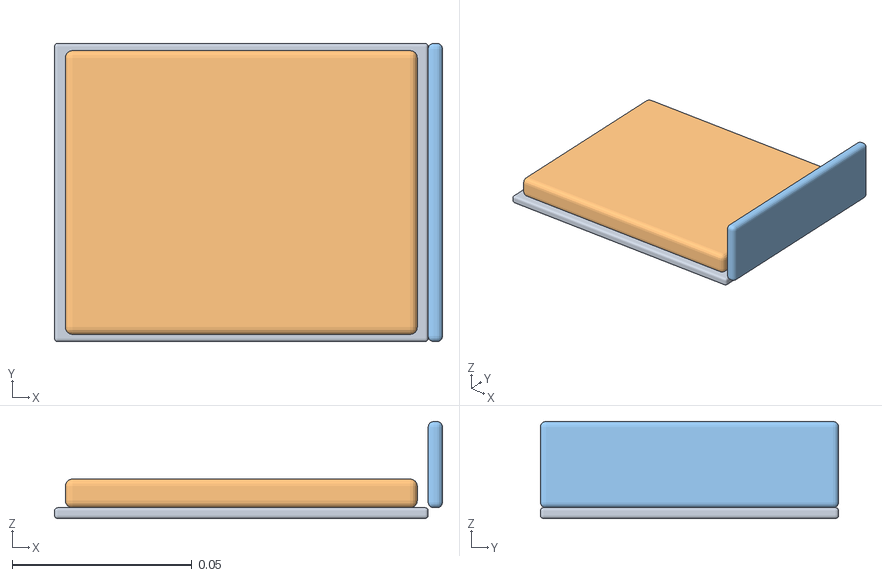
[picture p114: CAD file, 2026-10-31]
sim/agribot_description/meshes/cutter/visual/cutter_door.obj
0.108 x 0.083 x 0.027
door
foam_pad
soft_lip
