arjun7n9s/AgriBot/sim/agribot_description/meshes/rover/visual/scara_mast.obj

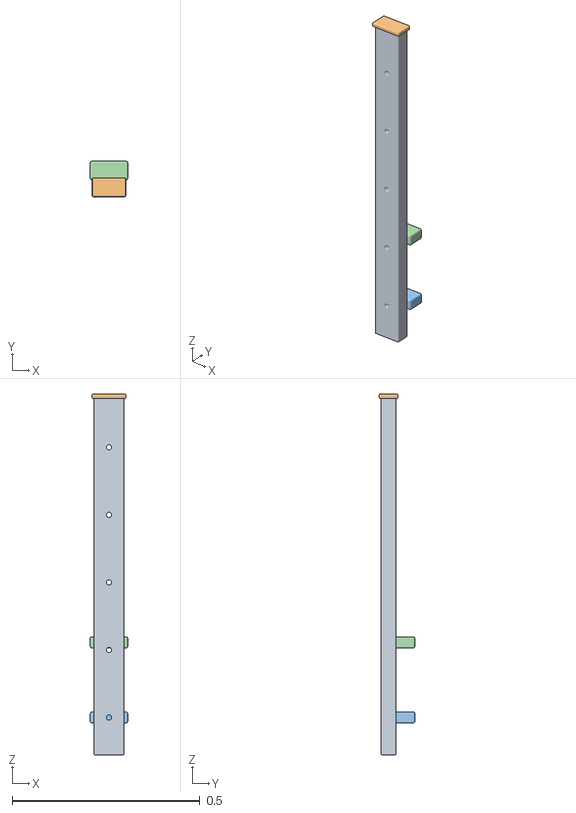
[picture p115: CAD file, 2026-10-31]
sim/agribot_description/meshes/rover/visual/scara_mast.obj
0.1 x 0.095 x 0.962
rail
mast_cap
mast_bracket
mast_bracket.001
