arjun7n9s/AgriBot/sim/agribot_description/meshes/scara/collision/column_link.stl

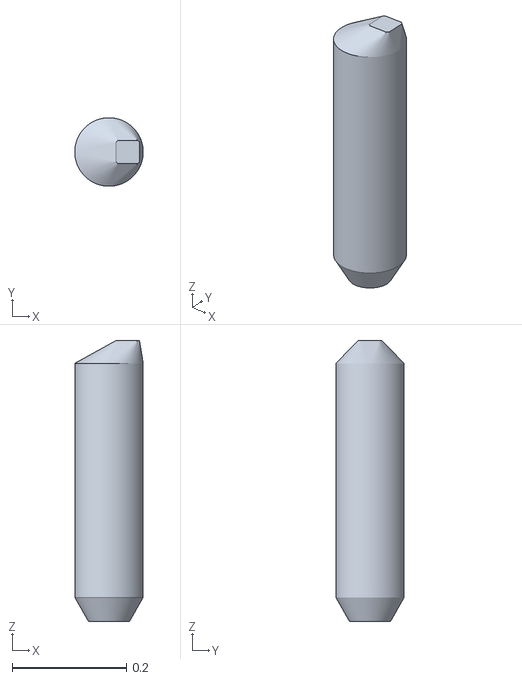
[picture p116: CAD file, 2026-10-31]
sim/agribot_description/meshes/scara/collision/column_link.stl
0.12 x 0.12 x 0.492
