arjun7n9s/AgriBot/sim/agribot_description/meshes/scara/visual/stock_gripper.obj

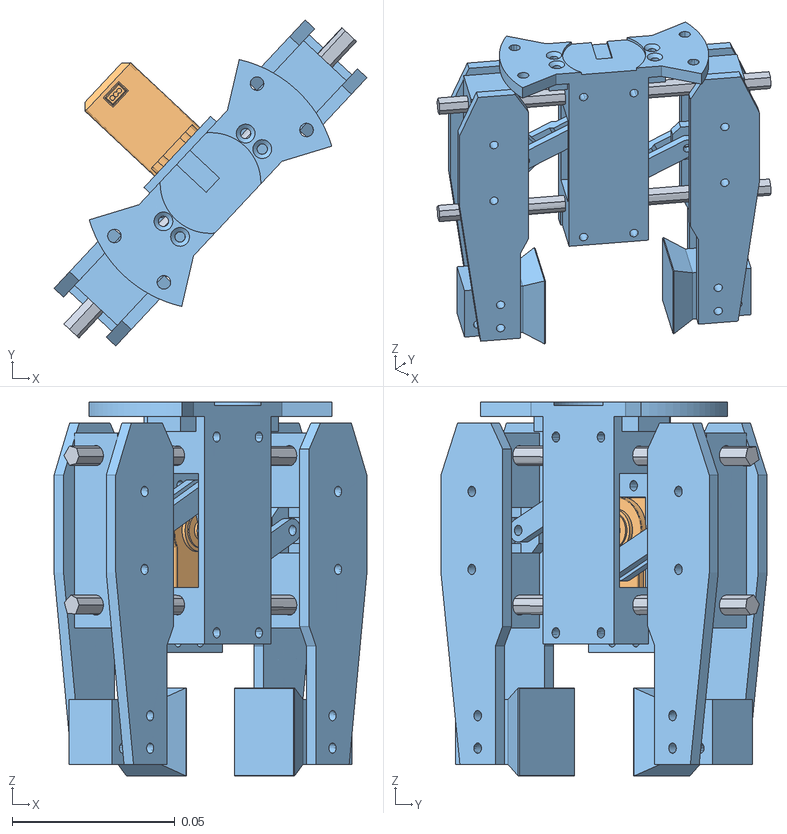
[picture p117: CAD file, 2026-10-31]
sim/agribot_description/meshes/scara/visual/stock_gripper.obj
0.0963 x 0.1 x 0.115
stock_gripper_metal
stock_gripper_motor
stock_gripper_printed
