arjun7n9s/AgriBot/cad/arm-v2/step/t-14.step

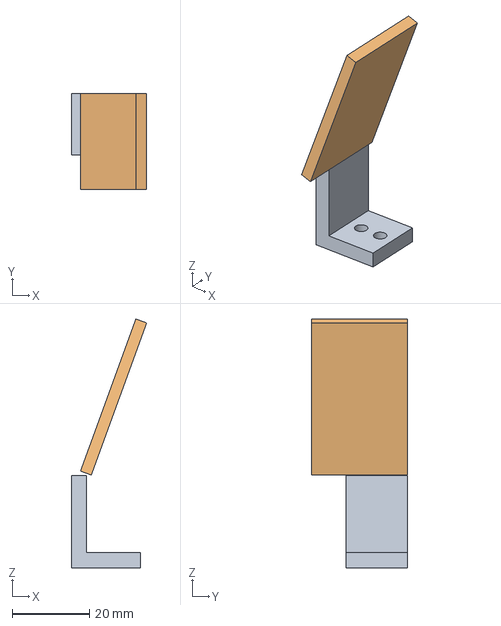
[picture p118: CAD file, 2026-11-03]
cad/arm-v2/step/t-14.step
19.6 x 25.0 x 64.6 mm
