arjun7n9s/AgriBot/media/scara-arm/scara-robot-arm/solidworks/Z-axis Mount Platform.SLDPRT

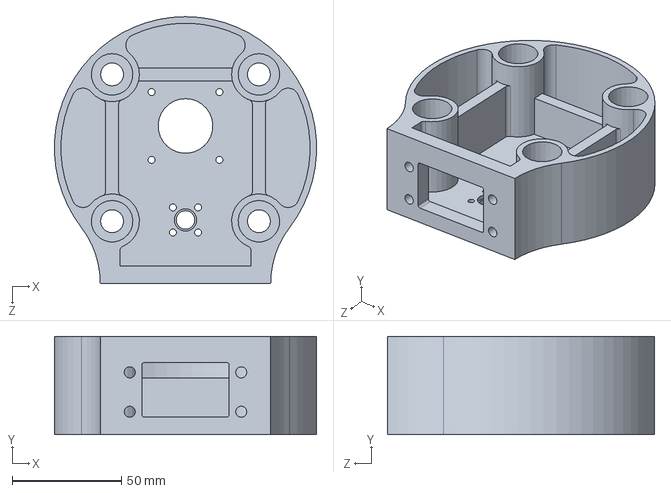
[picture p119: CAD file, 2026-10-31]
media/scara-arm/scara-robot-arm/solidworks/Z-axis Mount Platform.SLDPRT
119.9 x 45.0 x 122.0 mm
