arjun7n9s/AgriBot/media/scara-arm/scara-robot-arm/stl/Wires holder.STL

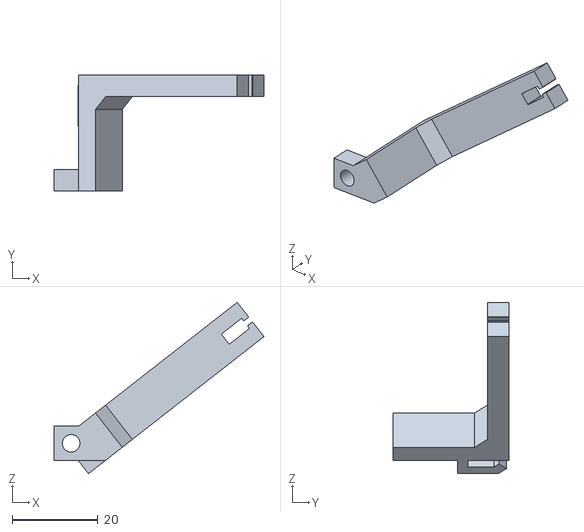
[picture p120: CAD file, 2026-10-31]
media/scara-arm/scara-robot-arm/stl/Wires holder.STL
49.0 x 27.0 x 40.0
