arjun7n9s/AgriBot/sim/agribot_description/meshes/rover/visual/scout_head.obj

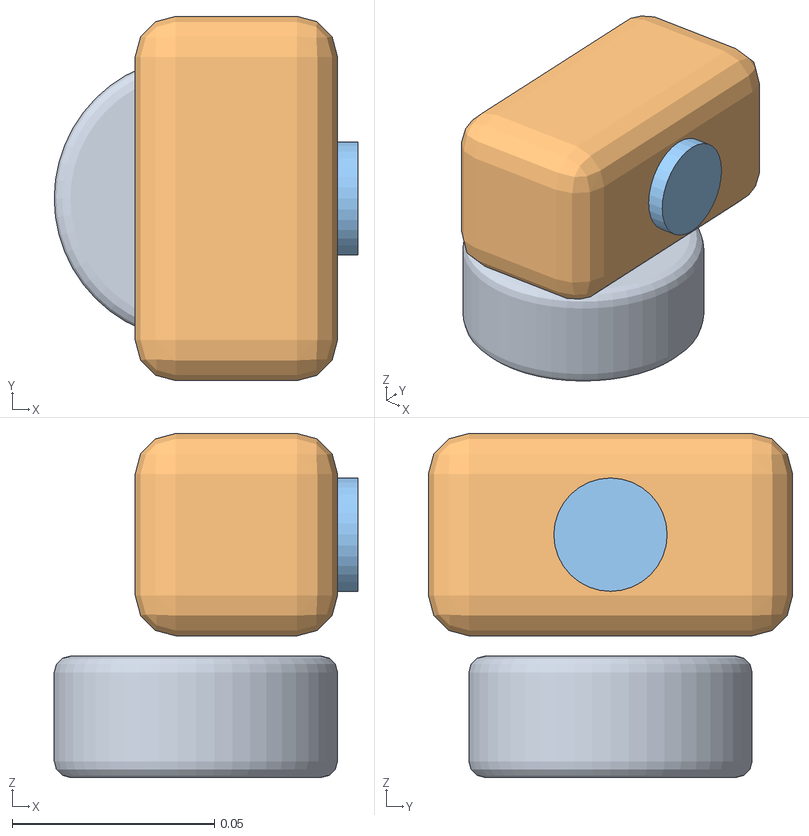
[picture p121: CAD file, 2026-10-31]
sim/agribot_description/meshes/rover/visual/scout_head.obj
0.075 x 0.09 x 0.085
pan_base
scout_cam
scout_lens
