arjun7n9s/AgriBot/sim/agribot_description/meshes/scara/collision/arm2_link.stl

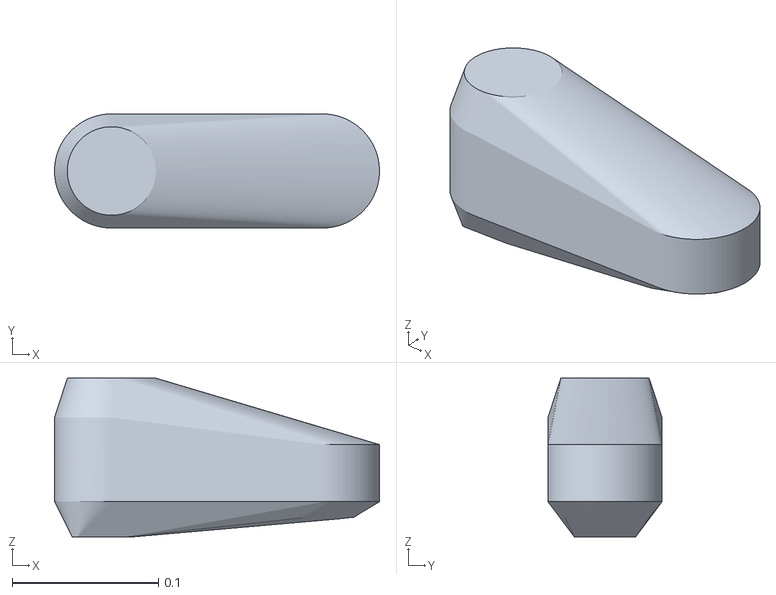
[picture p122: CAD file, 2026-10-31]
sim/agribot_description/meshes/scara/collision/arm2_link.stl
0.222 x 0.078 x 0.108
