arjun7n9s/AgriBot/sim/agribot_description/meshes/scara/visual/carriage_link.obj

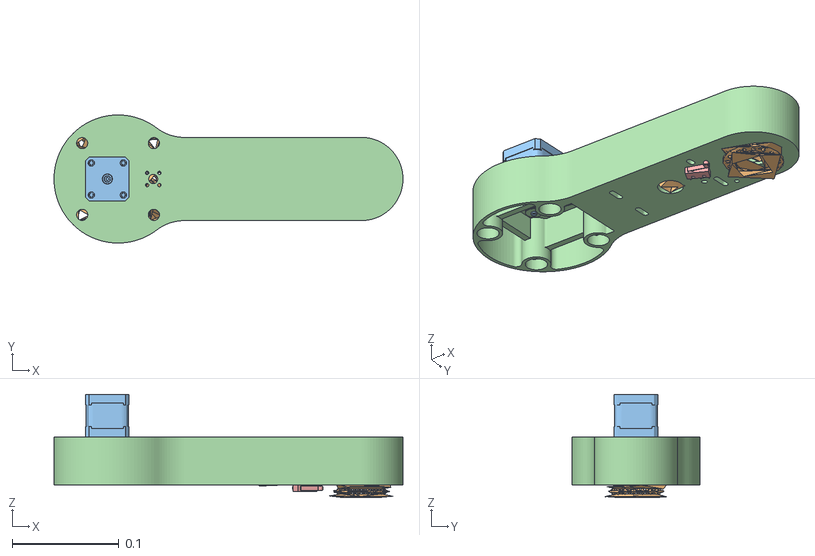
[picture p123: CAD file, 2026-10-31]
sim/agribot_description/meshes/scara/visual/carriage_link.obj
0.327 x 0.12 x 0.0968
carriage_link_belt
carriage_link_metal
carriage_link_motor
carriage_link_printed
carriage_link_switch
