arjun7n9s/AgriBot/cad/arm-v2/step/a1-05.step

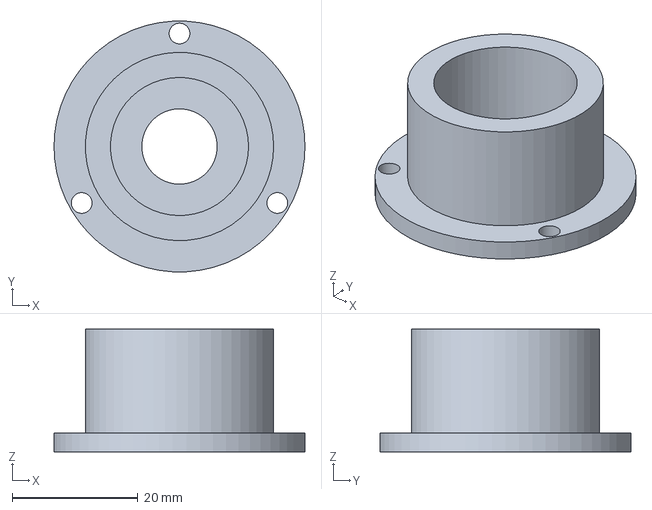
[picture p124: CAD file, 2026-11-03]
cad/arm-v2/step/a1-05.step
40.0 x 39.9 x 19.6 mm
