arjun7n9s/AgriBot/media/scara-arm/scara-robot-arm/solidworks/Gripper Mechanism Slider.SLDPRT

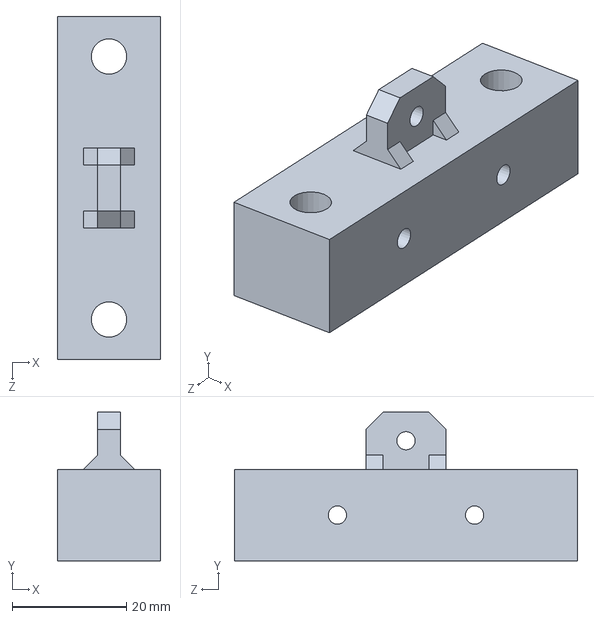
[picture p125: CAD file, 2026-10-31]
media/scara-arm/scara-robot-arm/solidworks/Gripper Mechanism Slider.SLDPRT
18.0 x 26.0 x 60.0 mm
