arjun7n9s/AgriBot/media/scara-arm/scara-robot-arm/stl/Arduino Mega case p2.STL

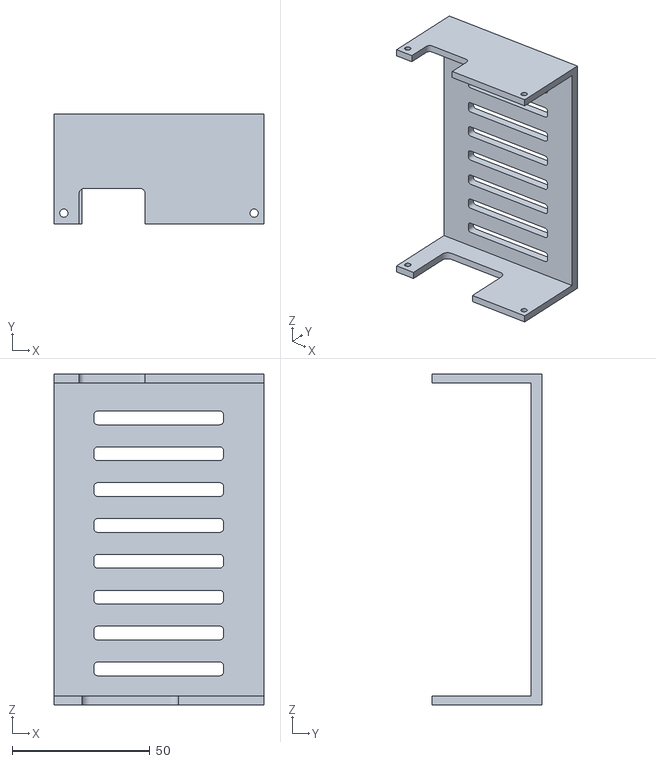
[picture p126: CAD file, 2026-10-31]
media/scara-arm/scara-robot-arm/stl/Arduino Mega case p2.STL
76.0 x 40.0 x 120.0
