arjun7n9s/AgriBot/sim/agribot_description/meshes/rover/visual/harvest_crate.obj

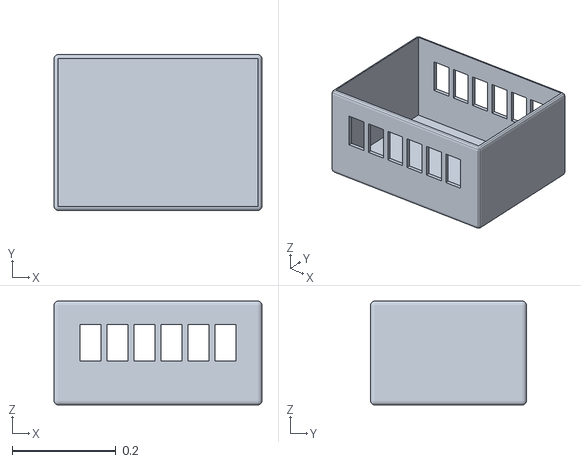
[picture p127: CAD file, 2026-10-31]
sim/agribot_description/meshes/rover/visual/harvest_crate.obj
0.4 x 0.3 x 0.2
