arjun7n9s/AgriBot/sim/agribot_description/meshes/scara/collision/stock_gripper.stl

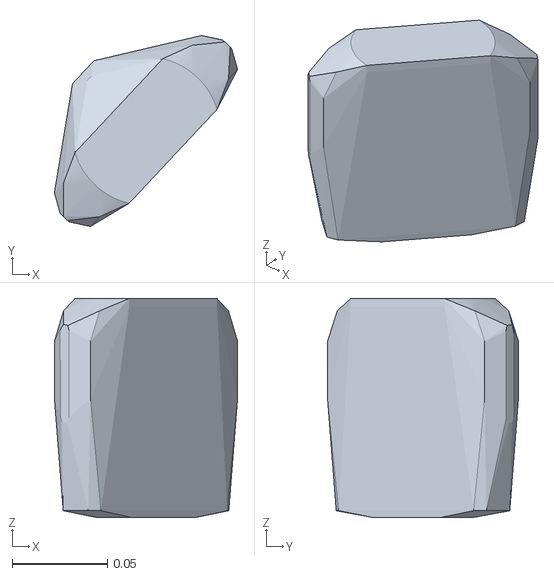
[picture p128: CAD file, 2026-10-31]
sim/agribot_description/meshes/scara/collision/stock_gripper.stl
0.0963 x 0.1 x 0.115
