arjun7n9s/AgriBot/sim/agribot_description/meshes/scara/visual/column_link.obj

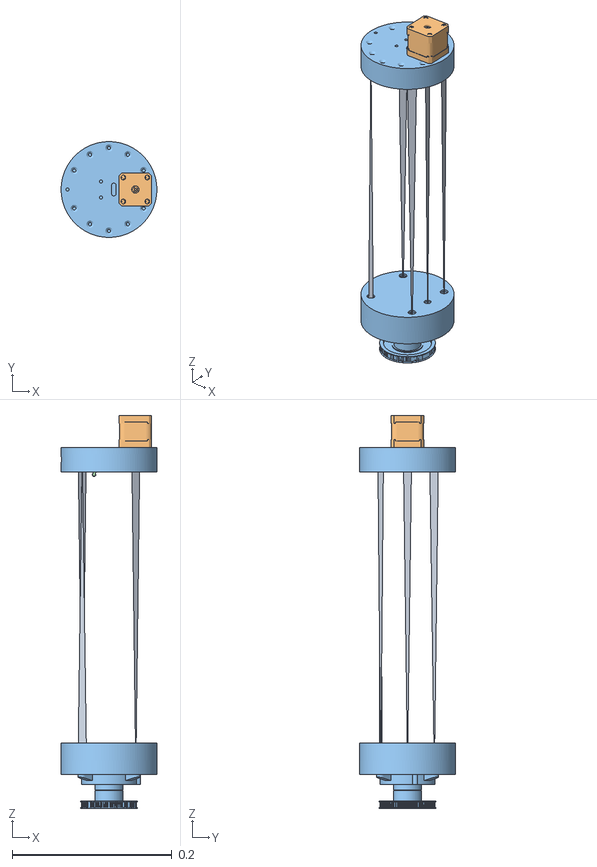
[picture p129: CAD file, 2026-10-31]
sim/agribot_description/meshes/scara/visual/column_link.obj
0.12 x 0.12 x 0.492
column_link_metal
column_link_motor
column_link_printed
column_link_switch
