arjun7n9s/AgriBot/cad/arm-v2/step/t-02.step

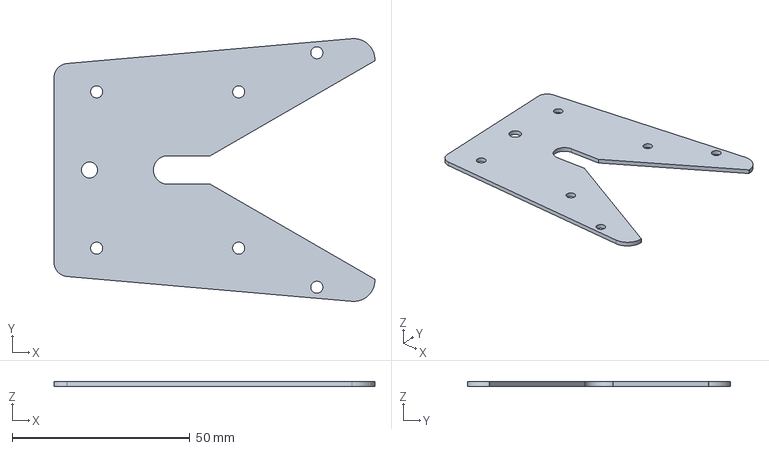
[picture p130: CAD file, 2026-11-03]
cad/arm-v2/step/t-02.step
90.4 x 74.0 x 1.50 mm
