arjun7n9s/AgriBot/media/scara-arm/scara-robot-arm/solidworks/Smooth Rod D10mm L400mm.SLDPRT

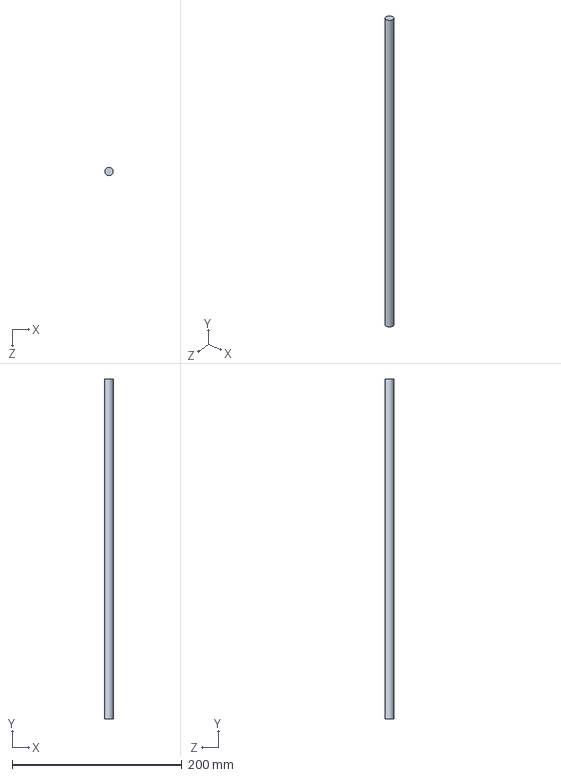
[picture p131: CAD file, 2026-10-31]
media/scara-arm/scara-robot-arm/solidworks/Smooth Rod D10mm L400mm.SLDPRT
10.0 x 400.0 x 10.0 mm
