arjun7n9s/AgriBot/sim/agribot_description/meshes/rover/visual/scout_mast.obj

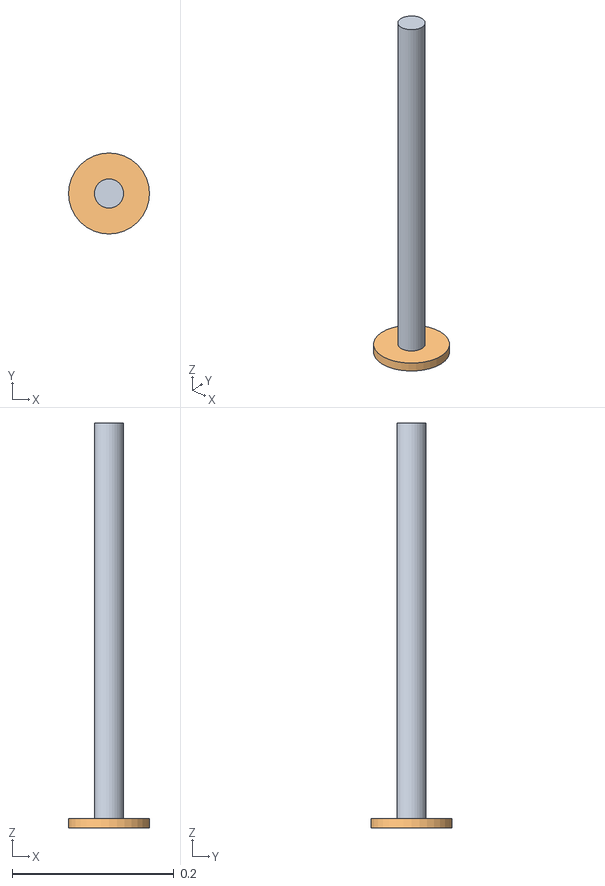
[picture p132: CAD file, 2026-10-31]
sim/agribot_description/meshes/rover/visual/scout_mast.obj
0.1 x 0.1 x 0.5
scout_pole
scout_foot
