arjun7n9s/AgriBot/sim/agribot_description/meshes/scara/collision/base_link.stl

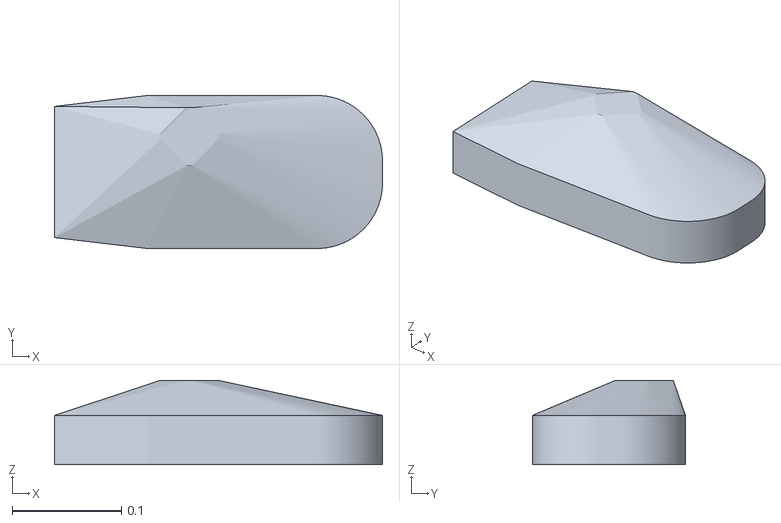
[picture p133: CAD file, 2026-10-31]
sim/agribot_description/meshes/scara/collision/base_link.stl
0.3 x 0.14 x 0.077
