arjun7n9s/AgriBot/sim/agribot_description/meshes/scara/visual/arm2_link.obj

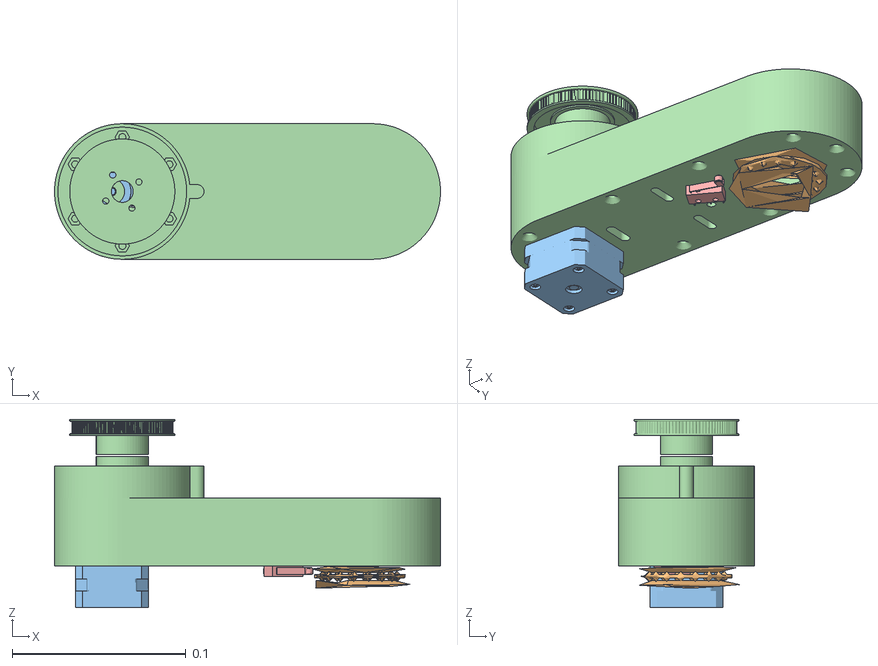
[picture p134: CAD file, 2026-10-31]
sim/agribot_description/meshes/scara/visual/arm2_link.obj
0.222 x 0.078 x 0.108
arm2_link_belt
arm2_link_metal
arm2_link_motor
arm2_link_printed
arm2_link_switch
