arjun7n9s/AgriBot/cad/arm-v2/step/a1-04.step

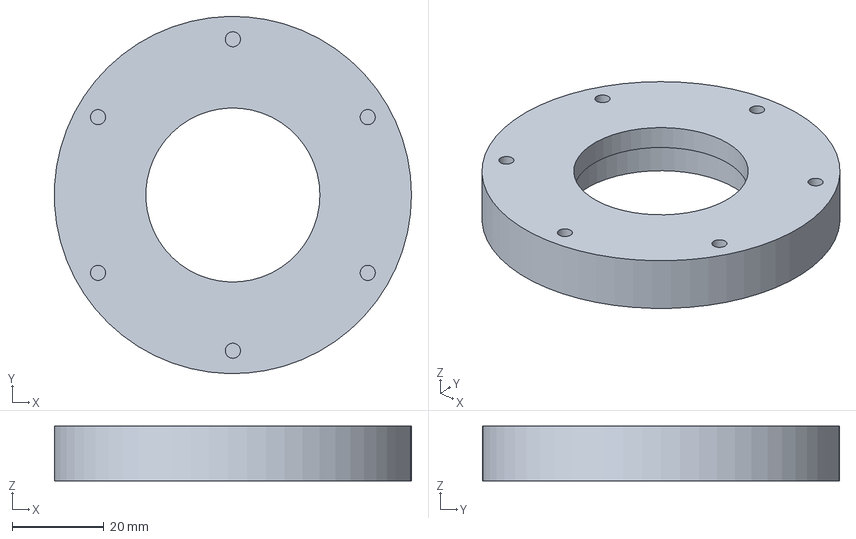
[picture p135: CAD file, 2026-11-03]
cad/arm-v2/step/a1-04.step
77.9 x 78.0 x 12.0 mm
