arjun7n9s/AgriBot/cad/arm-v2/step/a2-04.step

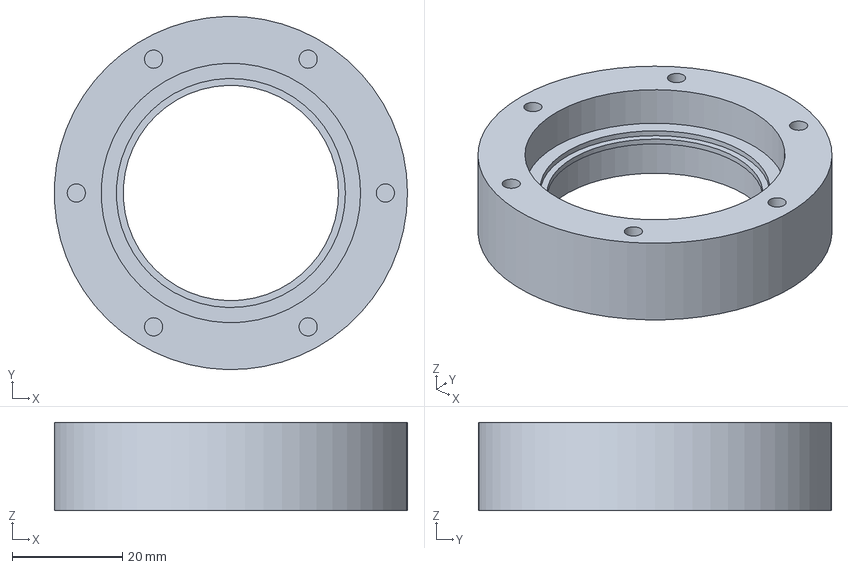
[picture p136: CAD file, 2026-11-03]
cad/arm-v2/step/a2-04.step
64.0 x 64.0 x 16.0 mm
