arjun7n9s/AgriBot/media/scara-arm/scara-robot-arm/solidworks/Arduino UNO case p2.SLDPRT

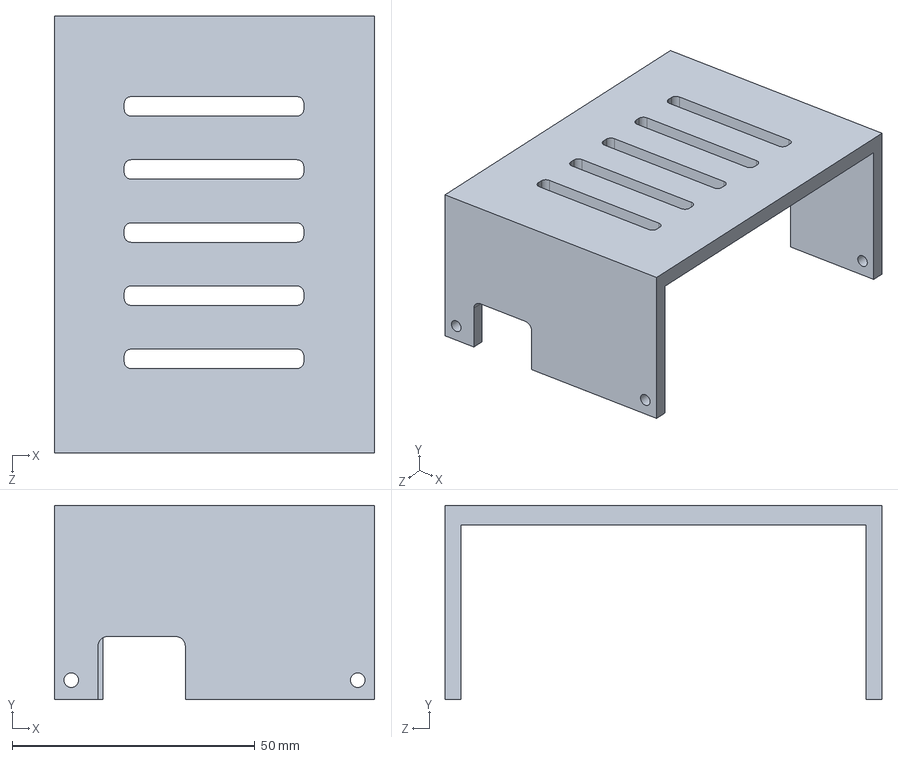
[picture p137: CAD file, 2026-10-31]
media/scara-arm/scara-robot-arm/solidworks/Arduino UNO case p2.SLDPRT
66.0 x 40.0 x 90.0 mm
