arjun7n9s/AgriBot/cad/arm-v2/step/t-13.step

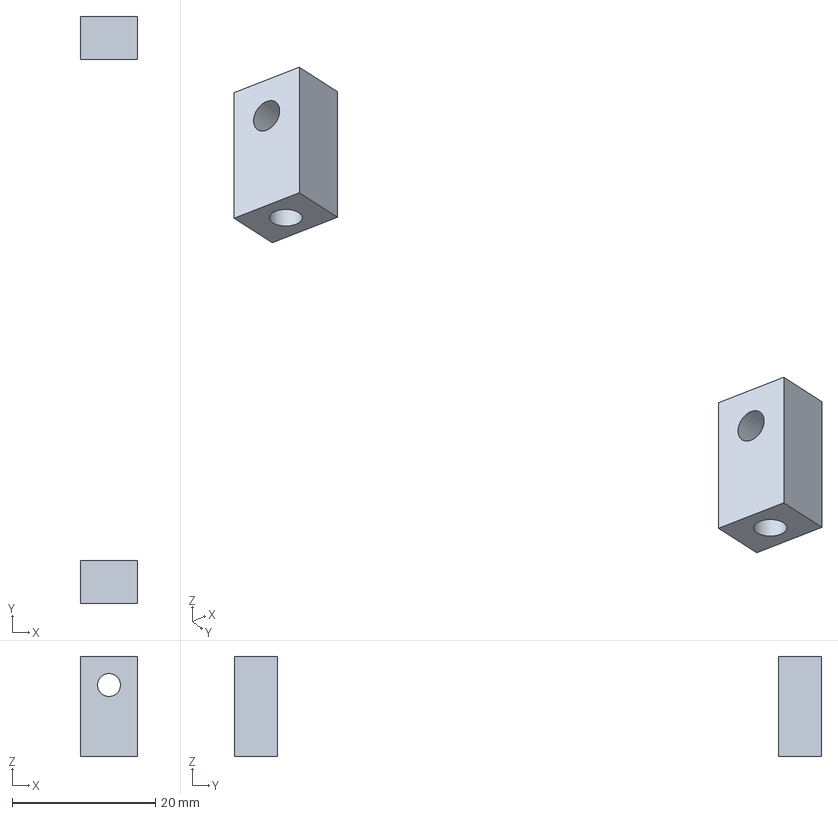
[picture p138: CAD file, 2026-11-03]
cad/arm-v2/step/t-13.step
8.00 x 82.0 x 14.0 mm
