arjun7n9s/AgriBot/media/scara-arm/scara-robot-arm/solidworks/Arm 2 Cover.SLDPRT

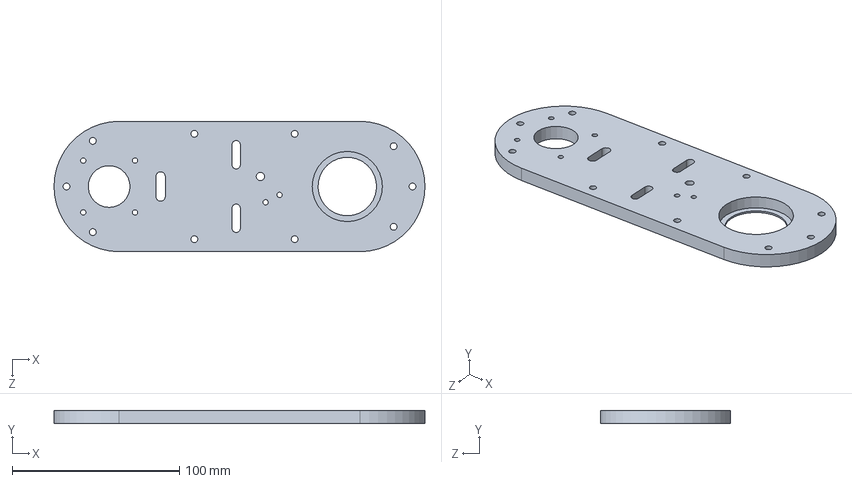
[picture p139: CAD file, 2026-10-31]
media/scara-arm/scara-robot-arm/solidworks/Arm 2 Cover.SLDPRT
222.0 x 8.00 x 78.0 mm
