arjun7n9s/AgriBot/cad/arm-v2/step/t-03.step

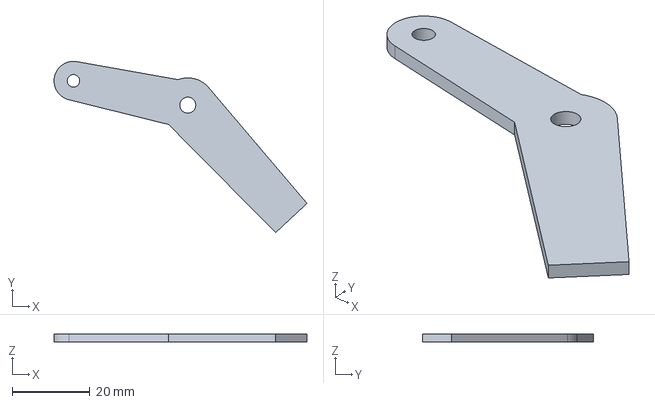
[picture p140: CAD file, 2026-11-03]
cad/arm-v2/step/t-03.step
64.9 x 44.0 x 2.00 mm
