arjun7n9s/AgriBot/media/scara-arm/scara-robot-arm/solidworks/Arm 1 Cover.SLDPRT

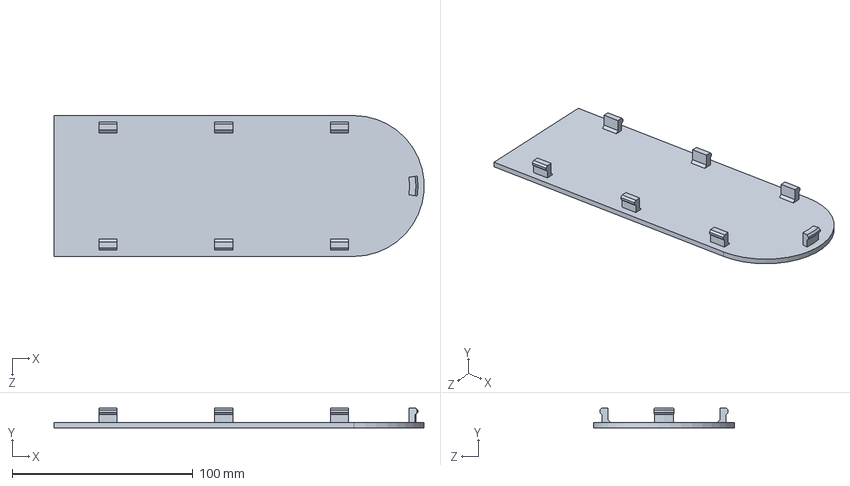
[picture p141: CAD file, 2026-10-31]
media/scara-arm/scara-robot-arm/solidworks/Arm 1 Cover.SLDPRT
204.9 x 11.0 x 78.0 mm
