arjun7n9s/AgriBot/cad/arm-v2/step/t-09.step

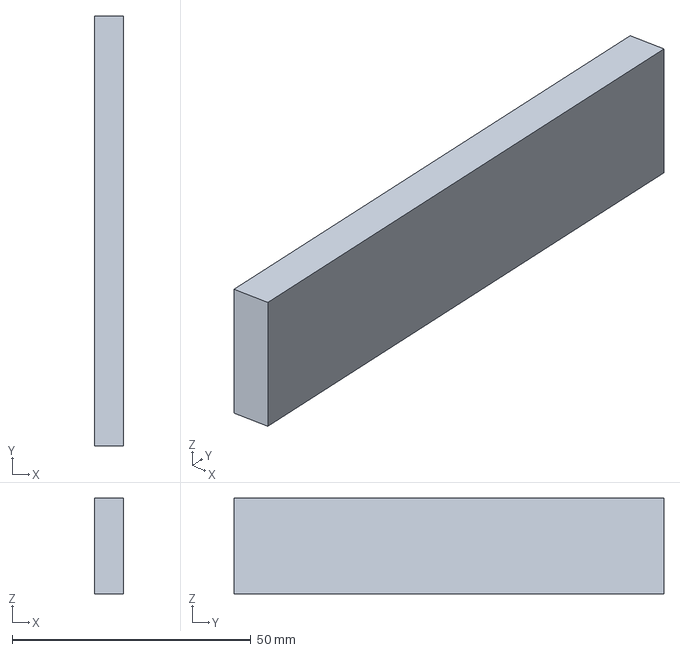
[picture p142: CAD file, 2026-11-03]
cad/arm-v2/step/t-09.step
6.00 x 90.0 x 20.0 mm
