arjun7n9s/AgriBot/media/scara-arm/scara-robot-arm/solidworks/Gripper End.SLDPRT

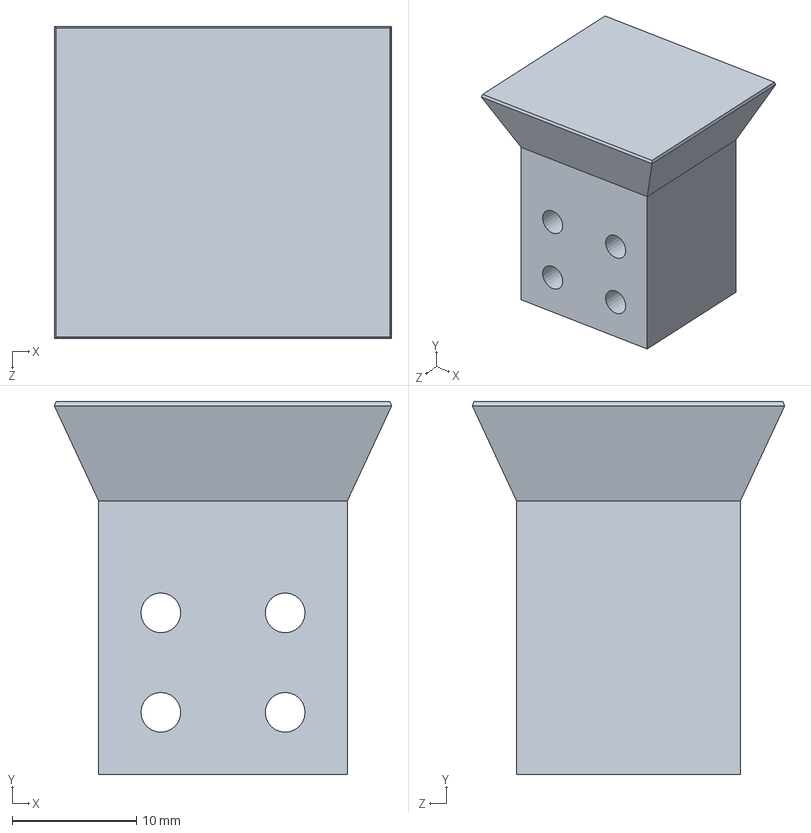
[picture p143: CAD file, 2026-10-31]
media/scara-arm/scara-robot-arm/solidworks/Gripper End.SLDPRT
27.1 x 30.0 x 25.1 mm
