arjun7n9s/AgriBot/cad/arm-v2/step/j3-01.step

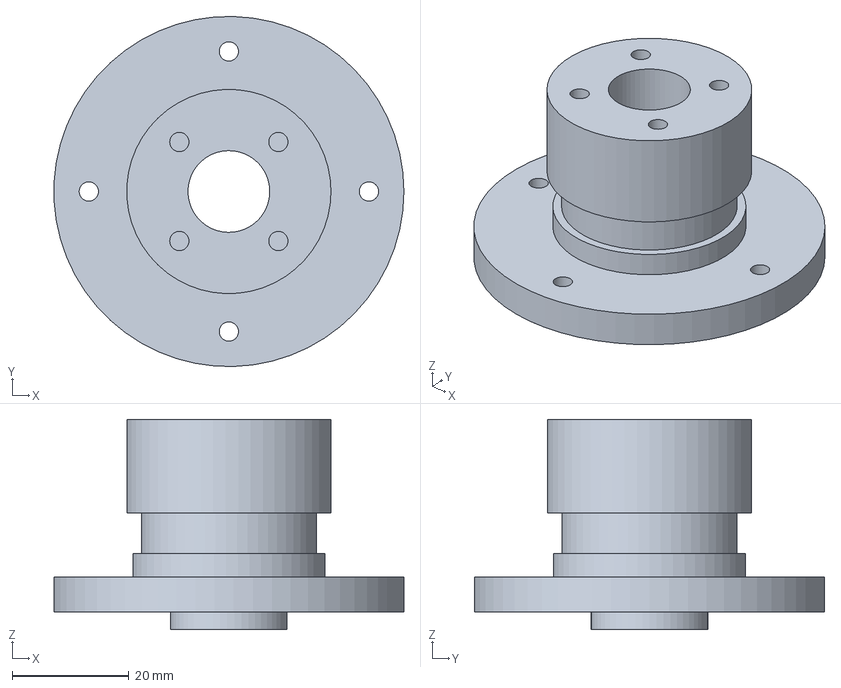
[picture p144: CAD file, 2026-11-03]
cad/arm-v2/step/j3-01.step
60.0 x 60.0 x 36.0 mm
