arjun7n9s/AgriBot/cad/arm-v2/step/t-01.step

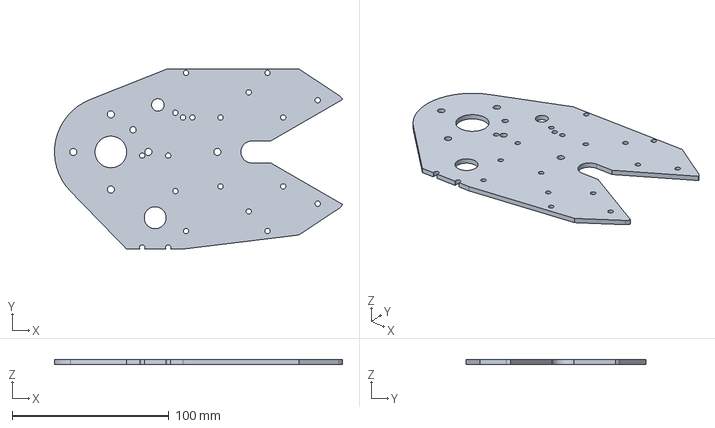
[picture p145: CAD file, 2026-11-03]
cad/arm-v2/step/t-01.step
183.8 x 115.0 x 3.00 mm
