arjun7n9s/AgriBot/media/scara-arm/scara-robot-arm/solidworks/Gripper Hand Left.SLDPRT

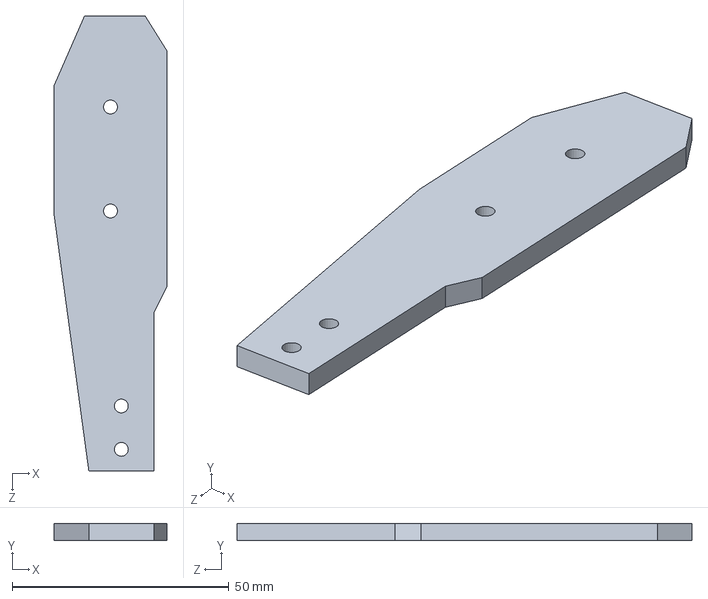
[picture p146: CAD file, 2026-10-31]
media/scara-arm/scara-robot-arm/solidworks/Gripper Hand Left.SLDPRT
26.0 x 4.00 x 105.0 mm
