arjun7n9s/AgriBot/cad/arm-v2/step/a1-01.step

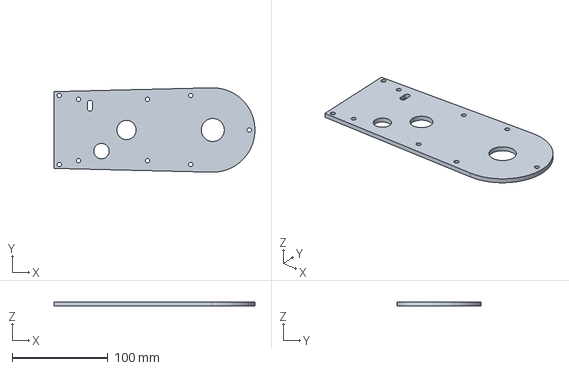
[picture p147: CAD file, 2026-11-03]
cad/arm-v2/step/a1-01.step
209.5 x 88.0 x 4.00 mm
