arjun7n9s/AgriBot/media/scara-arm/scara-robot-arm/solidworks/Arm 1.SLDPRT

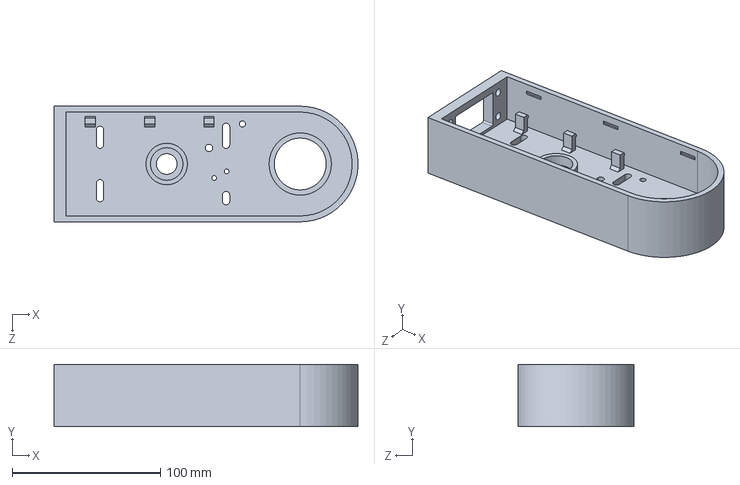
[picture p148: CAD file, 2026-10-31]
media/scara-arm/scara-robot-arm/solidworks/Arm 1.SLDPRT
204.9 x 42.0 x 78.0 mm
