arjun7n9s/AgriBot/cad/arm-v2/step/t-04.step

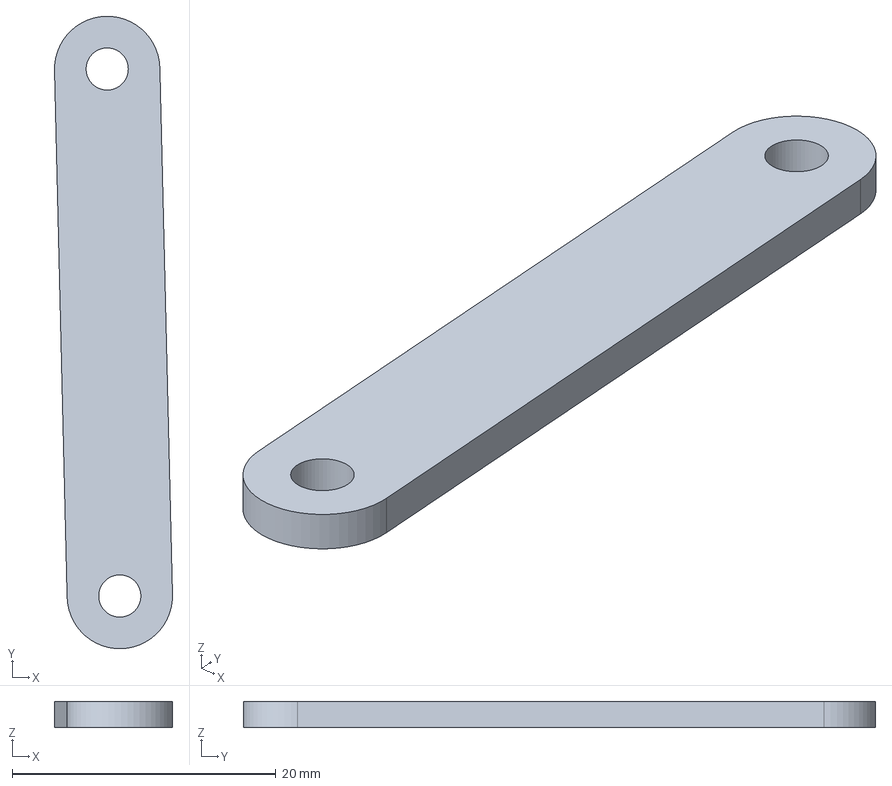
[picture p149: CAD file, 2026-11-03]
cad/arm-v2/step/t-04.step
8.95 x 48.0 x 2.00 mm
