arjun7n9s/AgriBot/media/scara-arm/scara-robot-arm/solidworks/Base.SLDPRT

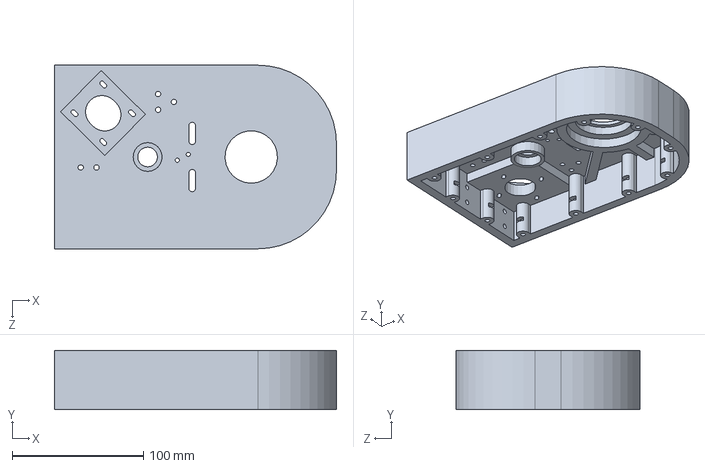
[picture p150: CAD file, 2026-10-31]
media/scara-arm/scara-robot-arm/solidworks/Base.SLDPRT
215.0 x 45.0 x 140.0 mm
