arjun7n9s/AgriBot/cad/arm-v2/step/t-05.step

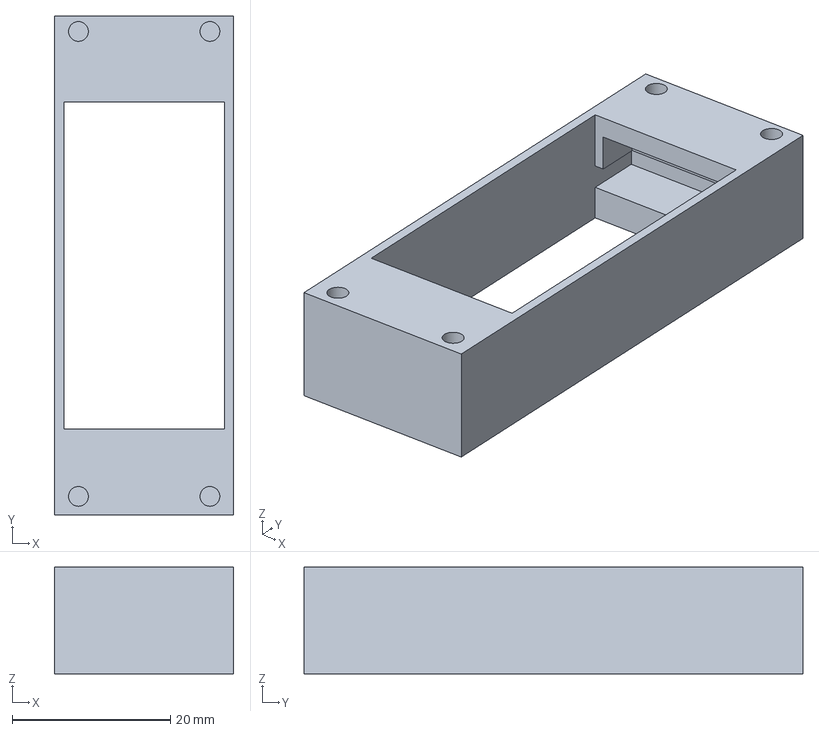
[picture p151: CAD file, 2026-11-03]
cad/arm-v2/step/t-05.step
22.7 x 63.0 x 13.5 mm
