arjun7n9s/AgriBot/media/scara-arm/scara-robot-arm/solidworks/Z-axis Top Plate.SLDPRT

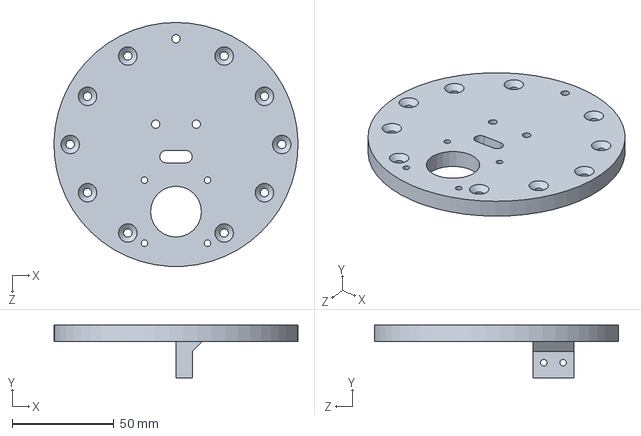
[picture p152: CAD file, 2026-10-31]
media/scara-arm/scara-robot-arm/solidworks/Z-axis Top Plate.SLDPRT
119.9 x 26.0 x 120.0 mm
