arjun7n9s/AgriBot/cad/arm-v2/step/j3-02.step

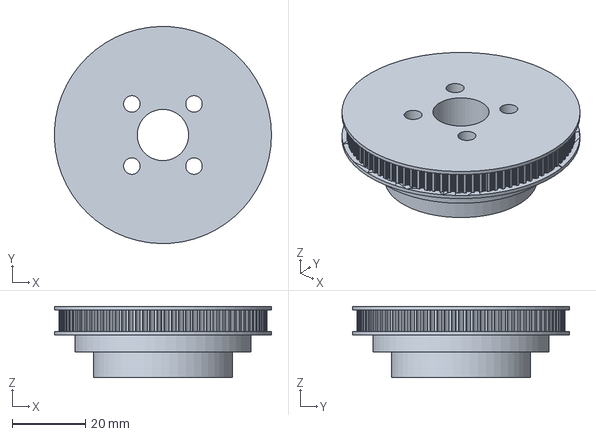
[picture p153: CAD file, 2026-11-03]
cad/arm-v2/step/j3-02.step
59.3 x 59.3 x 19.4 mm
