arjun7n9s/AgriBot/media/scara-arm/scara-robot-arm/solidworks/Gripper link 1.SLDPRT

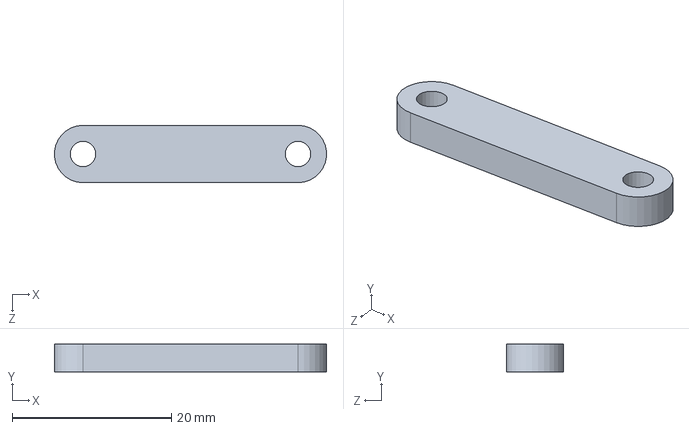
[picture p154: CAD file, 2026-10-31]
media/scara-arm/scara-robot-arm/solidworks/Gripper link 1.SLDPRT
34.2 x 3.50 x 7.20 mm
