arjun7n9s/AgriBot/cad/arm-v2/step/t-10.step

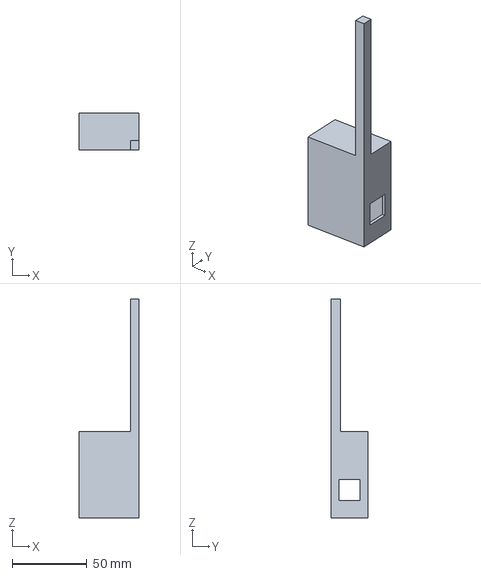
[picture p155: CAD file, 2026-11-03]
cad/arm-v2/step/t-10.step
40.5 x 25.0 x 146.8 mm
