arjun7n9s/AgriBot/media/scara-arm/scara-robot-arm/solidworks/Ball Bearing 35x47x7mm.SLDPRT

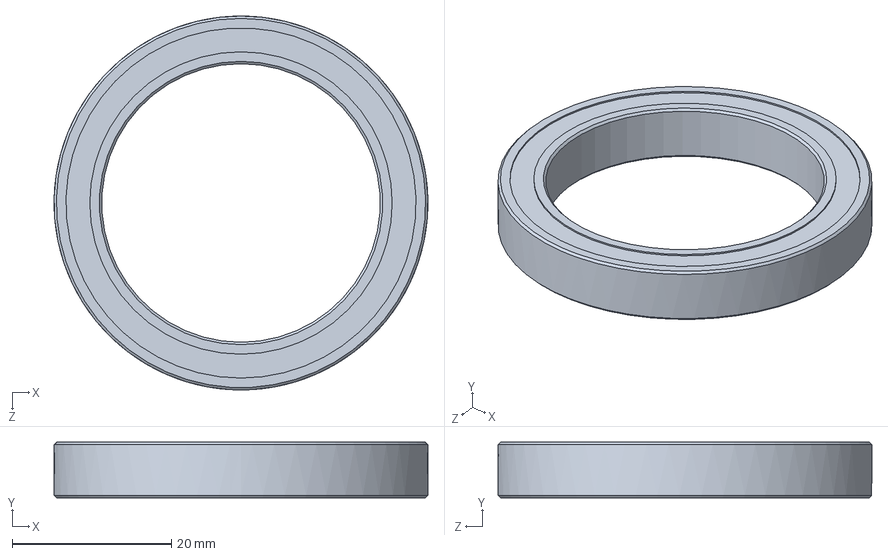
[picture p156: CAD file, 2026-10-31]
media/scara-arm/scara-robot-arm/solidworks/Ball Bearing 35x47x7mm.SLDPRT
47.0 x 7.00 x 47.0 mm
