arjun7n9s/AgriBot/cad/arm-v2/step/t-07.step

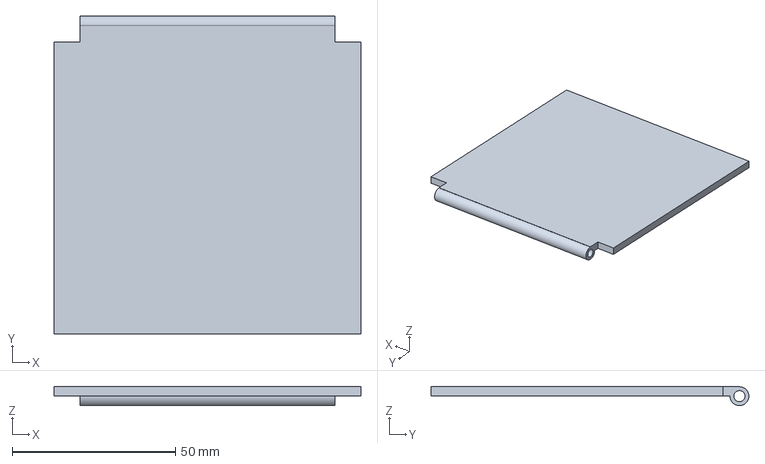
[picture p157: CAD file, 2026-11-03]
cad/arm-v2/step/t-07.step
94.1 x 97.4 x 5.90 mm
