arjun7n9s/AgriBot/media/scara-arm/scara-robot-arm/solidworks/Gripper rail 6mm.SLDPRT

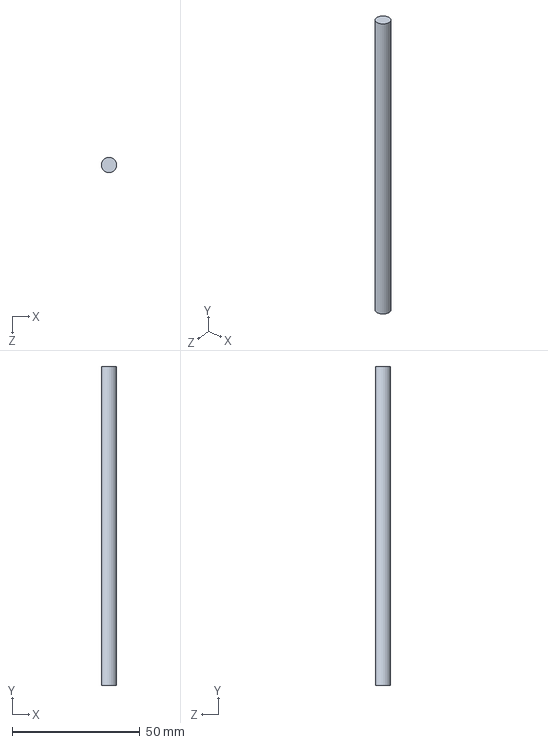
[picture p158: CAD file, 2026-10-31]
media/scara-arm/scara-robot-arm/solidworks/Gripper rail 6mm.SLDPRT
6.00 x 125.0 x 6.00 mm
