arjun7n9s/AgriBot/cad/arm-v2/step/a2-02.step

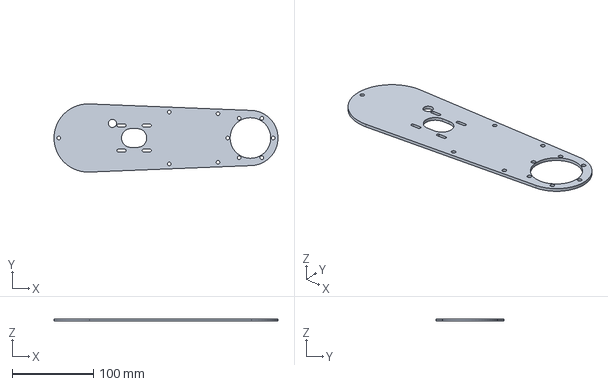
[picture p159: CAD file, 2026-11-03]
cad/arm-v2/step/a2-02.step
275.9 x 83.9 x 3.00 mm
