arjun7n9s/AgriBot/media/scara-arm/scara-robot-arm/solidworks/GT2 Pulley - Parametric.SLDPRT

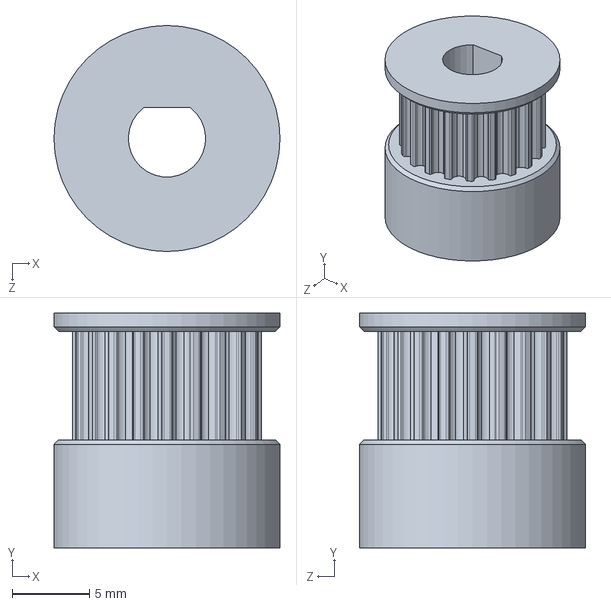
[picture p160: CAD file, 2026-10-31]
media/scara-arm/scara-robot-arm/solidworks/GT2 Pulley - Parametric.SLDPRT
14.6 x 15.2 x 14.6 mm
