arjun7n9s/AgriBot/cad/arm-v2/step/j2-01.step

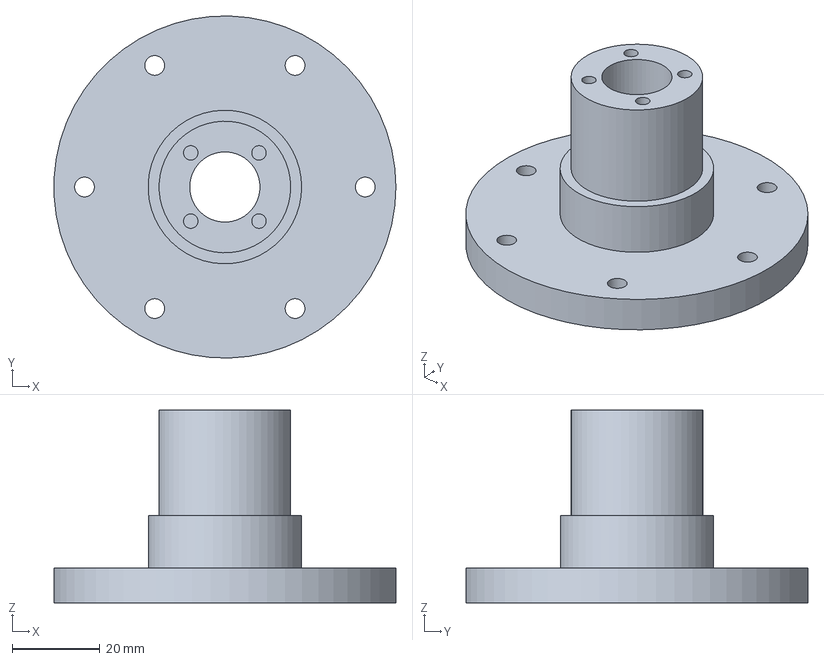
[picture p161: CAD file, 2026-11-03]
cad/arm-v2/step/j2-01.step
77.9 x 78.0 x 44.0 mm
