arjun7n9s/AgriBot/cad/arm-v2/step/t-11.step

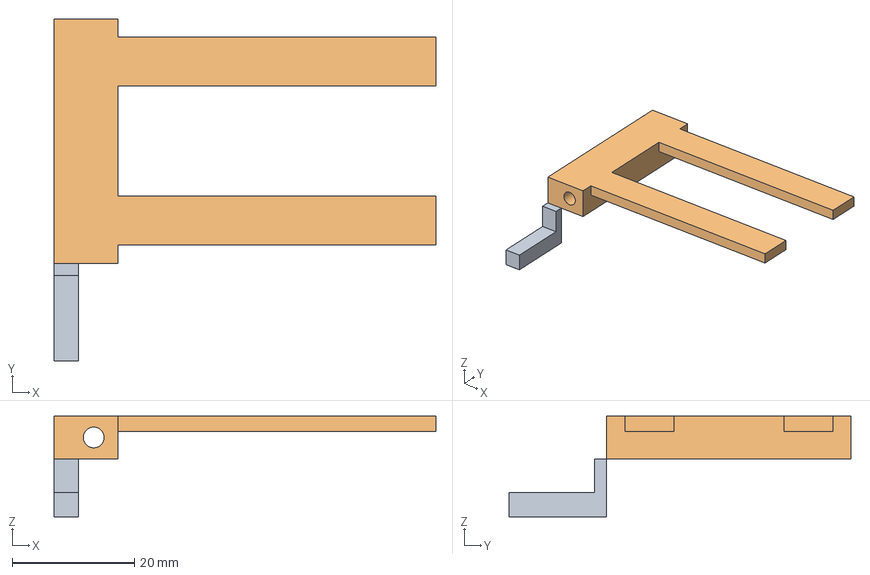
[picture p162: CAD file, 2026-11-03]
cad/arm-v2/step/t-11.step
62.5 x 56.0 x 16.5 mm
