arjun7n9s/AgriBot/media/scara-arm/scara-robot-arm/solidworks/Thrust Bearing - 40x60x13.SLDPRT

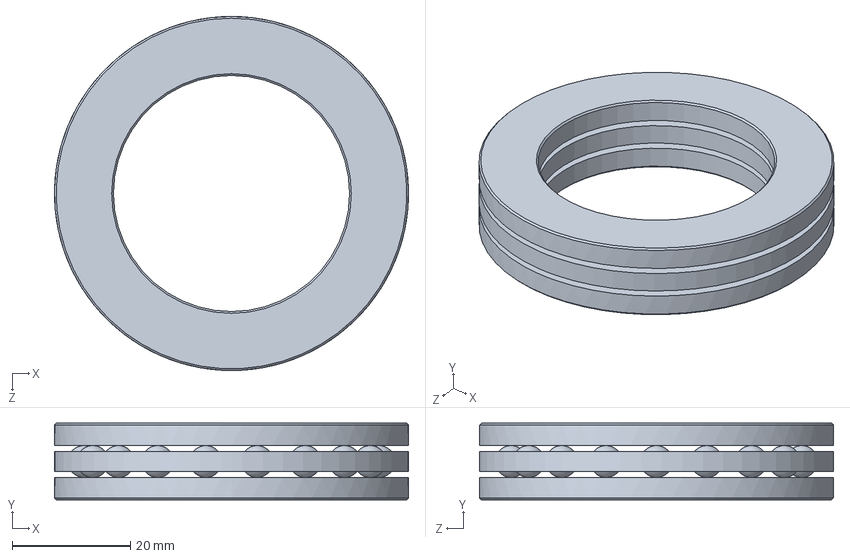
[picture p163: CAD file, 2026-10-31]
media/scara-arm/scara-robot-arm/solidworks/Thrust Bearing - 40x60x13.SLDPRT
60.0 x 13.0 x 60.0 mm
