arjun7n9s/AgriBot/cad/arm-v2/step/j2-02.step

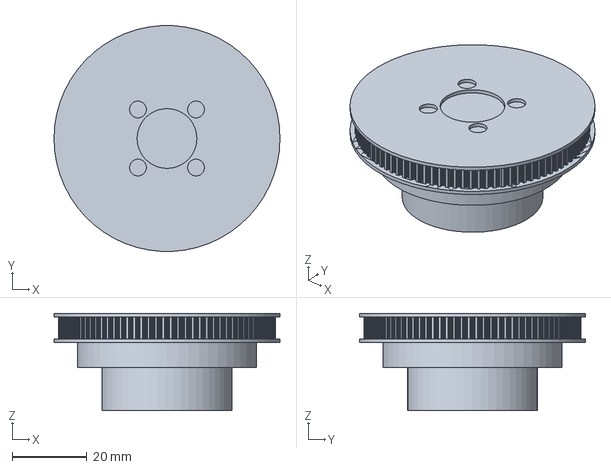
[picture p164: CAD file, 2026-11-03]
cad/arm-v2/step/j2-02.step
60.6 x 60.5 x 26.0 mm
