arjun7n9s/AgriBot/media/scara-arm/scara-robot-arm/solidworks/Servo Motor MG996R 3D Model.step

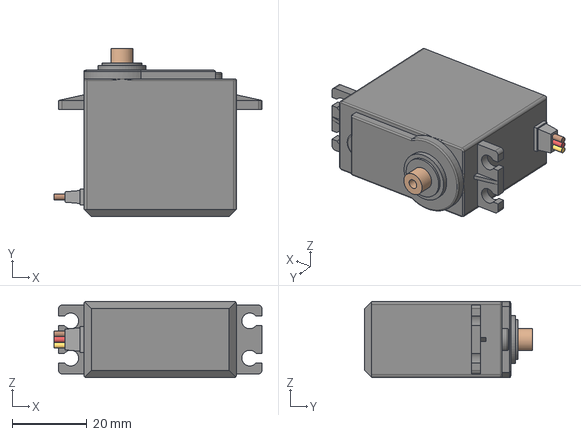
[picture p165: CAD file, 2026-10-31]
media/scara-arm/scara-robot-arm/solidworks/Servo Motor MG996R 3D Model.step
55.8 x 45.2 x 20.5 mm
