arjun7n9s/AgriBot/cad/arm-v2/step/t-12.step

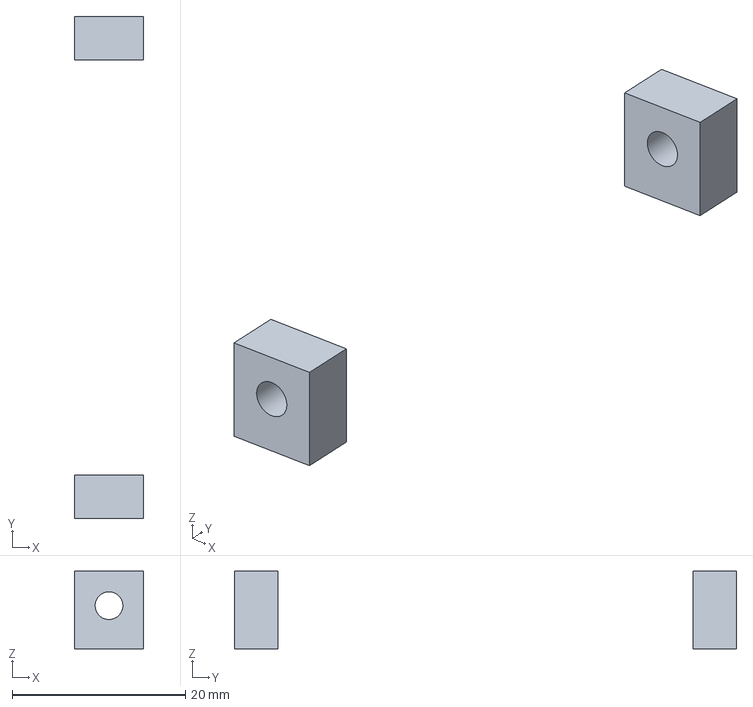
[picture p166: CAD file, 2026-11-03]
cad/arm-v2/step/t-12.step
8.00 x 58.0 x 9.00 mm
