arjun7n9s/AgriBot/cad/arm-v2/step/a1-02.step

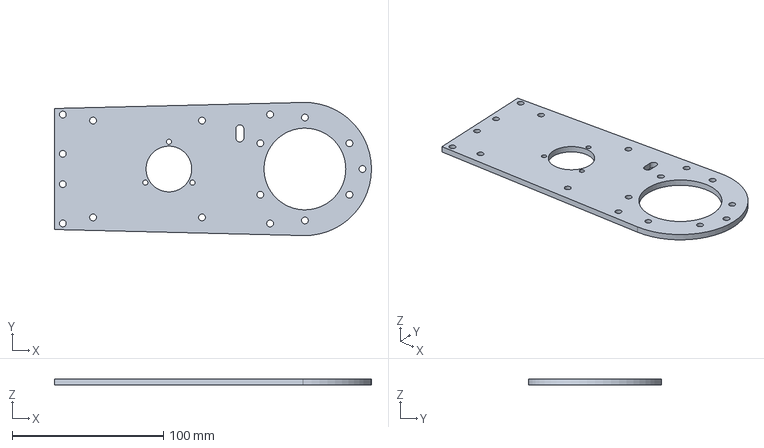
[picture p167: CAD file, 2026-11-03]
cad/arm-v2/step/a1-02.step
209.5 x 88.0 x 4.00 mm
