arjun7n9s/AgriBot/media/scara-arm/scara-robot-arm/solidworks/GT2 Pulley - 23 - 80 teeth.SLDPRT

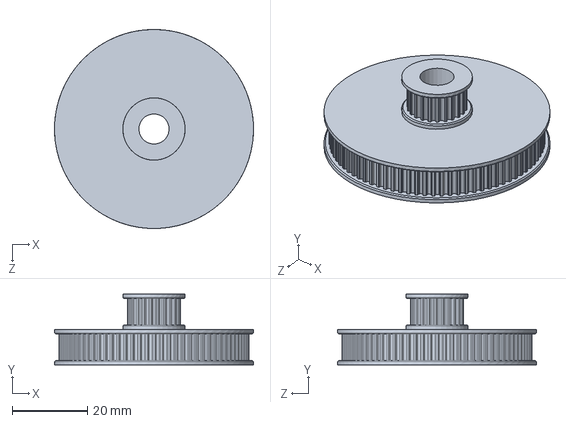
[picture p168: CAD file, 2026-10-31]
media/scara-arm/scara-robot-arm/solidworks/GT2 Pulley - 23 - 80 teeth.SLDPRT
52.8 x 18.8 x 52.8 mm
