arjun7n9s/AgriBot/media/scara-arm/scara-robot-arm/solidworks/J3 Coupler.SLDPRT

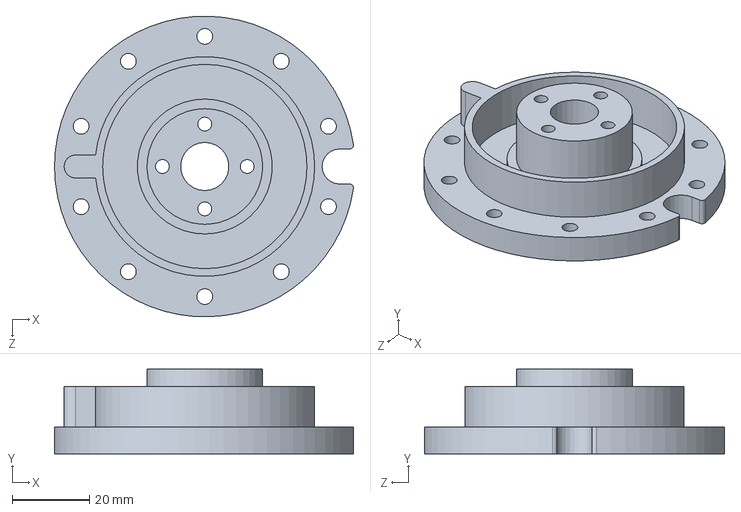
[picture p169: CAD file, 2026-10-31]
media/scara-arm/scara-robot-arm/solidworks/J3 Coupler.SLDPRT
77.6 x 22.0 x 78.0 mm
