arjun7n9s/AgriBot/media/scara-arm/scara-robot-arm/solidworks/Gripper Cover.SLDPRT

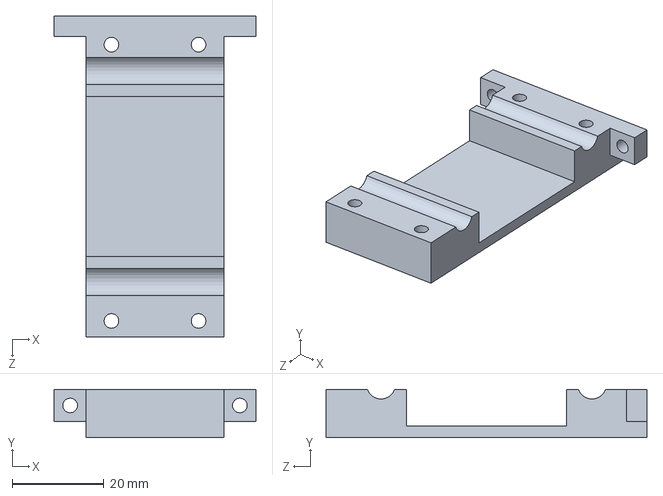
[picture p170: CAD file, 2026-10-31]
media/scara-arm/scara-robot-arm/solidworks/Gripper Cover.SLDPRT
44.0 x 10.5 x 70.0 mm
