arjun7n9s/AgriBot/media/scara-arm/scara-robot-arm/solidworks/Ball Bearing 608 - 8x22x7mm.SLDPRT

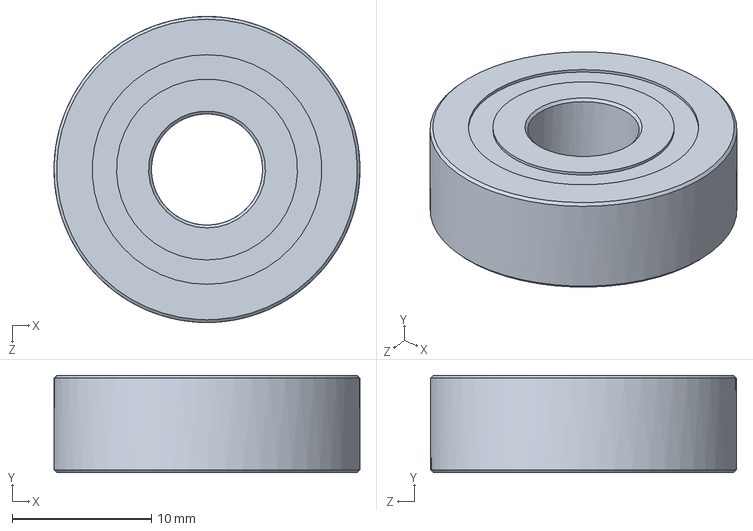
[picture p171: CAD file, 2026-10-31]
media/scara-arm/scara-robot-arm/solidworks/Ball Bearing 608 - 8x22x7mm.SLDPRT
22.0 x 7.00 x 22.0 mm
