arjun7n9s/AgriBot/media/scara-arm/scara-robot-arm/solidworks/Micro switch.step

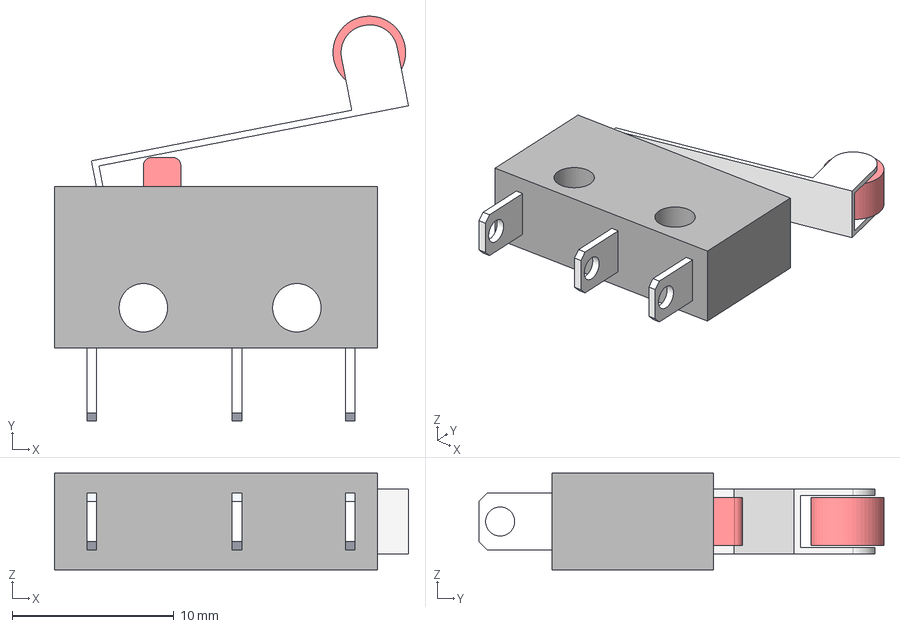
[picture p172: CAD file, 2026-10-31]
media/scara-arm/scara-robot-arm/solidworks/Micro switch.step
21.9 x 25.0 x 6.00 mm
