arjun7n9s/AgriBot/media/scara-arm/scara-robot-arm/solidworks/Arm 2.SLDPRT

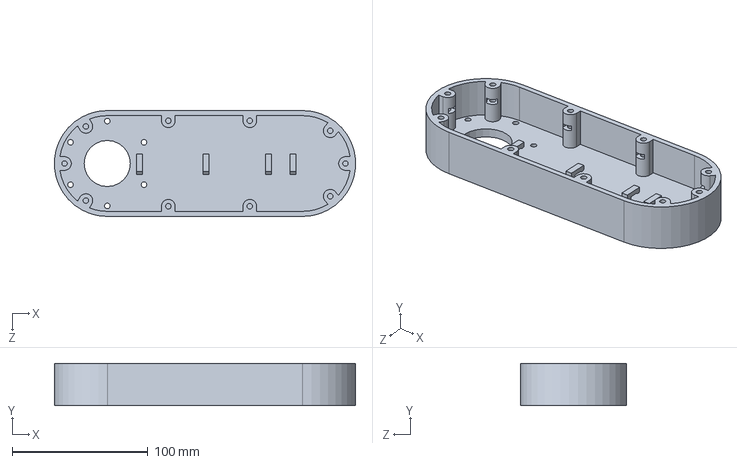
[picture p173: CAD file, 2026-10-31]
media/scara-arm/scara-robot-arm/solidworks/Arm 2.SLDPRT
221.7 x 31.0 x 78.0 mm
