arjun7n9s/AgriBot/media/scara-arm/scara-robot-arm/solidworks/NEMA 17 Stepper L24mm - 20mm shaft.step

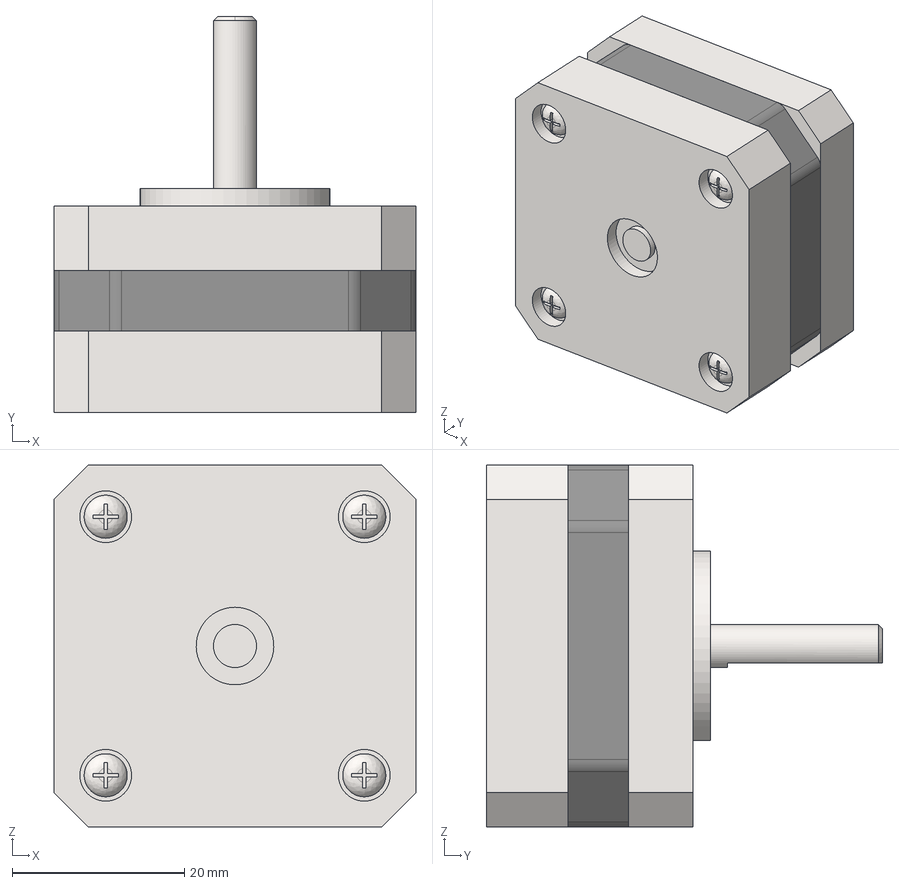
[picture p174: CAD file, 2026-10-31]
media/scara-arm/scara-robot-arm/solidworks/NEMA 17 Stepper L24mm - 20mm shaft.step
42.0 x 46.0 x 42.0 mm
