arjun7n9s/AgriBot/media/scara-arm/scara-robot-arm/solidworks/Linear Bearing 10x19x29mm.SLDPRT

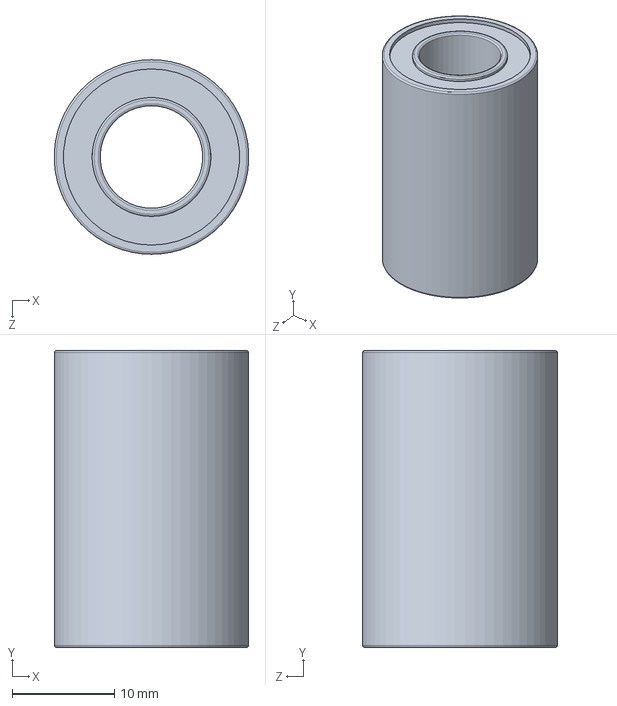
[picture p175: CAD file, 2026-10-31]
media/scara-arm/scara-robot-arm/solidworks/Linear Bearing 10x19x29mm.SLDPRT
19.0 x 29.0 x 19.0 mm
