arjun7n9s/AgriBot/media/scara-arm/scara-robot-arm/solidworks/GT2 Pulley - 90 teeth - J3.SLDPRT

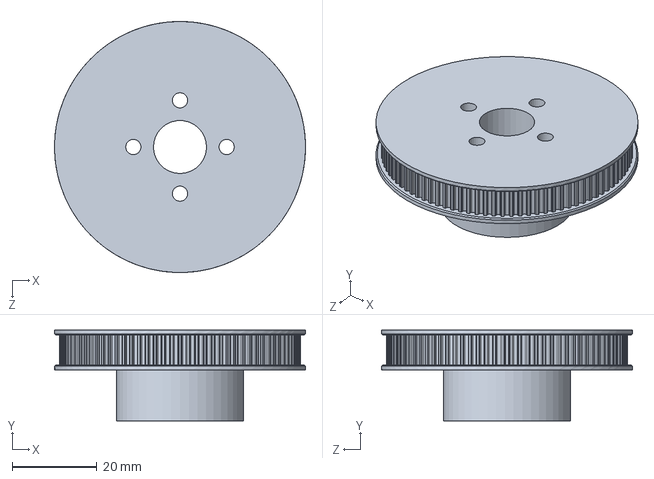
[picture p176: CAD file, 2026-10-31]
media/scara-arm/scara-robot-arm/solidworks/GT2 Pulley - 90 teeth - J3.SLDPRT
59.2 x 21.4 x 59.2 mm
