arjun7n9s/AgriBot/media/scara-arm/scara-robot-arm/solidworks/GT2 Pulley - 92 teeth - J2.SLDPRT

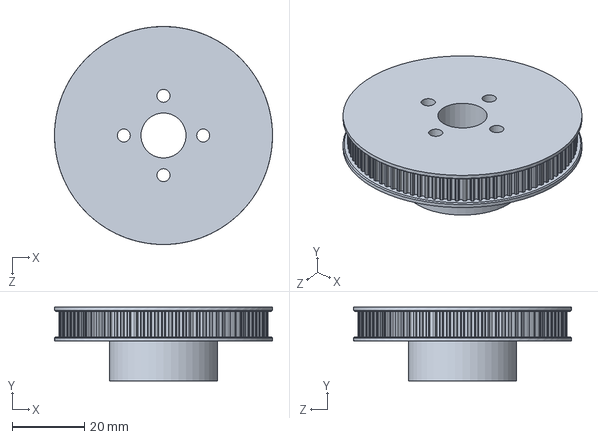
[picture p177: CAD file, 2026-10-31]
media/scara-arm/scara-robot-arm/solidworks/GT2 Pulley - 92 teeth - J2.SLDPRT
60.4 x 20.4 x 60.5 mm
