arjun7n9s/AgriBot/media/scara-arm/scara-robot-arm/solidworks/Stepper NEMA 17 -  20mm shaft.step

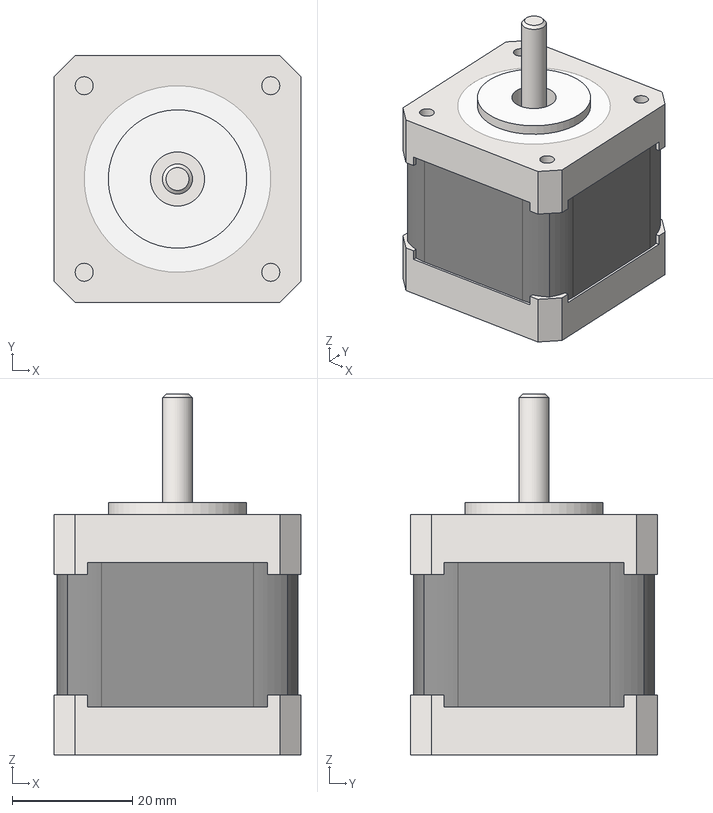
[picture p178: CAD file, 2026-10-31]
media/scara-arm/scara-robot-arm/solidworks/Stepper NEMA 17 - 20mm shaft.step
41.0 x 41.0 x 60.0 mm
