arjun7n9s/AgriBot/media/scara-arm/scara-robot-arm/solidworks/GT2 Belt 400mm 2.SLDPRT

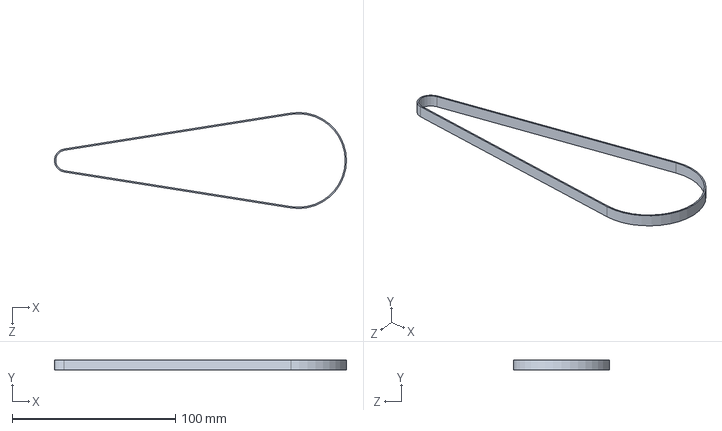
[picture p179: CAD file, 2026-10-31]
media/scara-arm/scara-robot-arm/solidworks/GT2 Belt 400mm 2.SLDPRT
179.0 x 6.00 x 58.9 mm
