arjun7n9s/AgriBot/media/scara-arm/scara-robot-arm/solidworks/GT2 Belt 200mm.SLDPRT

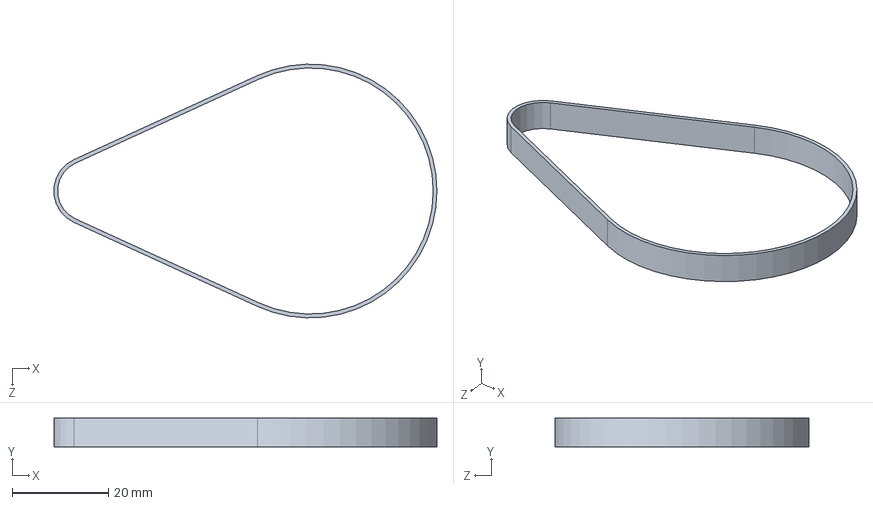
[picture p180: CAD file, 2026-10-31]
media/scara-arm/scara-robot-arm/solidworks/GT2 Belt 200mm.SLDPRT
79.4 x 6.00 x 52.6 mm
