arjun7n9s/AgriBot/media/scara-arm/scara-robot-arm/solidworks/J2 Coupler.SLDPRT

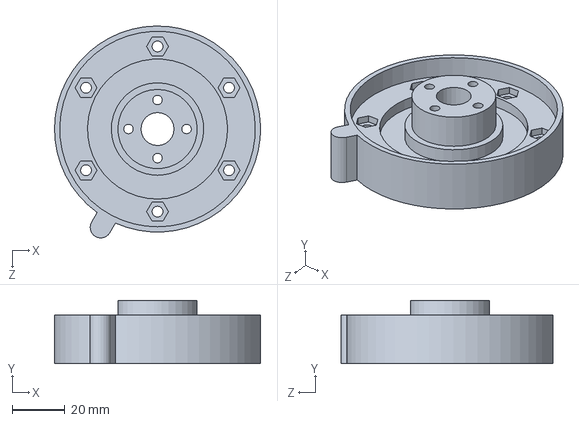
[picture p181: CAD file, 2026-10-31]
media/scara-arm/scara-robot-arm/solidworks/J2 Coupler.SLDPRT
78.0 x 24.0 x 80.2 mm
