arjun7n9s/AgriBot/media/scara-arm/scara-robot-arm/solidworks/Gripper link 2.SLDPRT

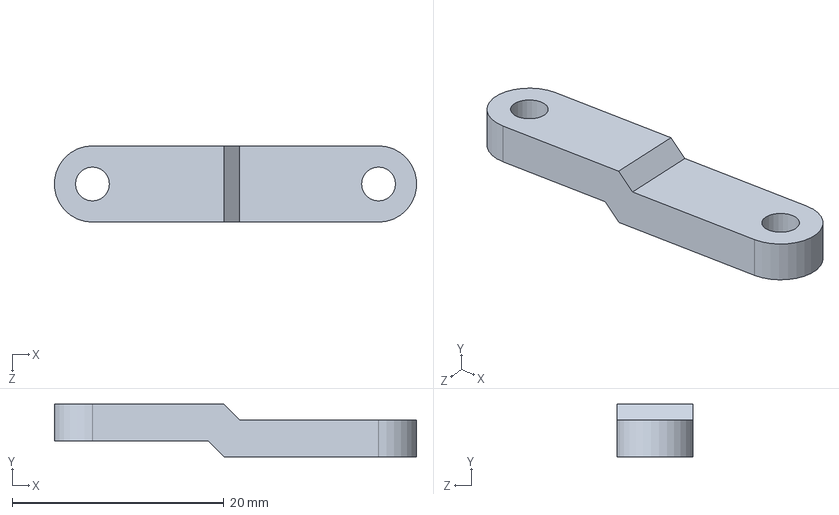
[picture p182: CAD file, 2026-10-31]
media/scara-arm/scara-robot-arm/solidworks/Gripper link 2.SLDPRT
34.2 x 5.00 x 7.20 mm
