arjun7n9s/AgriBot/media/scara-arm/scara-robot-arm/solidworks/Gripper to J3 connector.SLDPRT

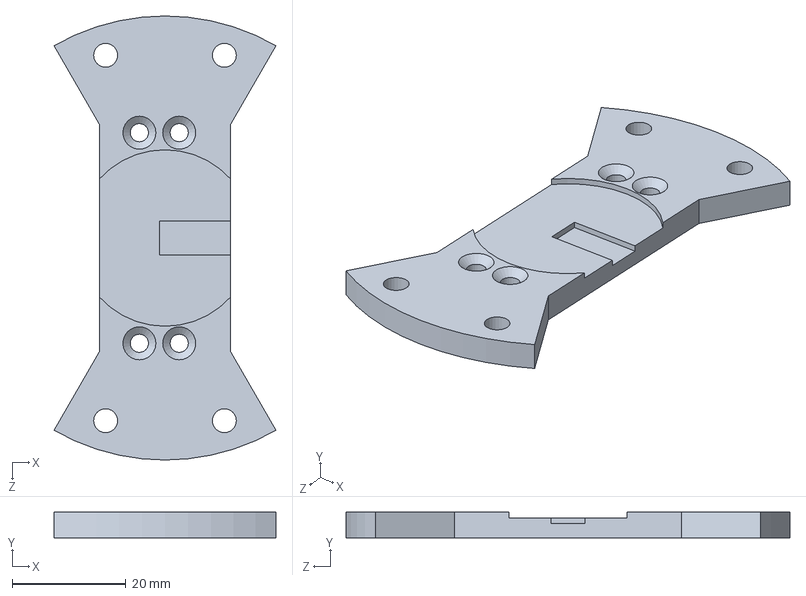
[picture p183: CAD file, 2026-10-31]
media/scara-arm/scara-robot-arm/solidworks/Gripper to J3 connector.SLDPRT
39.0 x 4.50 x 78.0 mm
