arjun7n9s/AgriBot/media/scara-arm/scara-robot-arm/solidworks/GT2 Pulley - 110 teeth - J1.SLDPRT

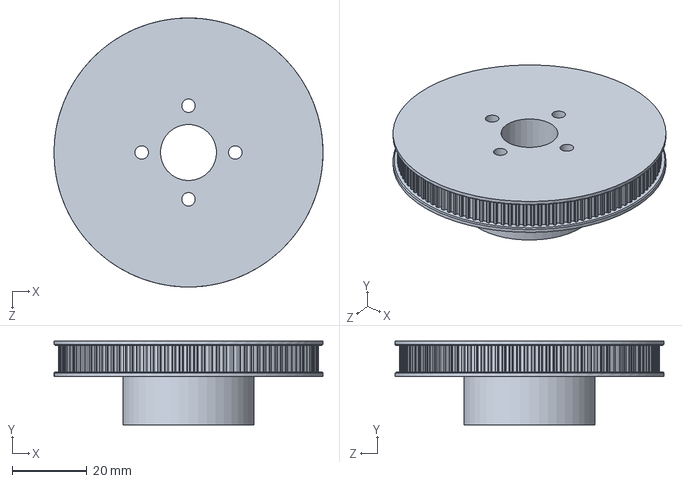
[picture p184: CAD file, 2026-10-31]
media/scara-arm/scara-robot-arm/solidworks/GT2 Pulley - 110 teeth - J1.SLDPRT
71.9 x 22.4 x 71.9 mm
