arjun7n9s/AgriBot/media/scara-arm/scara-robot-arm/solidworks/Thrust Bearing 35x52x12mm.SLDPRT

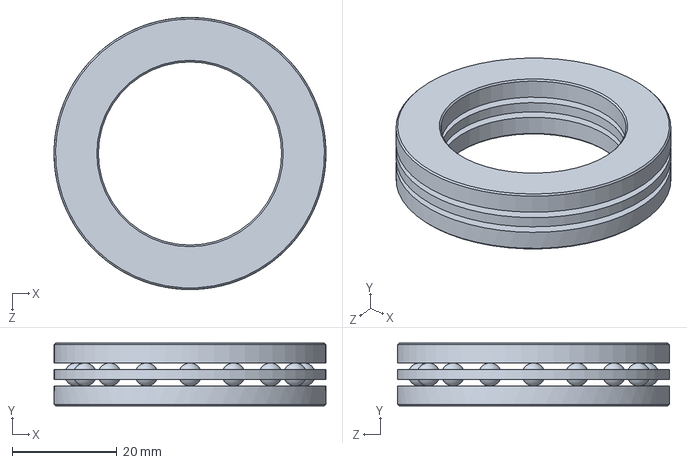
[picture p185: CAD file, 2026-10-31]
media/scara-arm/scara-robot-arm/solidworks/Thrust Bearing 35x52x12mm.SLDPRT
52.0 x 12.0 x 52.0 mm
