arjun7n9s/AgriBot/media/scara-arm/scara-robot-arm/solidworks/Smooth Rod Clamp.SLDPRT

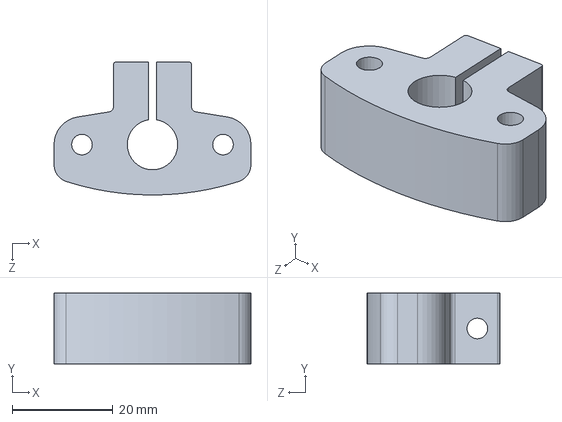
[picture p186: CAD file, 2026-10-31]
media/scara-arm/scara-robot-arm/solidworks/Smooth Rod Clamp.SLDPRT
39.1 x 14.0 x 26.4 mm
