arjun7n9s/AgriBot/media/scara-arm/scara-robot-arm/solidworks/GT2 Belt 300mm 2.SLDPRT

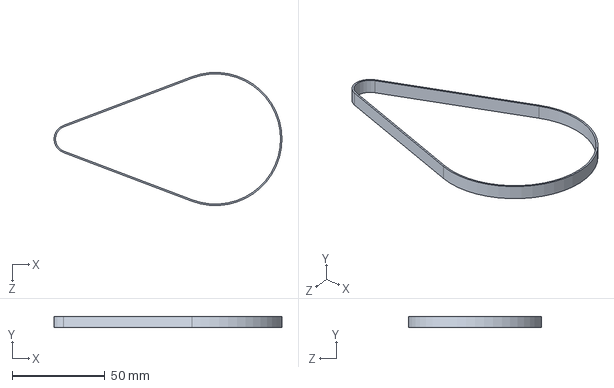
[picture p187: CAD file, 2026-10-31]
media/scara-arm/scara-robot-arm/solidworks/GT2 Belt 300mm 2.SLDPRT
122.6 x 6.00 x 71.5 mm
