arjun7n9s/AgriBot/media/scara-arm/scara-robot-arm/solidworks/J1 coupler.SLDPRT

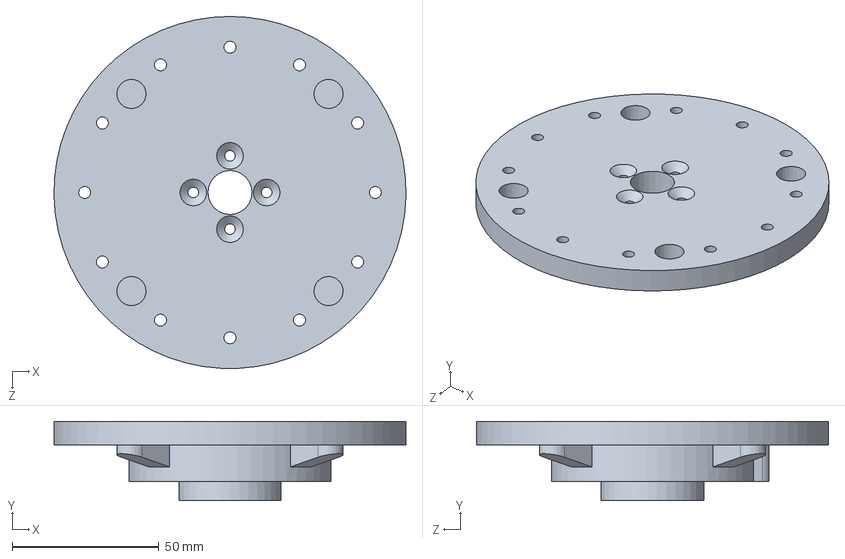
[picture p188: CAD file, 2026-10-31]
media/scara-arm/scara-robot-arm/solidworks/J1 coupler.SLDPRT
120.0 x 27.0 x 120.0 mm
