arjun7n9s/AgriBot/media/scara-arm/scara-robot-arm/solidworks/GT2 Belt 400mm.SLDPRT

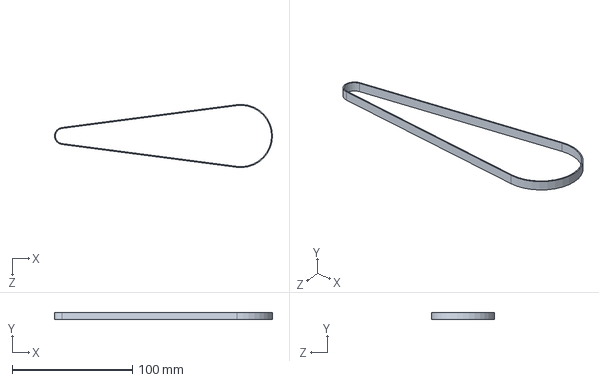
[picture p189: CAD file, 2026-10-31]
media/scara-arm/scara-robot-arm/solidworks/GT2 Belt 400mm.SLDPRT
181.4 x 6.00 x 52.5 mm
