arjun7n9s/AgriBot/media/scara-arm/scara-robot-arm/solidworks/Servo MG996R Horn.step

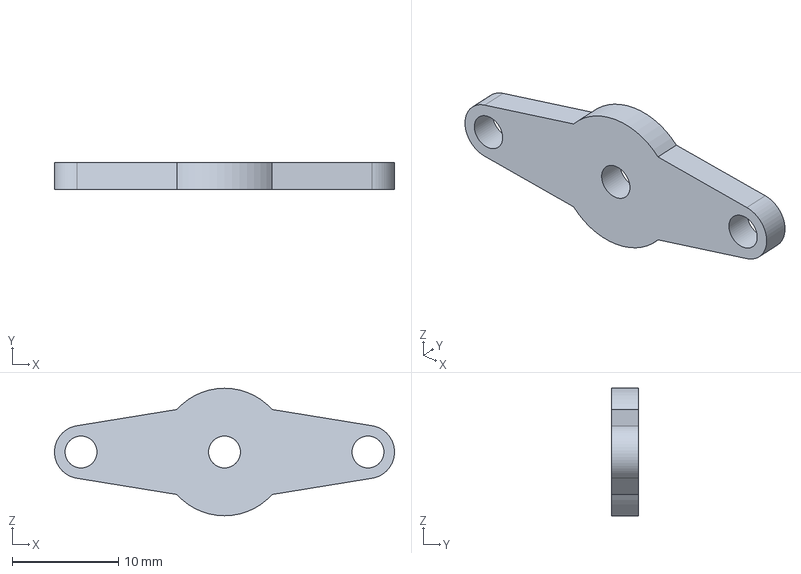
[picture p190: CAD file, 2026-10-31]
media/scara-arm/scara-robot-arm/solidworks/Servo MG996R Horn.step
32.0 x 2.50 x 12.0 mm
