arjun7n9s/AgriBot/media/scara-arm/scara-robot-arm/solidworks/Z-axis Bottom Plate.SLDPRT

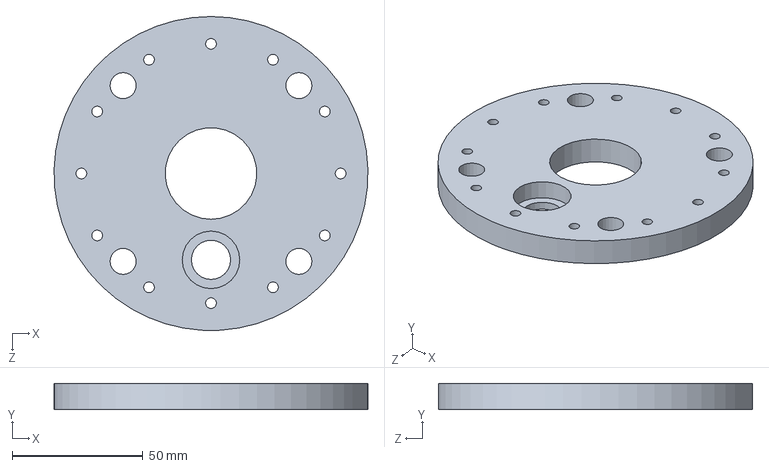
[picture p191: CAD file, 2026-10-31]
media/scara-arm/scara-robot-arm/solidworks/Z-axis Bottom Plate.SLDPRT
119.9 x 10.0 x 120.0 mm
