arjun7n9s/AgriBot/media/scara-arm/scara-robot-arm/solidworks/Ball Bearing 30x42x7mm.SLDPRT

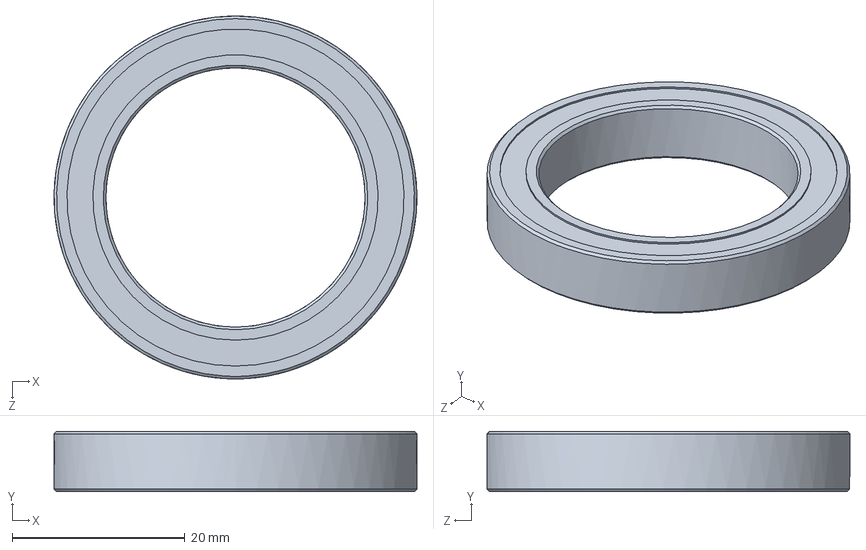
[picture p192: CAD file, 2026-10-31]
media/scara-arm/scara-robot-arm/solidworks/Ball Bearing 30x42x7mm.SLDPRT
42.0 x 7.00 x 42.0 mm
