arjun7n9s/AgriBot/media/scara-arm/scara-robot-arm/solidworks/Arduino UNO case p1.SLDPRT

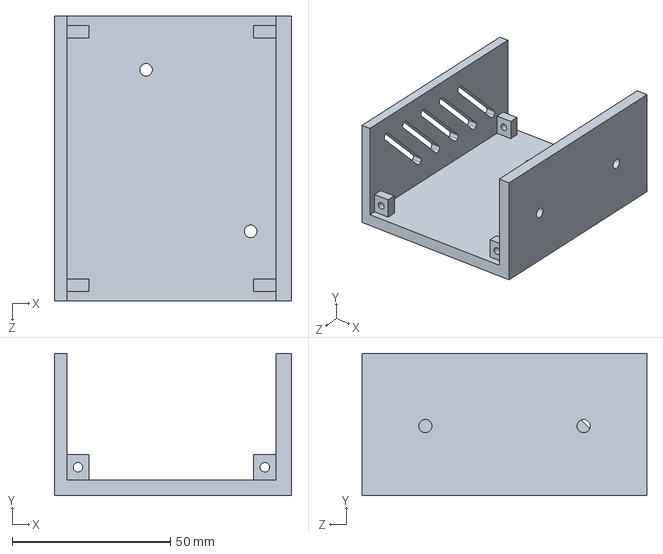
[picture p193: CAD file, 2026-10-31]
media/scara-arm/scara-robot-arm/solidworks/Arduino UNO case p1.SLDPRT
75.0 x 45.0 x 90.0 mm
