arjun7n9s/AgriBot/media/scara-arm/scara-robot-arm/solidworks/GT2 Belt 300mm.SLDPRT

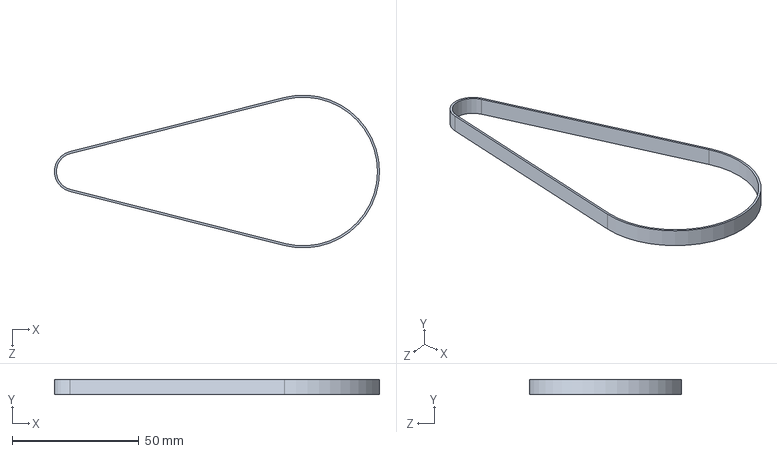
[picture p194: CAD file, 2026-10-31]
media/scara-arm/scara-robot-arm/solidworks/GT2 Belt 300mm.SLDPRT
128.1 x 6.00 x 60.1 mm
