arjun7n9s/AgriBot/(list of files, cad)

Other CAD files:
media/scara-arm/scara-robot-arm/stl/Gripper Wide end.STL
media/scara-arm/scara-robot-arm/stl/Laser module holder.STL
media/scara-arm/scara-robot-arm/solidworks/Wide gripper end - Left side.SLDPRT
media/scara-arm/scara-robot-arm/solidworks/Servo Holder.SLDPRT
media/scara-arm/scara-robot-arm/solidworks/Gripper Hand Right.SLDPRT
media/scara-arm/scara-robot-arm/solidworks/GT2 Pulley - 22 - 80 teeth.SLDPRT
cad/arm-v2/dxf/a1-01.dxf
cad/arm-v2/dxf/a1-02.dxf
cad/arm-v2/dxf/a2-01.dxf
cad/arm-v2/dxf/a2-02.dxf
cad/arm-v2/dxf/t-01.dxf
cad/arm-v2/dxf/t-02.dxf
cad/arm-v2/dxf/t-03.dxf
cad/arm-v2/dxf/t-04.dxf
cad/arm-v2/stl/j2-02.stl
cad/arm-v2/stl/j3-02.stl
cad/arm-v2/stl/t-05.stl
cad/arm-v2/stl/t-06.stl
cad/arm-v2/stl/t-07.stl
cad/arm-v2/stl/t-09.stl
cad/arm-v2/stl/t-10.stl
cad/arm-v2/stl/t-11.stl
cad/arm-v2/stl/t-12.stl
cad/arm-v2/stl/t-13.stl
cad/arm-v2/stl/t-14.stl
media/scara-arm/scara-robot-arm/laser/Laser Module 5.5W.SLDPRT
media/scara-arm/scara-robot-arm/laser/Laser module holder.SLDPRT
media/scara-arm/scara-robot-arm/laser/Laser module holder.STL
media/scara-arm/scara-robot-arm/solidworks/Lead Screw D8mm L380mm.SLDPRT
media/scara-arm/scara-robot-arm/solidworks/Lead Screw Nut 8mm.SLDPRT
media/scara-arm/scara-robot-arm/solidworks/M4 50mm - Bolts.SLDPRT
media/scara-arm/scara-robot-arm/solidworks/M4 50mm - Bolts.step
media/scara-arm/scara-robot-arm/solidworks/M4 60mm - Bolts.SLDPRT
media/scara-arm/scara-robot-arm/solidworks/M4 60mm - Bolts.step
media/scara-arm/scara-robot-arm/solidworks/M4 Lock nut.SLDPRT
media/scara-arm/scara-robot-arm/solidworks/M4 Lock nut.step
media/scara-arm/scara-robot-arm/solidworks/M8 45mm - Bolts.SLDPRT
media/scara-arm/scara-robot-arm/solidworks/M8 45mm - Bolts.step
media/scara-arm/scara-robot-arm/solidworks/M8 Lock nut.SLDPRT
media/scara-arm/scara-robot-arm/solidworks/M8 Lock nut.step
media/scara-arm/scara-robot-arm/solidworks/M8 Washer.SLDPRT
media/scara-arm/scara-robot-arm/solidworks/Micro switch.SLDPRT
media/scara-arm/scara-robot-arm/solidworks/NEMA 17 Stepper L24mm - 20mm shaft.SLDPRT
media/scara-arm/scara-robot-arm/solidworks/Servo MG996R Horn.SLDPRT
media/scara-arm/scara-robot-arm/solidworks/Servo Motor MG996R 3D Model.SLDPRT
media/scara-arm/scara-robot-arm/solidworks/Stepper NEMA 17 - 20mm shaft.SLDPRT
media/scara-arm/scara-robot-arm/stl/Arduino UNO case p1.STL
media/scara-arm/scara-robot-arm/stl/Arduino UNO case p2.STL
media/scara-arm/scara-robot-arm/stl/Arm 1 Cover.STL
media/scara-arm/scara-robot-arm/stl/Arm 1.STL
media/scara-arm/scara-robot-arm/stl/Arm 2 Cover.STL
media/scara-arm/scara-robot-arm/stl/Arm 2.STL
media/scara-arm/scara-robot-arm/stl/Base cover.STL
media/scara-arm/scara-robot-arm/stl/Base.STL
media/scara-arm/scara-robot-arm/stl/GT2 Pulley - 110 teeth - J1.STL
media/scara-arm/scara-robot-arm/stl/GT2 Pulley - 22 - 80 teeth.STL
media/scara-arm/scara-robot-arm/stl/GT2 Pulley - 23 - 80 teeth.STL
media/scara-arm/scara-robot-arm/stl/GT2 Pulley - 90 teeth - J3.STL
media/scara-arm/scara-robot-arm/stl/GT2 Pulley - 92 teeth - J2.STL
media/scara-arm/scara-robot-arm/stl/GT2 Pulley - Parametric.STL
media/scara-arm/scara-robot-arm/stl/Gripper Cover.STL
media/scara-arm/scara-robot-arm/stl/Gripper End.STL
media/scara-arm/scara-robot-arm/stl/Gripper Hand Left.STL
media/scara-arm/scara-robot-arm/stl/Gripper Hand Right.STL
media/scara-arm/scara-robot-arm/stl/Gripper Mechanism Slider.STL
media/scara-arm/scara-robot-arm/stl/Gripper link 1.STL
media/scara-arm/scara-robot-arm/stl/Gripper link 2.STL
media/scara-arm/scara-robot-arm/stl/Gripper to J3 connector.STL
media/scara-arm/scara-robot-arm/stl/J1 coupler.STL
media/scara-arm/scara-robot-arm/stl/J2 Coupler.STL
media/scara-arm/scara-robot-arm/stl/J3 Coupler.STL
media/scara-arm/scara-robot-arm/stl/Smooth Rod Clamp.STL
media/scara-arm/scara-robot-arm/stl/Top cover.STL
media/scara-arm/scara-robot-arm/stl/Wide gripper end - Left side.STL
media/scara-arm/scara-robot-arm/stl/Z-axis Bottom Plate.STL
media/scara-arm/scara-robot-arm/stl/Z-axis Mount Platform.STL
media/scara-arm/scara-robot-arm/stl/Z-axis Top Plate.STL
