arjun7n9s/AgriBot/sim/agribot_autonomy/test/data/front_row_centred.png

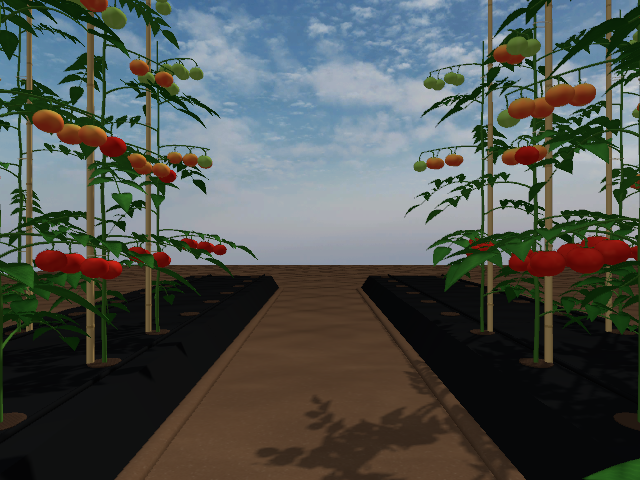
sim/agribot_autonomy/test/data/front_row_centred.png
