arjun7n9s/AgriBot/sim/agribot_autonomy/test/data/front_row_later.png

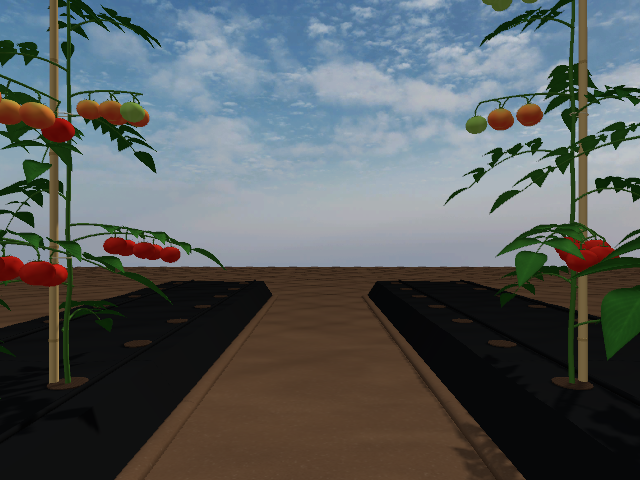
sim/agribot_autonomy/test/data/front_row_later.png
