arjun7n9s/AgriBot/sim/agribot_description/urdf/agribot.urdf

<?xml version="1.0"?>
<!--
  AgriBOT robot description. Generated by tools/description/write_urdf.py from
  measured and estimated data; edit the generator, not this file.
  Expanded defaults: tool = cutter, mast_pin = 2.
-->
<robot name="agribot">
  <link name="base_footprint"/>
  <link name="base_link">
    <inertial>
      <!-- estimate: ride-on chassis with batteries -->
      <origin xyz="0 0 0.205" rpy="0 0 0"/>
      <mass value="30"/>
      <inertia ixx="1.4065" ixy="0" ixz="0" iyy="4.00525" iyz="0" izz="3.89925"/>
    </inertial>
    <visual>
      <origin xyz="0 0 0" rpy="0 0 0"/>
      <geometry><mesh filename="package://agribot_description/meshes/rover/visual/rover_body.obj"/></geometry>
    </visual>
    <collision>
      <origin xyz="0 0 0.205" rpy="0 0 0"/>
      <geometry><box size="1.14 0.51 0.55"/></geometry>
    </collision>
  </link>
  <joint name="base_joint" type="fixed">
    <parent link="base_footprint"/>
    <child link="base_link"/>
    <origin xyz="0 0 0.19" rpy="0 0 0"/>
  </joint>
  <link name="front_left_knuckle">
    <inertial>
      <!-- estimate -->
      <origin xyz="0 0 0" rpy="0 0 0"/>
      <mass value="0.3"/>
      <inertia ixx="0.00013" ixy="0" ixz="0" iyy="0.00013" iyz="0" izz="8e-05"/>
    </inertial>
  </link>
  <link name="front_right_knuckle">
    <inertial>
      <!-- estimate -->
      <origin xyz="0 0 0" rpy="0 0 0"/>
      <mass value="0.3"/>
      <inertia ixx="0.00013" ixy="0" ixz="0" iyy="0.00013" iyz="0" izz="8e-05"/>
    </inertial>
  </link>
  <joint name="steer_joint" type="revolute">
    <!-- the steering motor; steer_right_joint follows it -->
    <parent link="base_link"/>
    <child link="front_left_knuckle"/>
    <origin xyz="0.36 0.275 0" rpy="0 0 0"/>
    <axis xyz="0 0 1"/>
    <limit lower="-0.436332" upper="0.436332" effort="20" velocity="1"/>
    <dynamics damping="0.5" friction="0.05"/>
  </joint>
  <joint name="steer_right_joint" type="revolute">
    <!-- linked to steer_joint (parallel steer) -->
    <parent link="base_link"/>
    <child link="front_right_knuckle"/>
    <origin xyz="0.36 -0.275 0" rpy="0 0 0"/>
    <axis xyz="0 0 1"/>
    <limit lower="-0.436332" upper="0.436332" effort="20" velocity="1"/>
    <dynamics damping="0.5" friction="0.05"/>
    <mimic joint="steer_joint" multiplier="1" offset="0"/>
  </joint>
  <link name="front_left_wheel">
    <inertial>
      <!-- estimate -->
      <origin xyz="0 0 0" rpy="0 0 0"/>
      <mass value="1.5"/>
      <inertia ixx="0.01635" ixy="0" ixz="0" iyy="0.027075" iyz="0" izz="0.01635"/>
    </inertial>
    <visual>
      <origin xyz="0 0 0" rpy="0 0 0"/>
      <geometry><mesh filename="package://agribot_description/meshes/rover/visual/wheel.obj"/></geometry>
    </visual>
    <collision>
      <origin xyz="0 0 0" rpy="1.5708 0 0"/>
      <geometry><cylinder radius="0.19" length="0.15"/></geometry>
    </collision>
  </link>
  <joint name="front_left_wheel_joint" type="continuous">
    <parent link="front_left_knuckle"/>
    <child link="front_left_wheel"/>
    <origin xyz="0 0 0" rpy="0 0 0"/>
    <axis xyz="0 1 0"/>
    <limit effort="40" velocity="6"/>
    <dynamics damping="0.2" friction="0.05"/>
  </joint>
  <link name="front_right_wheel">
    <inertial>
      <!-- estimate -->
      <origin xyz="0 0 0" rpy="0 0 0"/>
      <mass value="1.5"/>
      <inertia ixx="0.01635" ixy="0" ixz="0" iyy="0.027075" iyz="0" izz="0.01635"/>
    </inertial>
    <visual>
      <origin xyz="0 0 0" rpy="0 0 0"/>
      <geometry><mesh filename="package://agribot_description/meshes/rover/visual/wheel.obj"/></geometry>
    </visual>
    <collision>
      <origin xyz="0 0 0" rpy="1.5708 0 0"/>
      <geometry><cylinder radius="0.19" length="0.15"/></geometry>
    </collision>
  </link>
  <joint name="front_right_wheel_joint" type="continuous">
    <parent link="front_right_knuckle"/>
    <child link="front_right_wheel"/>
    <origin xyz="0 0 0" rpy="0 0 0"/>
    <axis xyz="0 1 0"/>
    <limit effort="40" velocity="6"/>
    <dynamics damping="0.2" friction="0.05"/>
  </joint>
  <link name="rear_left_wheel">
    <inertial>
      <!-- estimate -->
      <origin xyz="0 0 0" rpy="0 0 0"/>
      <mass value="1.5"/>
      <inertia ixx="0.01635" ixy="0" ixz="0" iyy="0.027075" iyz="0" izz="0.01635"/>
    </inertial>
    <visual>
      <origin xyz="0 0 0" rpy="0 0 0"/>
      <geometry><mesh filename="package://agribot_description/meshes/rover/visual/wheel.obj"/></geometry>
    </visual>
    <collision>
      <origin xyz="0 0 0" rpy="1.5708 0 0"/>
      <geometry><cylinder radius="0.19" length="0.15"/></geometry>
    </collision>
  </link>
  <joint name="rear_left_wheel_joint" type="continuous">
    <parent link="base_link"/>
    <child link="rear_left_wheel"/>
    <origin xyz="-0.36 0.275 0" rpy="0 0 0"/>
    <axis xyz="0 1 0"/>
    <limit effort="40" velocity="6"/>
    <dynamics damping="0.2" friction="0.05"/>
  </joint>
  <link name="rear_right_wheel">
    <inertial>
      <!-- estimate -->
      <origin xyz="0 0 0" rpy="0 0 0"/>
      <mass value="1.5"/>
      <inertia ixx="0.01635" ixy="0" ixz="0" iyy="0.027075" iyz="0" izz="0.01635"/>
    </inertial>
    <visual>
      <origin xyz="0 0 0" rpy="0 0 0"/>
      <geometry><mesh filename="package://agribot_description/meshes/rover/visual/wheel.obj"/></geometry>
    </visual>
    <collision>
      <origin xyz="0 0 0" rpy="1.5708 0 0"/>
      <geometry><cylinder radius="0.19" length="0.15"/></geometry>
    </collision>
  </link>
  <joint name="rear_right_wheel_joint" type="continuous">
    <parent link="base_link"/>
    <child link="rear_right_wheel"/>
    <origin xyz="-0.36 -0.275 0" rpy="0 0 0"/>
    <axis xyz="0 1 0"/>
    <limit effort="40" velocity="6"/>
    <dynamics damping="0.2" friction="0.05"/>
  </joint>
  <link name="front_camera_link"/>
  <link name="front_camera_link_optical_frame"/>
  <joint name="front_camera_link_optical_joint" type="fixed">
    <parent link="front_camera_link"/>
    <child link="front_camera_link_optical_frame"/>
    <origin xyz="0 0 0" rpy="-1.5708 0 -1.5708"/>
  </joint>
  <joint name="front_camera_joint" type="fixed">
    <parent link="base_link"/>
    <child link="front_camera_link"/>
    <origin xyz="0.602 0 0.36" rpy="0 0 0"/>
  </joint>
  <link name="rear_camera_link"/>
  <link name="rear_camera_link_optical_frame"/>
  <joint name="rear_camera_link_optical_joint" type="fixed">
    <parent link="rear_camera_link"/>
    <child link="rear_camera_link_optical_frame"/>
    <origin xyz="0 0 0" rpy="-1.5708 0 -1.5708"/>
  </joint>
  <joint name="rear_camera_joint" type="fixed">
    <parent link="base_link"/>
    <child link="rear_camera_link"/>
    <origin xyz="-0.607 0 0.29" rpy="0 0 3.14159"/>
  </joint>
  <link name="imu_link"/>
  <joint name="imu_joint" type="fixed">
    <parent link="base_link"/>
    <child link="imu_link"/>
    <origin xyz="0 0 0.26" rpy="0 0 0"/>
  </joint>
  <link name="harvest_crate">
    <inertial>
      <!-- estimate, empty -->
      <origin xyz="0 0 0.1" rpy="0 0 0"/>
      <mass value="0.6"/>
      <inertia ixx="0.0065" ixy="0" ixz="0" iyy="0.01" iyz="0" izz="0.0125"/>
    </inertial>
    <visual>
      <origin xyz="0 0 0" rpy="0 0 0"/>
      <geometry><mesh filename="package://agribot_description/meshes/rover/visual/harvest_crate.obj"/></geometry>
    </visual>
    <collision name="floor">
      <origin xyz="0 0 0.004" rpy="0 0 0"/>
      <geometry><box size="0.4 0.3 0.008"/></geometry>
    </collision>
    <collision name="wall_left">
      <origin xyz="0 0.146 0.1" rpy="0 0 0"/>
      <geometry><box size="0.4 0.008 0.2"/></geometry>
    </collision>
    <collision name="wall_right">
      <origin xyz="0 -0.146 0.1" rpy="0 0 0"/>
      <geometry><box size="0.4 0.008 0.2"/></geometry>
    </collision>
    <collision name="wall_front">
      <origin xyz="0.196 0 0.1" rpy="0 0 0"/>
      <geometry><box size="0.008 0.3 0.2"/></geometry>
    </collision>
    <collision name="wall_rear">
      <origin xyz="-0.196 0 0.1" rpy="0 0 0"/>
      <geometry><box size="0.008 0.3 0.2"/></geometry>
    </collision>
  </link>
  <joint name="harvest_crate_joint" type="fixed">
    <parent link="base_link"/>
    <child link="harvest_crate"/>
    <origin xyz="-0.36 0.02 0.335" rpy="0 0 0"/>
  </joint>
  <link name="scout_mast">
    <inertial>
      <!-- estimate -->
      <origin xyz="0 0 0.25" rpy="0 0 0"/>
      <mass value="0.4"/>
      <inertia ixx="0.00838667" ixy="0" ixz="0" iyy="0.00838667" iyz="0" izz="0.000106667"/>
    </inertial>
    <visual>
      <origin xyz="0 0 0" rpy="0 0 0"/>
      <geometry><mesh filename="package://agribot_description/meshes/rover/visual/scout_mast.obj"/></geometry>
    </visual>
  </link>
  <joint name="scout_mast_joint" type="fixed">
    <parent link="base_link"/>
    <child link="scout_mast"/>
    <origin xyz="-0.5 0.2 0.335" rpy="0 0 0"/>
  </joint>
  <link name="scout_pan_link">
    <inertial>
      <!-- estimate -->
      <origin xyz="0 0 0.05" rpy="0 0 0"/>
      <mass value="0.15"/>
      <inertia ixx="0.00018125" ixy="0" ixz="0" iyy="0.00014125" iyz="0" izz="0.0001625"/>
    </inertial>
    <visual>
      <origin xyz="0 0 0" rpy="0 0 0"/>
      <geometry><mesh filename="package://agribot_description/meshes/rover/visual/scout_head.obj"/></geometry>
    </visual>
  </link>
  <joint name="scout_pan_joint" type="revolute">
    <!-- pan mechanism for the rotating scouting camera -->
    <parent link="scout_mast"/>
    <child link="scout_pan_link"/>
    <origin xyz="0 0 0.5" rpy="0 0 0"/>
    <axis xyz="0 0 1"/>
    <limit lower="-3.14159" upper="3.14159" effort="1" velocity="1.5"/>
    <dynamics damping="0.05" friction="0.01"/>
  </joint>
  <link name="scout_camera_link"/>
  <link name="scout_camera_link_optical_frame"/>
  <joint name="scout_camera_link_optical_joint" type="fixed">
    <parent link="scout_camera_link"/>
    <child link="scout_camera_link_optical_frame"/>
    <origin xyz="0 0 0" rpy="-1.5708 0 -1.5708"/>
  </joint>
  <joint name="scout_camera_joint" type="fixed">
    <parent link="scout_pan_link"/>
    <child link="scout_camera_link"/>
    <origin xyz="0.04 0 0.06" rpy="0 0 0"/>
  </joint>
  <link name="scara_mast">
    <inertial>
      <!-- estimate -->
      <origin xyz="0 0 0.475" rpy="0 0 0"/>
      <mass value="2.5"/>
      <inertia ixx="0.188354" ixy="0" ixz="0" iyy="0.189354" iyz="0" izz="0.00166667"/>
    </inertial>
    <visual>
      <origin xyz="0 0 0" rpy="0 0 0"/>
      <geometry><mesh filename="package://agribot_description/meshes/rover/visual/scara_mast.obj"/></geometry>
    </visual>
    <collision>
      <origin xyz="0 0 0.475" rpy="0 0 0"/>
      <geometry><box size="0.08 0.04 0.95"/></geometry>
    </collision>
  </link>
  <joint name="scara_mast_joint" type="fixed">
    <!-- side mast; the SCARA base pins on at one of five heights -->
    <parent link="base_link"/>
    <child link="scara_mast"/>
    <origin xyz="-0.12 -0.3 -0.11" rpy="0 0 0"/>
  </joint>
  <link name="scara_base_link">
    <inertial>
      <!-- estimate: mesh volumes x effective density: printed 560 kg/m3, metal 7850 kg/m3, motor 3800 kg/m3, belt 1200 kg/m3, switch 1500 kg/m3. Estimates; weigh the real parts. -->
      <origin xyz="-0.0712791 0.00956844 0.0371431" rpy="0 0 0"/>
      <mass value="0.833682"/>
      <inertia ixx="0.00124008" ixy="0.000315526" ixz="0.000159535" iyy="0.00418148" iyz="-0.000150768" izz="0.00491594"/>
    </inertial>
    <visual>
      <origin xyz="0 0 0" rpy="0 0 0"/>
      <geometry><mesh filename="package://agribot_description/meshes/scara/visual/base_link.obj"/></geometry>
    </visual>
    <collision>
      <geometry><mesh filename="package://agribot_description/meshes/scara/collision/base_link.stl"/></geometry>
    </collision>
  </link>
  <link name="scara_column_link">
    <inertial>
      <!-- estimate: mesh volumes x effective density: printed 560 kg/m3, metal 7850 kg/m3, motor 3800 kg/m3, belt 1200 kg/m3, switch 1500 kg/m3. Estimates; weigh the real parts. -->
      <origin xyz="0.00742286 3.44212e-06 0.228887" rpy="0 0 0"/>
      <mass value="1.80729"/>
      <inertia ixx="0.0462066" ixy="-1.87405e-09" ixz="-0.00165238" iyy="0.0465499" iyz="-1.66436e-07" izz="0.00324059"/>
    </inertial>
    <visual>
      <origin xyz="0 0 0" rpy="0 0 0"/>
      <geometry><mesh filename="package://agribot_description/meshes/scara/visual/column_link.obj"/></geometry>
    </visual>
    <collision>
      <geometry><mesh filename="package://agribot_description/meshes/scara/collision/column_link.stl"/></geometry>
    </collision>
  </link>
  <link name="scara_carriage_link">
    <inertial>
      <!-- estimate: mesh volumes x effective density: printed 560 kg/m3, metal 7850 kg/m3, motor 3800 kg/m3, belt 1200 kg/m3, switch 1500 kg/m3. Estimates; weigh the real parts. -->
      <origin xyz="0.0811465 -8.9567e-07 0.0295613" rpy="0 0 0"/>
      <mass value="0.946238"/>
      <inertia ixx="0.0011079" ixy="7.57917e-07" ixz="0.00164601" iyy="0.0110148" iyz="-3.88306e-07" izz="0.0109244"/>
    </inertial>
    <visual>
      <origin xyz="0 0 0" rpy="0 0 0"/>
      <geometry><mesh filename="package://agribot_description/meshes/scara/visual/carriage_link.obj"/></geometry>
    </visual>
    <collision>
      <geometry><mesh filename="package://agribot_description/meshes/scara/collision/carriage_link.stl"/></geometry>
    </collision>
  </link>
  <link name="scara_arm2_link">
    <inertial>
      <!-- estimate: mesh volumes x effective density: printed 560 kg/m3, metal 7850 kg/m3, motor 3800 kg/m3, belt 1200 kg/m3, switch 1500 kg/m3. Estimates; weigh the real parts. -->
      <origin xyz="0.0691927 8.7085e-07 -0.0313833" rpy="0 0 0"/>
      <mass value="0.569879"/>
      <inertia ixx="0.000428514" ixy="2.76917e-07" ixz="-4.59967e-05" iyy="0.00300115" iyz="-2.11427e-07" izz="0.00292892"/>
    </inertial>
    <visual>
      <origin xyz="0 0 0" rpy="0 0 0"/>
      <geometry><mesh filename="package://agribot_description/meshes/scara/visual/arm2_link.obj"/></geometry>
    </visual>
    <collision>
      <geometry><mesh filename="package://agribot_description/meshes/scara/collision/arm2_link.stl"/></geometry>
    </collision>
  </link>
  <link name="scara_wrist_link">
    <inertial>
      <!-- estimate: mesh volumes x effective density: printed 560 kg/m3, metal 7850 kg/m3, motor 3800 kg/m3, belt 1200 kg/m3, switch 1500 kg/m3. Estimates; weigh the real parts. -->
      <origin xyz="0.000443116 -0.000165271 -7.39752e-05" rpy="0 0 0"/>
      <mass value="0.0372179"/>
      <inertia ixx="1.9538e-05" ixy="-2.60341e-08" ixz="1.66016e-07" iyy="1.94947e-05" iyz="-7.77842e-08" izz="2.00665e-05"/>
    </inertial>
    <visual>
      <origin xyz="0 0 0" rpy="0 0 0"/>
      <geometry><mesh filename="package://agribot_description/meshes/scara/visual/wrist_link.obj"/></geometry>
    </visual>
    <collision>
      <geometry><mesh filename="package://agribot_description/meshes/scara/collision/wrist_link.stl"/></geometry>
    </collision>
  </link>
  <link name="scara_tool_flange"/>
  <joint name="scara_j1" type="revolute">
    <!-- limits: assumed; set from the J1 home switch and cabling; effort/velocity: estimate -->
    <parent link="scara_base_link"/>
    <child link="scara_column_link"/>
    <origin xyz="0 0 0.035" rpy="0 0 0"/>
    <axis xyz="0 0 1"/>
    <limit lower="-2.96706" upper="2.96706" effort="2" velocity="1"/>
    <dynamics damping="0.5" friction="0.05"/>
  </joint>
  <joint name="scara_z" type="prismatic">
    <!-- limits: part clearances in the STEP: platform on base cover, J2 motor at the Z top limit switch; effort/velocity: estimate -->
    <parent link="scara_column_link"/>
    <child link="scara_carriage_link"/>
    <origin xyz="0 0 0.0625" rpy="0 0 0"/>
    <axis xyz="0 0 1"/>
    <limit lower="0" upper="0.249" effort="100" velocity="0.1"/>
    <dynamics damping="2" friction="0.2"/>
  </joint>
  <joint name="scara_j2" type="revolute">
    <!-- limits: assumed; check Arm 2 against the column; effort/velocity: estimate -->
    <parent link="scara_carriage_link"/>
    <child link="scara_arm2_link"/>
    <origin xyz="0.227977 0 -0.019" rpy="0 0 0"/>
    <axis xyz="0 0 1"/>
    <limit lower="-2.61799" upper="2.61799" effort="3" velocity="1.2"/>
    <dynamics damping="0.3" friction="0.05"/>
  </joint>
  <joint name="scara_j3" type="revolute">
    <!-- limits: assumed; keeps the tool cables from winding up; effort/velocity: estimate -->
    <parent link="scara_arm2_link"/>
    <child link="scara_wrist_link"/>
    <origin xyz="0.136488 0 -0.039" rpy="0 0 0"/>
    <axis xyz="0 0 1"/>
    <limit lower="-2.61799" upper="2.61799" effort="0.8" velocity="2"/>
    <dynamics damping="0.05" friction="0.01"/>
  </joint>
  <joint name="scara_tool_flange_joint" type="fixed">
    <!-- J3 coupler underside; tools bolt on here -->
    <parent link="scara_wrist_link"/>
    <child link="scara_tool_flange"/>
    <origin xyz="0 0 -0.018" rpy="0 0 0"/>
  </joint>
  <joint name="scara_mount" type="fixed">
    <parent link="scara_mast"/>
    <child link="scara_base_link"/>
    <origin xyz="0 -0.095 0.46" rpy="0 0 0"/>
  </joint>
  <link name="scara_cutter_body">
    <inertial>
      <!-- estimate: two MG996R, PETG body, camera (docs/scara-redesign.md) -->
      <origin xyz="0.03 0 -0.07" rpy="0 0 0"/>
      <mass value="0.28"/>
      <inertia ixx="0.000714" ixy="0" ixz="0" iyy="0.000919333" iyz="0" izz="0.000583333"/>
    </inertial>
    <visual>
      <origin xyz="0 0 0" rpy="0 0 0"/>
      <geometry><mesh filename="package://agribot_description/meshes/cutter/visual/cutter_body.obj"/></geometry>
    </visual>
    <collision name="top_plate">
      <origin xyz="0.051 0 -0.05" rpy="0 0 0"/>
      <geometry><box size="0.134 0.084 0.004"/></geometry>
    </collision>
    <collision name="spine">
      <origin xyz="-0.012 0 -0.0765" rpy="0 0 0"/>
      <geometry><box size="0.008 0.09 0.147"/></geometry>
    </collision>
    <collision name="wall_right">
      <origin xyz="0.046 0.0435 -0.119" rpy="0 0 0"/>
      <geometry><box size="0.108 0.003 0.042"/></geometry>
    </collision>
    <collision name="wall_left">
      <origin xyz="0.046 -0.0435 -0.119" rpy="0 0 0"/>
      <geometry><box size="0.108 0.003 0.042"/></geometry>
    </collision>
    <collision name="servo1">
      <origin xyz="0.0263 0.0298 -0.0255" rpy="0 0 0"/>
      <geometry><box size="0.0407 0.0197 0.037"/></geometry>
    </collision>
    <collision name="camera">
      <origin xyz="-0.002 -0.07 -0.084" rpy="0 0 0"/>
      <geometry><box size="0.03 0.046 0.042"/></geometry>
    </collision>
  </link>
  <link name="scara_cutter_blade">
    <inertial>
      <!-- estimate -->
      <origin xyz="0.01 0 0.001" rpy="0 0 0"/>
      <mass value="0.008"/>
      <inertia ixx="7.73333e-08" ixy="0" ixz="0" iyy="6.10667e-07" iyz="0" izz="6.66667e-07"/>
    </inertial>
    <visual>
      <origin xyz="0 0 0" rpy="0 0 0"/>
      <geometry><mesh filename="package://agribot_description/meshes/cutter/visual/cutter_blade.obj"/></geometry>
    </visual>
  </link>
  <link name="scara_cutter_door">
    <inertial>
      <!-- estimate -->
      <origin xyz="-0.052 0 0.004" rpy="0 0 0"/>
      <mass value="0.03"/>
      <inertia ixx="1.7525e-05" ixy="0" ixz="0" iyy="2.73425e-05" iyz="0" izz="4.42625e-05"/>
    </inertial>
    <visual>
      <origin xyz="0 0 0" rpy="0 0 0"/>
      <geometry><mesh filename="package://agribot_description/meshes/cutter/visual/cutter_door.obj"/></geometry>
    </visual>
    <collision name="floor">
      <origin xyz="-0.052 0 0.0065" rpy="0 0 0"/>
      <geometry><box size="0.104 0.083 0.011"/></geometry>
    </collision>
    <collision name="lip">
      <origin xyz="0.002 0 0.015" rpy="0 0 0"/>
      <geometry><box size="0.004 0.083 0.024"/></geometry>
    </collision>
  </link>
  <link name="scara_cut_point"/>
  <link name="scara_tool0"/>
  <link name="scara_arm_camera_link"/>
  <link name="scara_arm_camera_link_optical_frame"/>
  <joint name="scara_arm_camera_link_optical_joint" type="fixed">
    <parent link="scara_arm_camera_link"/>
    <child link="scara_arm_camera_link_optical_frame"/>
    <origin xyz="0 0 0" rpy="-1.5708 0 -1.5708"/>
  </joint>
  <joint name="scara_cutter_mount" type="fixed">
    <parent link="scara_tool_flange"/>
    <child link="scara_cutter_body"/>
    <origin xyz="0 0 0" rpy="0 0 0"/>
  </joint>
  <joint name="scara_cutter_blade_joint" type="revolute">
    <!-- 0 = open, lower limit = fully closed across the throat -->
    <parent link="scara_cutter_body"/>
    <child link="scara_cutter_blade"/>
    <origin xyz="0.048 0.014 -0.047" rpy="0 0 0.261799"/>
    <axis xyz="0 0 1"/>
    <limit lower="-1.22173" upper="0" effort="0.9" velocity="3"/>
    <dynamics damping="0.01" friction="0.002"/>
  </joint>
  <joint name="scara_cutter_door_joint" type="revolute">
    <!-- 0 = closed; positive swings the floor down to drop the fruit -->
    <parent link="scara_cutter_body"/>
    <child link="scara_cutter_door"/>
    <origin xyz="0.098 0 -0.14" rpy="0 0 0"/>
    <axis xyz="0 -1 0"/>
    <limit lower="0" upper="1.309" effort="0.9" velocity="3"/>
    <dynamics damping="0.01" friction="0.002"/>
  </joint>
  <joint name="scara_cut_point_joint" type="fixed">
    <!-- centre of the 6 mm throat: the pedicel is cut here -->
    <parent link="scara_cutter_body"/>
    <child link="scara_cut_point"/>
    <origin xyz="0.0655 0 -0.05" rpy="0 0 0"/>
  </joint>
  <joint name="scara_tool0_joint" type="fixed">
    <parent link="scara_cutter_body"/>
    <child link="scara_tool0"/>
    <origin xyz="0.0655 0 -0.05" rpy="0 0 0"/>
  </joint>
  <joint name="scara_arm_camera_joint" type="fixed">
    <!-- RGB-D camera front face, pitched down -->
    <parent link="scara_cutter_body"/>
    <child link="scara_arm_camera_link"/>
    <origin xyz="0.00820322 -0.0645749 -0.085011" rpy="0 0.0872665 0.488692"/>
  </joint>
</robot>
