arjun7n9s/AgriBot/(commit log)

2026-10-31 Add project context: plans, bills of materials, board notes and photos
    Plans and designs (project context, work plan, ROS 2 demo plan, SCARA
    redesign with the tomato cutter), funding bills of materials and order
    lists, the stock control-board reverse-engineering notes with their photo
    sets, and working notes. The third-party HowToMechatronics SCARA CAD is
    kept out of the repository (see .gitignore).
2026-10-31 Add asset tooling: STEP link extraction, Blender generators, URDF writer
    - tools/scara: split the SCARA STEP into URDF links (OpenCascade), with
    mass properties from mesh volumes
    - tools/blender: shared palette, mesh, export and render helpers; builders
    for the SCARA meshes, cutter, rover and tomato field; hero render posed
    from the URDF
    - tools/description: URDF/xacro generator with structural checks and a
    small numpy FK/IK helper
2026-10-31 Add simulation packages: agribot_description and agribot_field
    agribot_description: rover, SCARA and cutter as xacro macros, a top-level
    agribot.urdf.xacro (tool:=cutter|gripper, mast_pin:=0..4), expanded URDFs,
    rover and cutter meshes (OBJ and GLB), frames and an RViz display launch.
    agribot_field: Gazebo models with glTF copies for three tomato ripeness
    stages, three staked plant variants with fruit-site lists, a tileable
    raised mulch bed and a soil tile, plus the field layout and semantic labels.
    SCARA meshes are generated locally from the third-party CAD.
    [agribot.urdf, agribot.urdf.xacro, cutter.urdf.xacro, cutter_blade.obj, cutter_body.obj, cutter_door.obj, harvest_crate.obj, model.sdf]
2026-10-31 Document the assets and refresh the README
    docs/assets.md covers every asset's source, numbers, frames, rebuild
    commands and checks. README gains the renders, the repository layout and
    getting-started steps. CHANGELOG starts at 0.1.0.
2026-10-31 Add the SCARA base CAD and its generated meshes, with credit
    The SCARA base design is adapted from HowToMechatronics; CREDITS.md says
    so. The unpacked CAD (STEP, SolidWorks, STL) goes in media/scara-arm/ and
    the link meshes generated from it in sim/agribot_description/meshes/scara/,
    so the robot description is complete on a fresh clone. The original
    download zips stay out because they duplicate the unpacked files.
    [Arduino Mega case p2.STL, Arduino Mega case.STL, Arduino UNO case p1.SLDPRT, Arduino UNO case p1.STL, Arduino UNO case p2.SLDPRT, Arduino UNO case p2.STL, Arm 1 Cover.SLDPRT, Arm 1 Cover.STL]
2026-10-31 Add asset QA, textured leaves and a handoff note
    - tools/qa/check_assets.py: quality gate for every mesh and model reference
    (parsing, units, degenerate faces, normals, relative texture paths, GLB
    embedding, package:// and model:// resolution). 29 meshes, 0 warnings,
    0 failures.
    - Leaflets get a generated texture (midrib, veins, mottling) and no longer
    produce zero-area triangles at their tips; every export now strips
    degenerate geometry.
    - CLAUDE.md records the working rules, current state and next steps for
    continuing on the Ubuntu laptop.
    - Renders refreshed.
    [cutter_blade.obj, cutter_body.obj, rover_body.obj, tomato_green.obj, tomato_half.obj, tomato_plant_a.obj, tomato_plant_b.obj, tomato_plant_c.obj]
2026-10-31 Fix assets found in Gazebo testing
    - Cutter: soft lip 16 mm above the foam, so caught fruit cannot roll out;
    arm camera moved to a side mount at fruit height (it saw only the top
    plate); trap-door axis now swings the floor down.
    - Crate: floor and wall collisions, so dropped fruit stay in.
    - SCARA: link extraction clears stale outputs (an old file had put the
    gripper servo inside the wrist's collision hull); Z damping 2 N s/m and
    0.1 m/s.
    - Fruit: collision sphere sized by the vertical semi-axis; on-plant
    collision group 0x04.
    - OBJ export adds Kd 1 1 1 to textured materials (Gazebo rendered them
    black); QA fails on the missing Kd.
    - Leaflets carry UVs and a generated texture.
    [agribot.urdf, cutter.urdf.xacro, cutter_blade.obj, cutter_body.obj, cutter_door.obj, model.sdf, rover.urdf.xacro, scara.urdf.xacro]
2026-10-31 Add agribot_gazebo: Gazebo harvest demo with ROS 2
    Gazebo Fortress world with one harvest row (tools/sim/make_world.py),
    ros2_control for wheels, steering, arm, blade, trap door and scout pan,
    cameras, IMU and ground-truth odometry, the ROS-Gazebo bridge, a cmd_vel
    drive node and the harvest mission node, which plans with IK on the URDF,
    cuts, catches, carries and drops each fruit and verifies it in the crate.
    The robot is spawned with collision groups so the arm passes through fruit
    on the trusses while the cradle and crate catch cut fruit.
    Tools: filming with a GUI camera director (tools/sim/ubuntu/film.sh,
    make_video.py), ROS graph drawing (ros_graph.py) and Ubuntu helpers.
    [agribot_gazebo.urdf.xacro, controllers.yaml, demo_row.sdf]
2026-10-31 Document the Gazebo demo with video, stills and ROS 2 evidence
    docs/simulation.md: results (2 of 2 picks verified, 0.1 mm measured cutter
    error), how to run and film it, the ROS 2 graph, measured topic rates,
    modelling limitations, and the problems found and fixed. docs/media holds
    the run video, a GIF of the first pick, stills, what the robot's cameras
    published, and the ROS 2 graph and report. README, CHANGELOG (0.2.0) and
    CLAUDE.md updated.
2026-10-31 Steering knuckles and per-wheel drive speeds
    Each front wheel now turns on its own knuckle instead of a swinging front
    axle, which scrubbed the tyres. Gazebo's ros2_control ignores mimic joints,
    so the steering controller commands both knuckles. The drive node sets each
    wheel's speed from its distance from the turn centre and recomputes the yaw
    rate from the clipped steering angle.
    [agribot.urdf, agribot_gazebo.urdf.xacro, controllers.yaml, rover.urdf.xacro]
2026-10-31 Camera row-following, fruit detection and a perception-driven harvest
    row_follower steers on the furrow seen by the front camera (near and far
    points of the fitted centre line). fruit_detector finds red blobs in the arm
    RGB-D camera, ranges them with depth and places them in the rover frame.
    harvest_mission replaces harvest_demo: it follows the row, stops at fruit in
    reach, confirms over 1.5 s, solves IK for the detected point and picks it.
    No targets come from the world file; it is used only for the cut model and
    a diagnostic. Ripeness is a colour rule for now.
2026-10-31 Docs and media for 0.3.0: perception-driven harvest
    New video, GIF, stills, camera and debug frames, ROS 2 graph and report from
    the clean run (3 of 3 picks in the crate). simulation.md covers the row
    follower, detector and mission, with results and honest limits: half-ripe
    fruit pass the colour rule, the pedicel estimate is 6-24 mm off, and the
    rover turns less than the bicycle model. assets.md records model provenance.
2026-10-31 Rename SCARA CAD folder and link the demo video by URL
    media/scara-arm/HowToMechatronics/scara-robot-arm becomes
    media/scara-arm/scara-robot-arm; paths in the extractor, kinematics JSON and
    file inventory follow. The credit in CREDITS.md and README is unchanged.
    The README and simulation doc now link the demo MP4 to its GitHub page, where
    a player opens.
    [Arduino Mega case p2.STL, Arduino Mega case.STL, Arduino UNO case p1.SLDPRT, Arduino UNO case p1.STL, Arduino UNO case p2.SLDPRT, Arduino UNO case p2.STL, Arm 1 Cover.SLDPRT, Arm 1 Cover.STL]
2026-11-01 Field scenery: drip lines, crate stacks, fence and tree line
    Visual-only static models built from SDF primitives (tools/sim/world_props.py),
    added to the generated demo world. test_world.py checks the world is well formed
    and that the scenery stays clear of the rover's path.
    [demo_row.sdf]
2026-11-01 Split the ROS stack: agribot_autonomy, agribot_interfaces, simulator-only agribot_gazebo
    - agribot_interfaces: RowState, HarvestStatus, VerifyPick and the Harvest action.
    - agribot_autonomy: row follower, fruit detector, drive node and harvest mission,
    with no Gazebo dependency. Vision, steering and mission decisions are pure
    functions. Every parameter is declared with a type and range and set in
    config/autonomy.yaml; bad values stop the node. A harvest is an action goal.
    - agribot_gazebo keeps the world, controllers, bridge, the simulated cut and crate
    check (sim_cut_model, serving /crate/verify) and filming. Launch is split into
    sim, autonomy and demo.
    - Watchdogs, stall detectio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
    [agribot_gazebo.urdf.xacro]
2026-11-01 Docs and media for 0.4.0: ROS architecture guide, new graph and camera frames
    - docs/ros-architecture.md: packages, nodes, interfaces, parameters, launch,
    failure behaviour and tests.
    - simulation.md, README, CHANGELOG and CLAUDE.md updated for the new layout and
    the 0.4.0 runs (3 of 3 filmed, 1 of 1 headless).
    - New ROS 2 graph, report and robot camera frames. The video, GIF and stills stay
    from 0.3.0: the 0.4.0 screen recording caught other windows and was not used.
2026-11-03 Add arm v2 CAD tools: build123d model, calculations, collision check, renders
    tools/cad/build_arm_v2.py builds the new Arm 1, Arm 2, J2 and J3 joints and the tomato
    cutter and writes STEP, DXF, STL and a part list. arm_v2_calcs.py covers belts, reach,
    cutter force and loads. check_arm_v2.py checks for collisions over the blade stroke,
    the door and the joint ranges. The CAD runs in its own venv (.venv-cad).
    [arm_v2_calcs.py, arm_v2_geometry.py, build_arm_v2.py]
2026-11-03 Generate arm v2 and cutter CAD: STEP, DXF, STL, part list, calcs
    [a1-01.dxf, a1-01.step, a1-02.dxf, a1-02.step, a1-03.step, a1-04.step, a1-05.step, a2-01.dxf]
2026-11-03 Document arm v2 and the tomato cutter design
    Aluminium plate links, L2 200 mm from a reach study, J3 on the spare 6806 and 6807,
    every bearing, belt and motor on hand placed. The cutter is a bypass blade-lever on a
    servo 4-bar with V capture, an IR pedicel beam, touch-off on the fruit and a padded
    door basket. Renders, reach and force plots, fabrication notes, bench tests.
